joshuartaylor/TheRecreator3D/Print Examples/271875373_10227794862356294_2848248221167341705_n.jpg

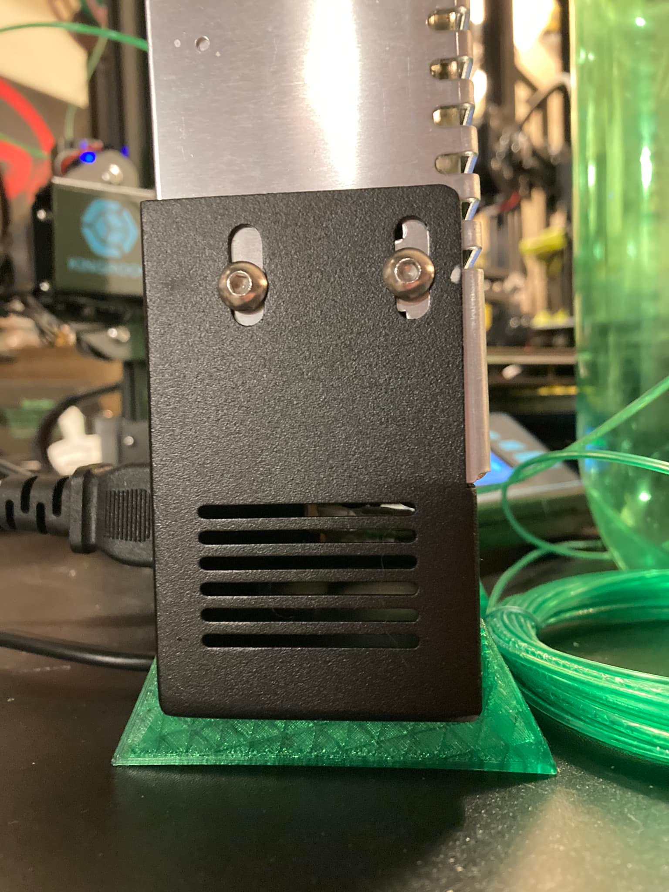
Print Examples/271875373_10227794862356294_2848248221167341705_n.jpg
