joshuartaylor/TheRecreator3D/Print Examples/204751988_10226476140269066_6664716208984511752_n.jpg

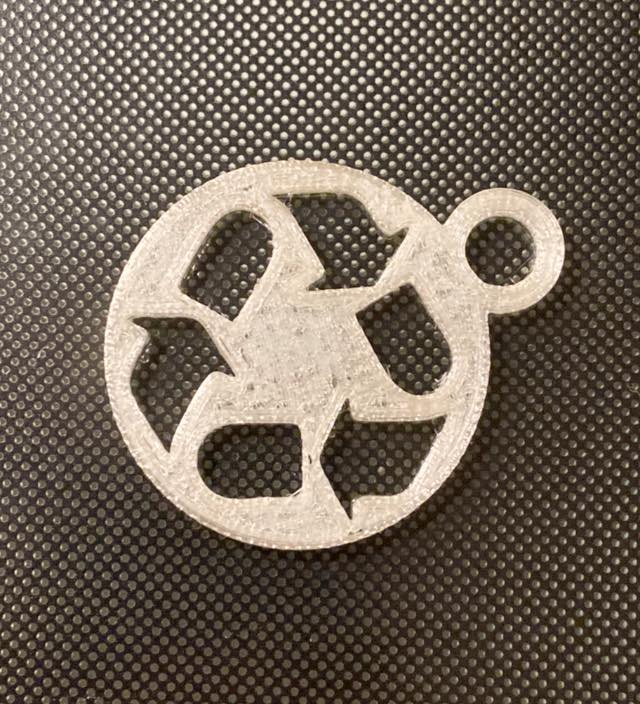
Print Examples/204751988_10226476140269066_6664716208984511752_n.jpg
