joshuartaylor/TheRecreator3D/README.md

# TheRecreator3D
 DIY 3D Printer Filament From Soda Bottles
