joshuartaylor/TheRecreator3D/Recreator3D Accessories/Community Bottle Dryer/Community Bottle Dryer.pdf

The Recreator3D
Community Bottle Dryer

Prints on a 200x200 Bed

Uses a 40MM Fan for Air Circulation

To Power the Fan, Use a 5 Volt Fan and Wire it into
a 5 Volt Power Cord for a Phone Charger or equivalent.
Just make sure to use a power source that matches your Fan's Voltage
to avoid electrical issues.

Place the fan in the center of the dryer. Sticker facing down (blowing inward). You can secure it with screws - though it's not needed.
Place the Fan Cover on top of the fan to avoid electrical water damage.

Remove the bottle label, clean the glue off and wash your bottle.
Place a bottle onto a pipe. The dryer holds 8 bottles.

A 5 Volt fan was able to help circulate the air
enough to dry the bottles in under 1 hour.
It's taken a couple days otherwise.
This definitely improves and speeds up a production routine.

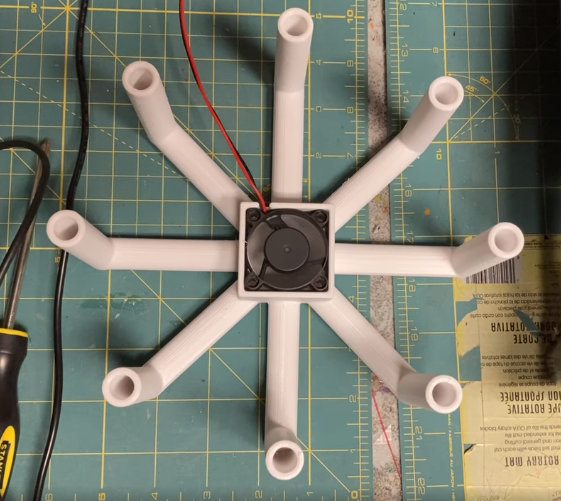
[picture p3: figure]
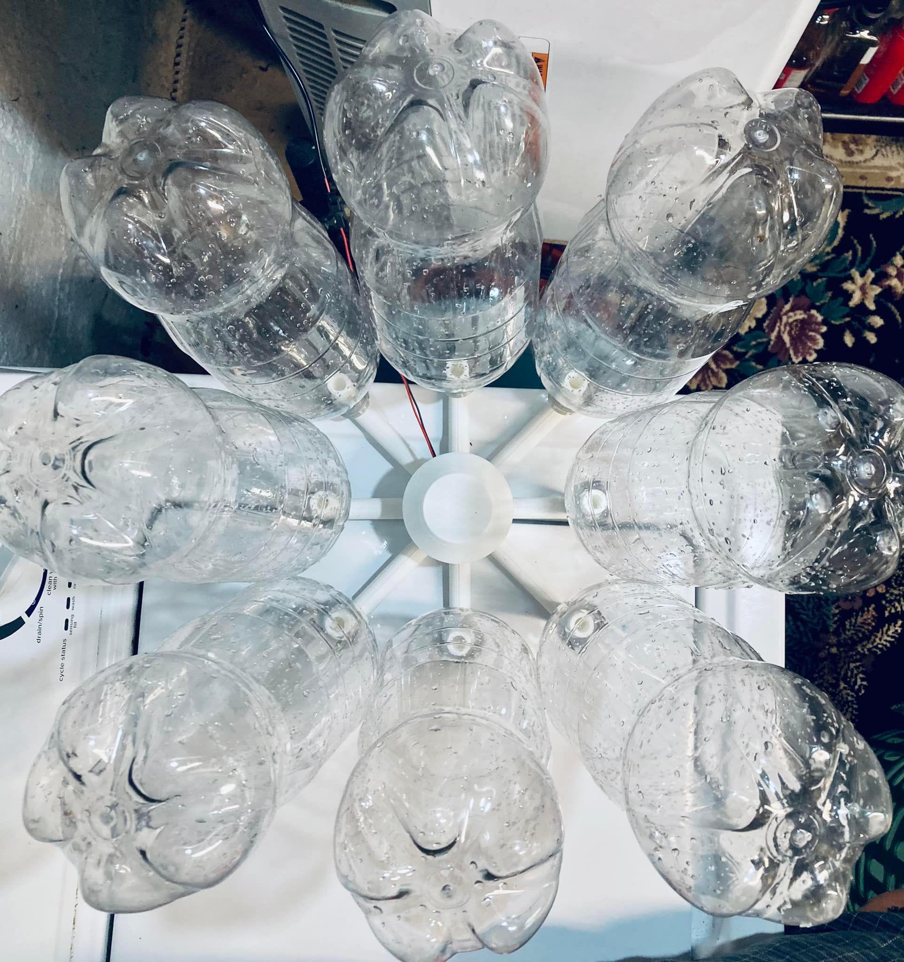
[picture p4: figure]
