joshuartaylor/TheRecreator3D/Promotional Art/CaptainRecreatorColor.jpg

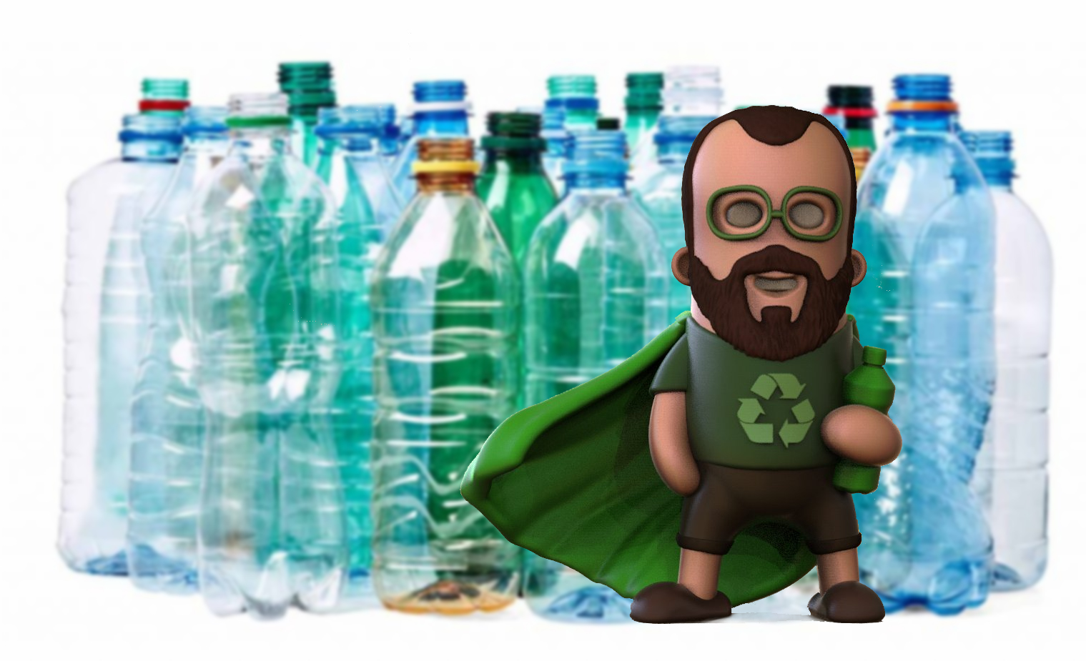
Promotional Art/CaptainRecreatorColor.jpg
