joshuartaylor/TheRecreator3D/Promotional Art/MK3LITE.jpg

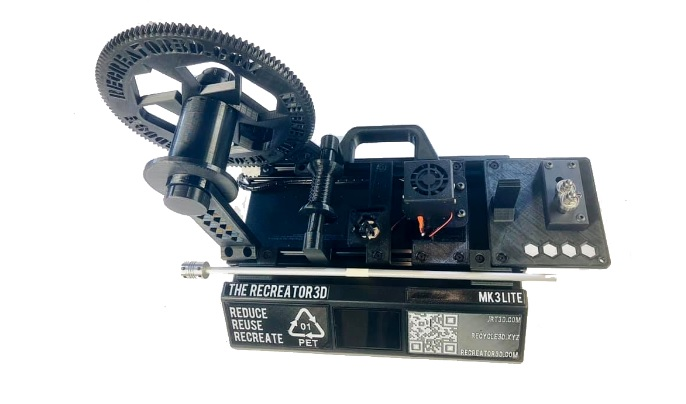
Promotional Art/MK3LITE.jpg
