joshuartaylor/TheRecreator3D/Promotional Art/MK5KIT.png

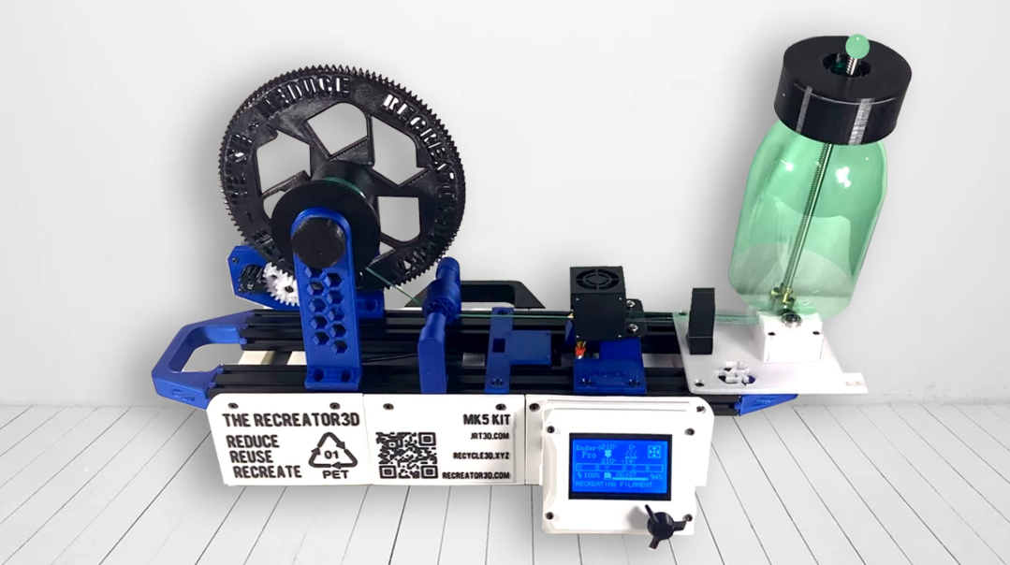
Promotional Art/MK5KIT.png
