joshuartaylor/TheRecreator3D/Recreator3D Accessories/Community Bottle Cutter/Photo Examples/Lead-Screw-Coupler.jpg

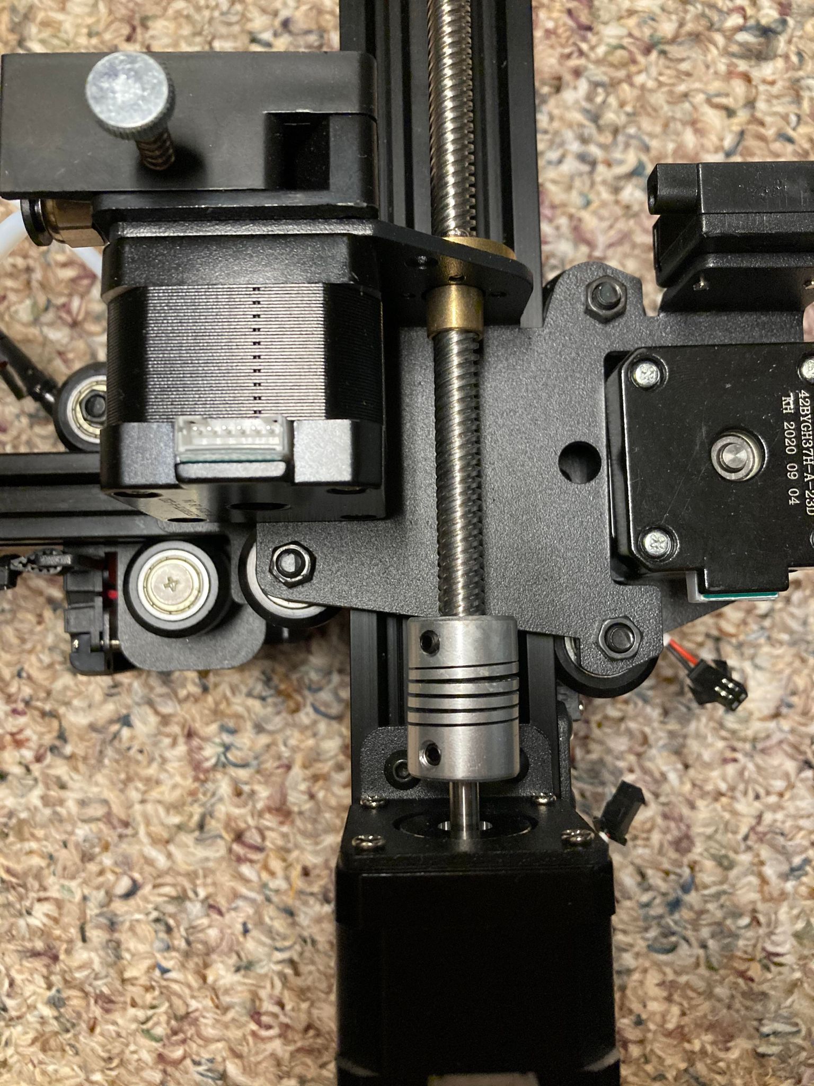
Recreator3D Accessories/Community Bottle Cutter/Photo Examples/Lead-Screw-Coupler.jpg
