joshuartaylor/TheRecreator3D/Recreator3D Accessories/Community Bottle Cutter/Photo Examples/Lead-Screw-Nut-Screws.jpg

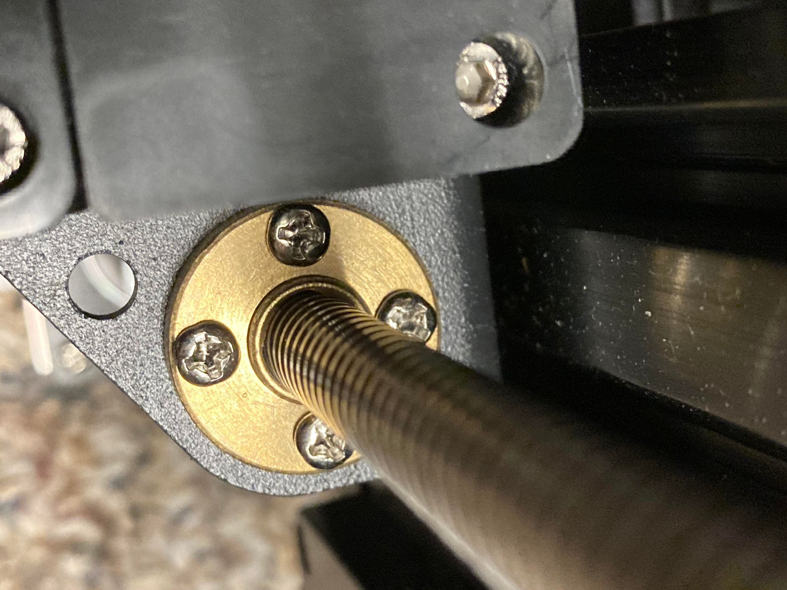
Recreator3D Accessories/Community Bottle Cutter/Photo Examples/Lead-Screw-Nut-Screws.jpg
