joshuartaylor/TheRecreator3D/Recreator3D Accessories/Community Bottle Cutter/Photo Examples/M5x34Bolts-Nuts.jpg

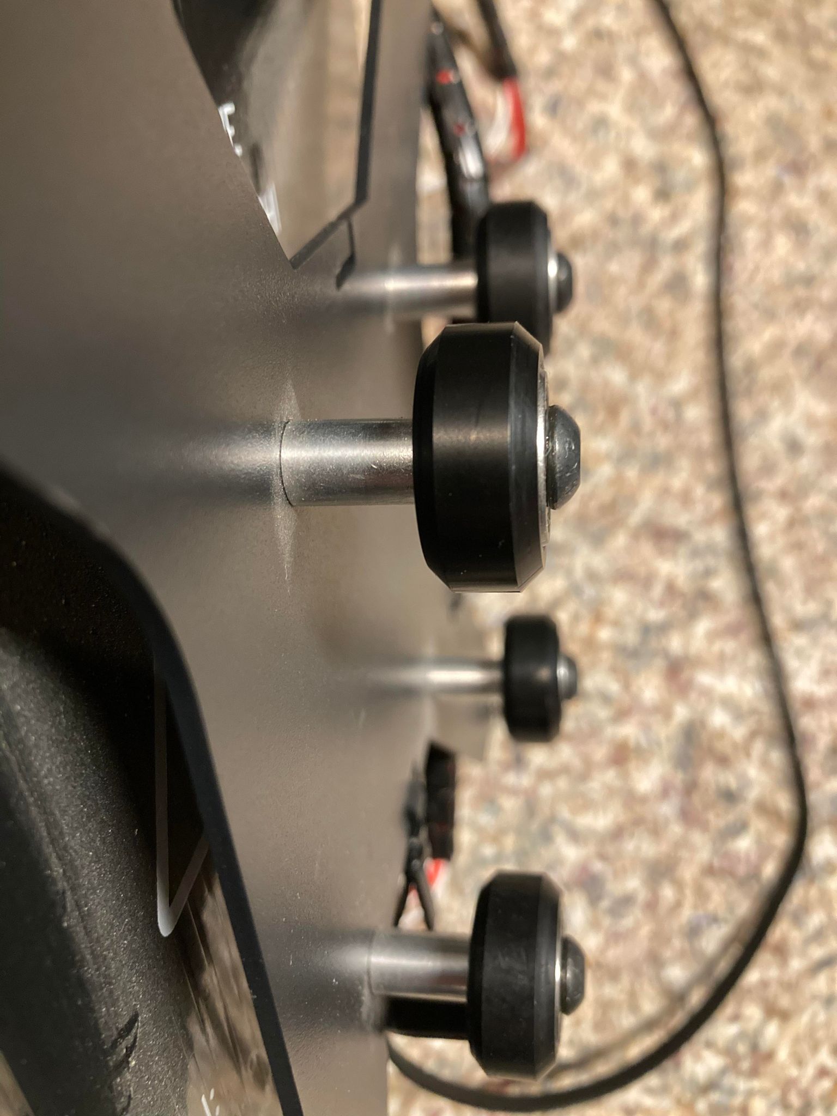
Recreator3D Accessories/Community Bottle Cutter/Photo Examples/M5x34Bolts-Nuts.jpg
