joshuartaylor/TheRecreator3D/Recreator3D Accessories/Community Bottle Cutter/Photo Examples/Pennies.jpg

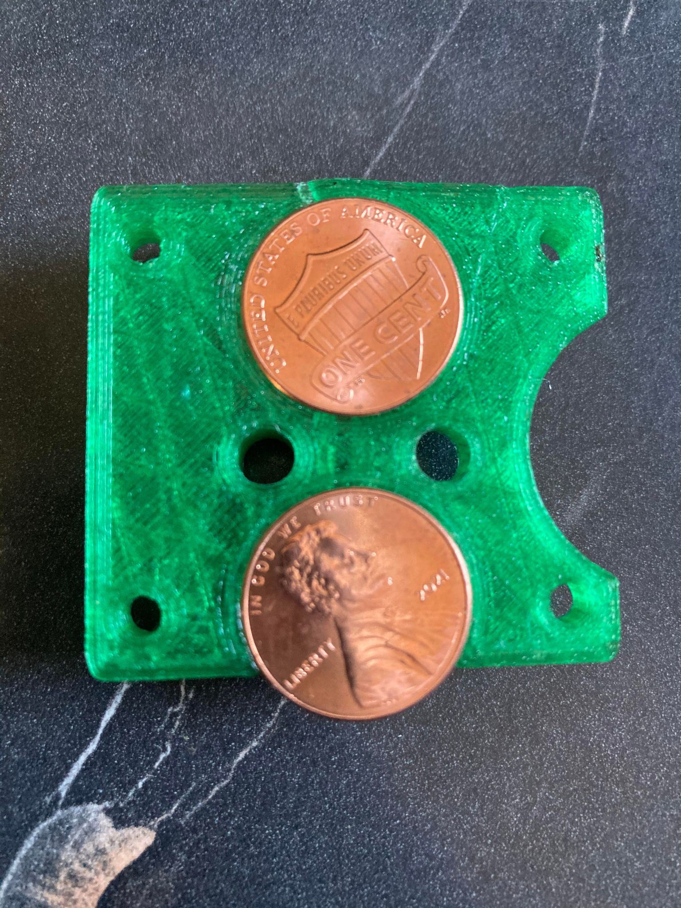
Recreator3D Accessories/Community Bottle Cutter/Photo Examples/Pennies.jpg
