joshuartaylor/TheRecreator3D/Recreator3D Accessories/Community Bottle Cutter/Photo Examples/Recreator3D-CommunityBottleCutter.jpg

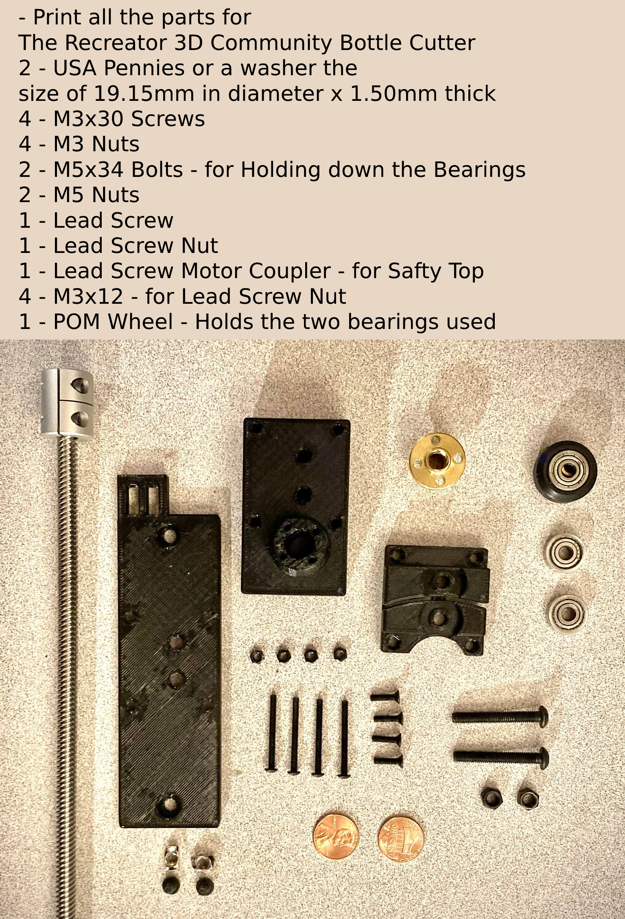
Recreator3D Accessories/Community Bottle Cutter/Photo Examples/Recreator3D-CommunityBottleCutter.jpg
