joshuartaylor/TheRecreator3D/Slicer Profiles/CURA Slicer Settings for PET1.jpg

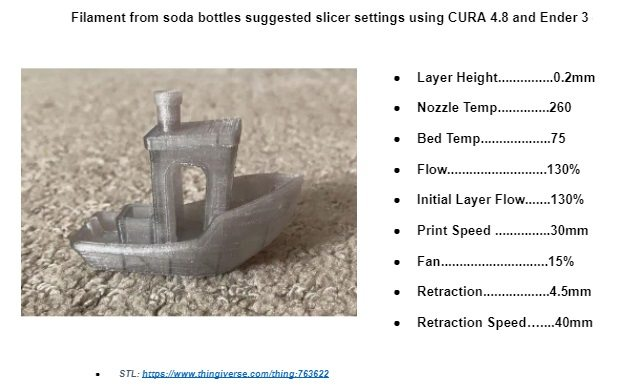
Slicer Profiles/CURA Slicer Settings for PET1.jpg
