joshuartaylor/TheRecreator3D/Recreator3D Build Files/Recreator3D - MK5 KIT- Ender 3 Files/02 - Bottom Parts/Handle/NOTES.txt

Print one or the other depending on your screws.

Side mount uses m4X8 and Tnuts

or the standard uses m5x20 with a socket or a button head screw
