joshuartaylor/TheRecreator3D/Recreator3D Build Files/Recreator3D - MK5 KIT- Ender 3 Files/02 - Bottom Parts/Power Supply/NOTES.txt

Print the model depending on the size of your power supply being used.

Large for most standard power supplies.

Slim for the thiner variants.

Small for the compact models.
