joshuartaylor/TheRecreator3D/Extras - Fun Things to Print/Recreator3D PET1 Color Swatch.stl

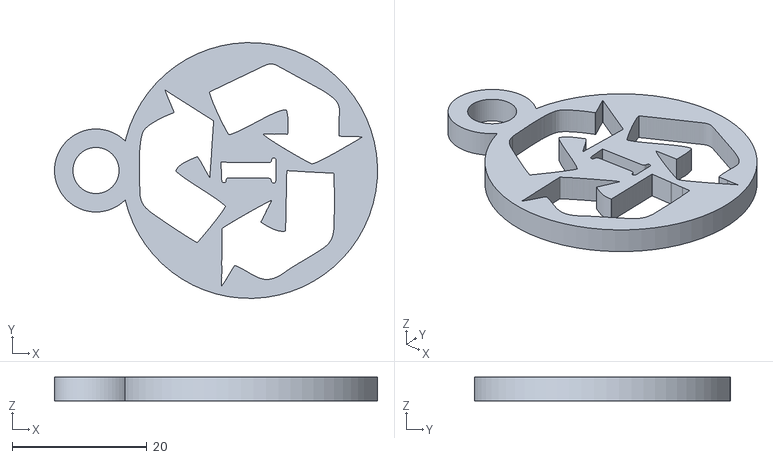
[picture p14: CAD file, 2022-06-20]
Extras - Fun Things to Print/Recreator3D PET1 Color Swatch.stl
48.0 x 38.0 x 3.50
