joshuartaylor/TheRecreator3D/Motor Spooler Designs/MK3Dual/RECREATOR3D - Part C - Small Gear.stl

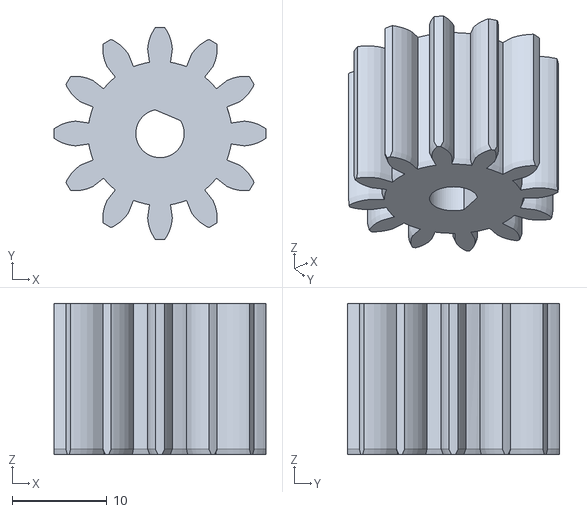
[picture p15: CAD file, 2022-06-20]
Motor Spooler Designs/MK3Dual/RECREATOR3D - Part C - Small Gear.stl
22.4 x 22.4 x 16.0
