joshuartaylor/TheRecreator3D/Motor Spooler Designs/MK3Single/RECREATOR3D - Part B - Spool Holder - LITE - Single Attached Motor.stl

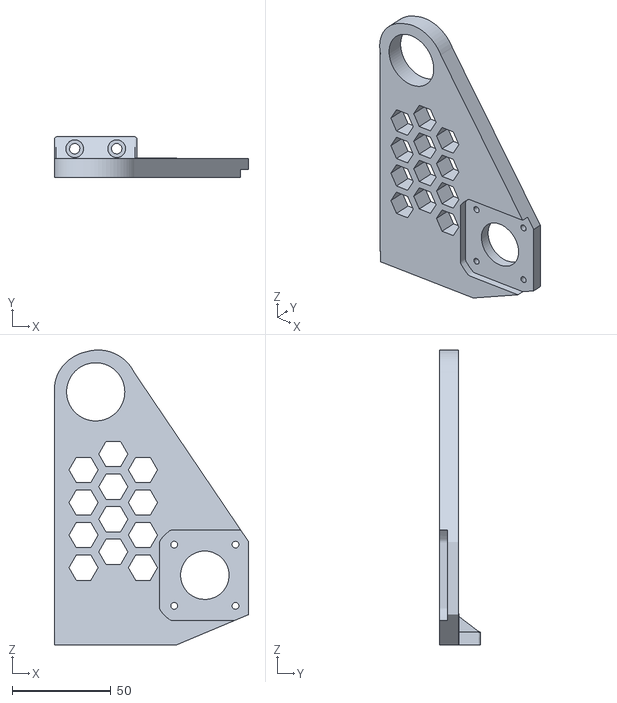
[picture p16: CAD file, 2022-06-20]
Motor Spooler Designs/MK3Single/RECREATOR3D - Part B - Spool Holder - LITE - Single Attached Motor.stl
98.3 x 20.9 x 149.3
