joshuartaylor/TheRecreator3D/Motor Spooler Designs/MK4Mini - Original by Nick Jones - Looser/Mini-SmallGear2x.stl

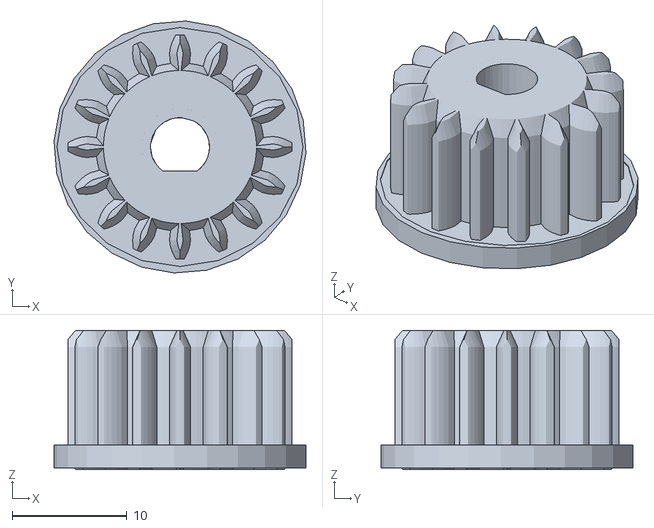
[picture p17: CAD file, 2022-06-20]
Motor Spooler Designs/MK4Mini - Original by Nick Jones - Looser/Mini-SmallGear2x.stl
22.0 x 22.0 x 12.2
