joshuartaylor/TheRecreator3D/Motor Spooler Designs/MK4Mini - Remixed by JRT3D - Tighter/MK4Mini - Spool.stl

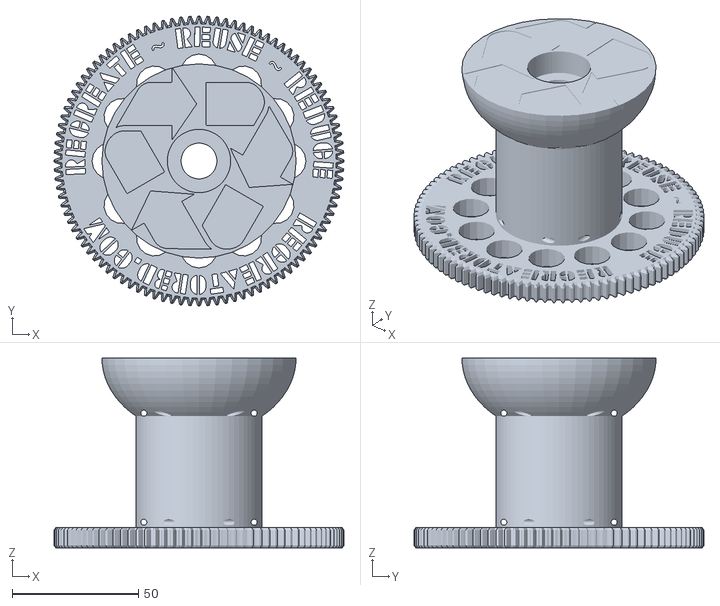
[picture p18: CAD file, 2022-06-20]
Motor Spooler Designs/MK4Mini - Remixed by JRT3D - Tighter/MK4Mini - Spool.stl
115.0 x 115.0 x 75.2
