joshuartaylor/TheRecreator3D/Motor Spooler Designs/MK5DoubleGearedSingle/Front Spool Holder.stl

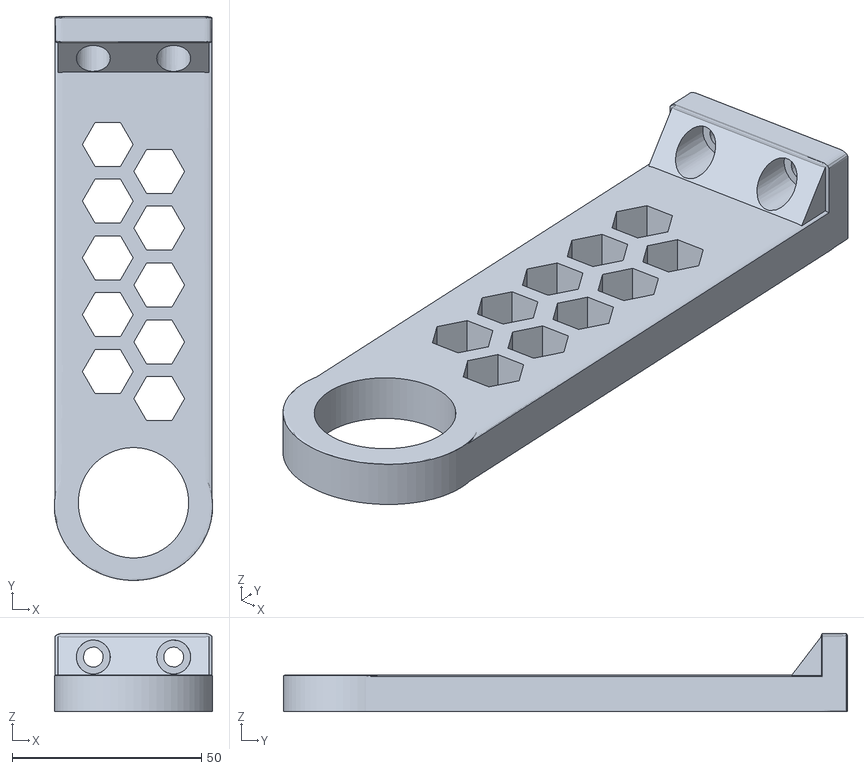
[picture p19: CAD file, 2022-06-20]
Motor Spooler Designs/MK5DoubleGearedSingle/Front Spool Holder.stl
41.9 x 149.1 x 20.7
