joshuartaylor/TheRecreator3D/Recreator3D Accessories/Colorizer/Recreator3D - Colorizer.stl

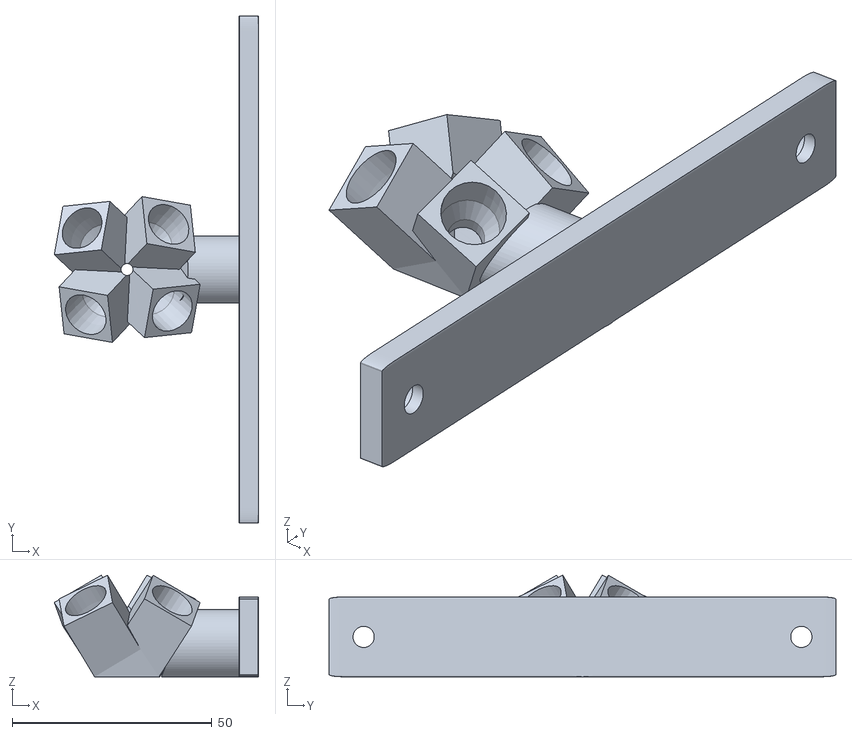
[picture p20: CAD file, 2022-06-20]
Recreator3D Accessories/Colorizer/Recreator3D - Colorizer.stl
51.2 x 127.0 x 25.5
