joshuartaylor/TheRecreator3D/Recreator3D Accessories/Community Bottle Cutter/STL Files/New - Wider/Bottle Cutter - Top - 7.5mm (NEW) - Pennies.stl

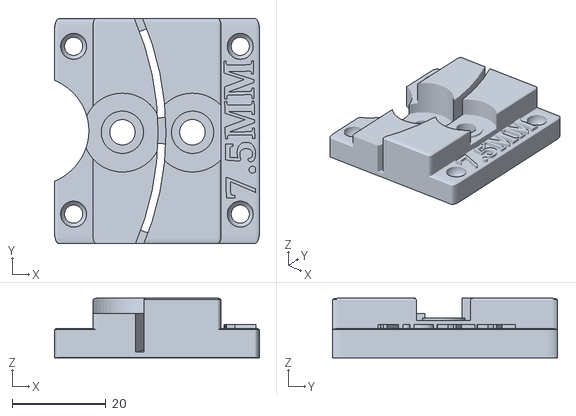
[picture p21: CAD file, 2022-06-20]
Recreator3D Accessories/Community Bottle Cutter/STL Files/New - Wider/Bottle Cutter - Top - 7.5mm (NEW) - Pennies.stl
43.6 x 48.0 x 12.7
