joshuartaylor/TheRecreator3D/Recreator3D Accessories/Community Bottle Cutter/STL Files/Original - Thinner/BottleCutter-Middle.stl

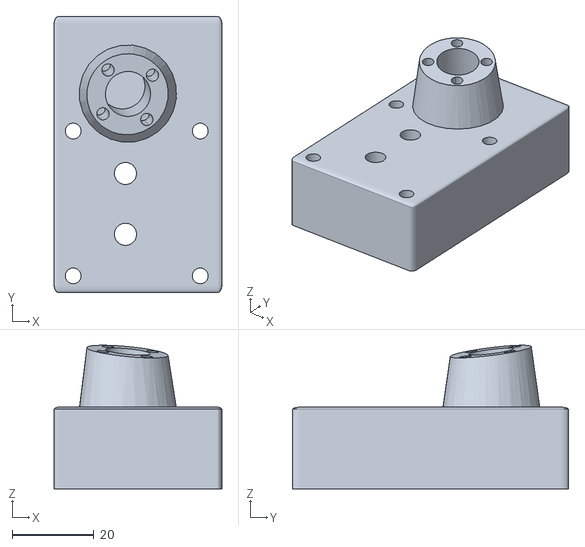
[picture p22: CAD file, 2022-06-20]
Recreator3D Accessories/Community Bottle Cutter/STL Files/Original - Thinner/BottleCutter-Middle.stl
41.1 x 67.6 x 35.2
