joshuartaylor/TheRecreator3D/Recreator3D Accessories/Community Bottle Dryer/Bottle Dryer Fan Cover.stl

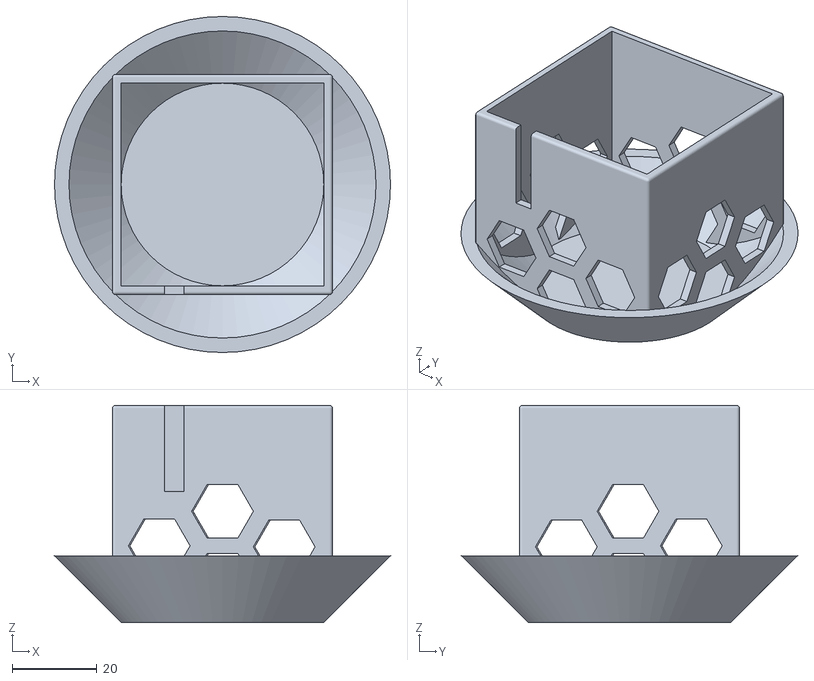
[picture p23: CAD file, 2022-06-20]
Recreator3D Accessories/Community Bottle Dryer/Bottle Dryer Fan Cover.stl
79.4 x 79.4 x 51.3
