joshuartaylor/TheRecreator3D/Recreator3D Accessories/Pre-Strip Mini Spool Holder/MiniSpooler-Mount.stl

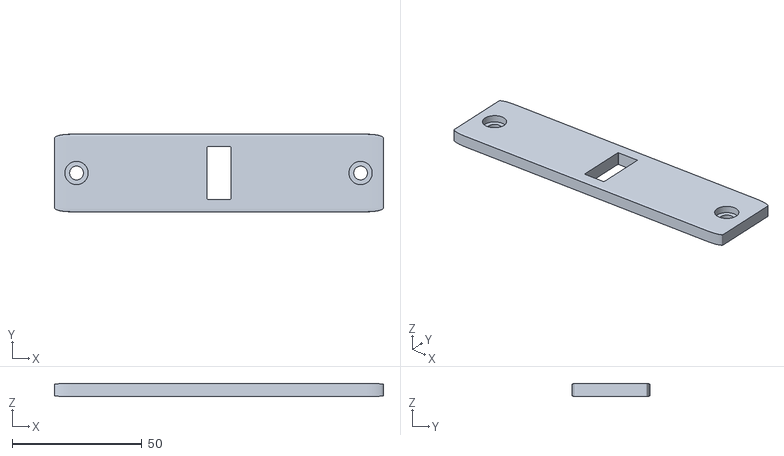
[picture p24: CAD file, 2022-06-20]
Recreator3D Accessories/Pre-Strip Mini Spool Holder/MiniSpooler-Mount.stl
127.0 x 30.0 x 5.00
