joshuartaylor/TheRecreator3D/Recreator3D Build Files/Recreator3D - MK3 - Lite and Pro Files/Modifications/Community Bottle Cutter/STL Files/New - Wider/Bottle Cutter - Base (NEW).stl

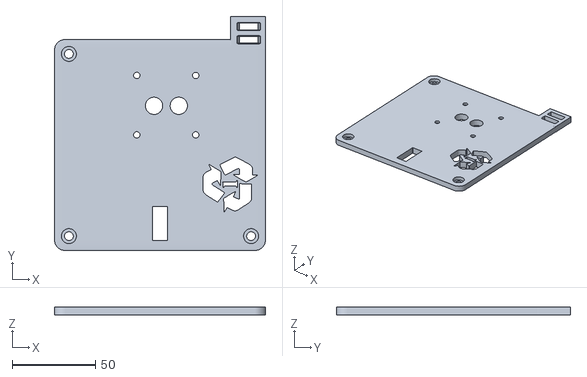
[picture p25: CAD file, 2022-06-20]
Recreator3D Build Files/Recreator3D - MK3 - Lite and Pro Files/Modifications/Community Bottle Cutter/STL Files/New - Wider/Bottle Cutter - Base (NEW).stl
127.0 x 140.9 x 5.00
