joshuartaylor/TheRecreator3D/Recreator3D Build Files/Recreator3D - MK5 KIT- Ender 3 Files/01 - Top Parts/RECREATOR3D - Part 10 - Handle.stl

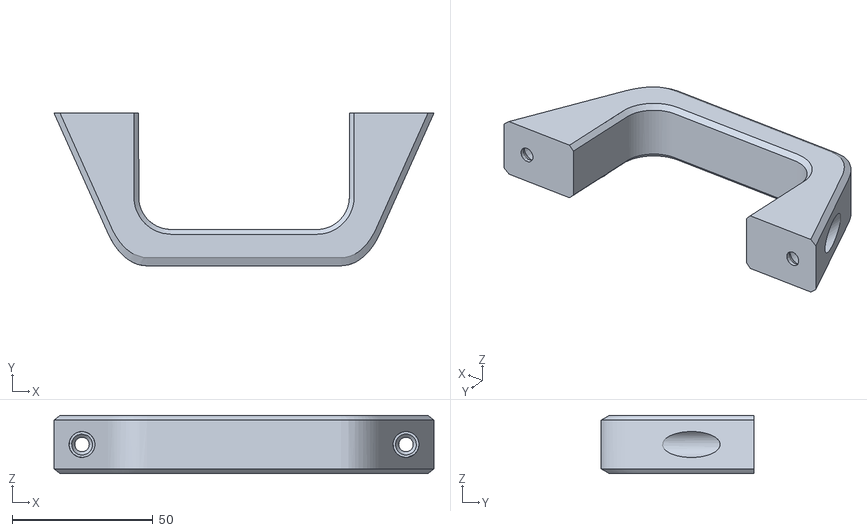
[picture p27: CAD file, 2022-06-20]
Recreator3D Build Files/Recreator3D - MK5 KIT- Ender 3 Files/01 - Top Parts/RECREATOR3D - Part 10 - Handle.stl
134.9 x 54.2 x 20.7
