joshuartaylor/TheRecreator3D/Recreator3D Build Files/Recreator3D - MK5 KIT- Ender 3 Files/02 - Bottom Parts/Handle/MK5Kit-HandleWithSideMount-2X.stl

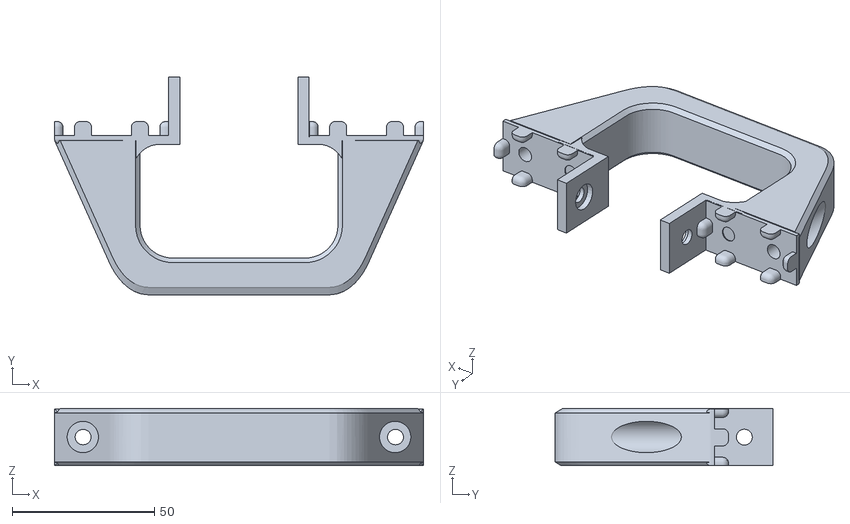
[picture p28: CAD file, 2022-06-20]
Recreator3D Build Files/Recreator3D - MK5 KIT- Ender 3 Files/02 - Bottom Parts/Handle/MK5Kit-HandleWithSideMount-2X.stl
129.7 x 76.5 x 20.1
