joshuartaylor/TheRecreator3D/Recreator3D Build Files/Recreator3D - MK5 KIT- Ender 3 Files/02 - Bottom Parts/MK5Kit-Feet-6X.stl

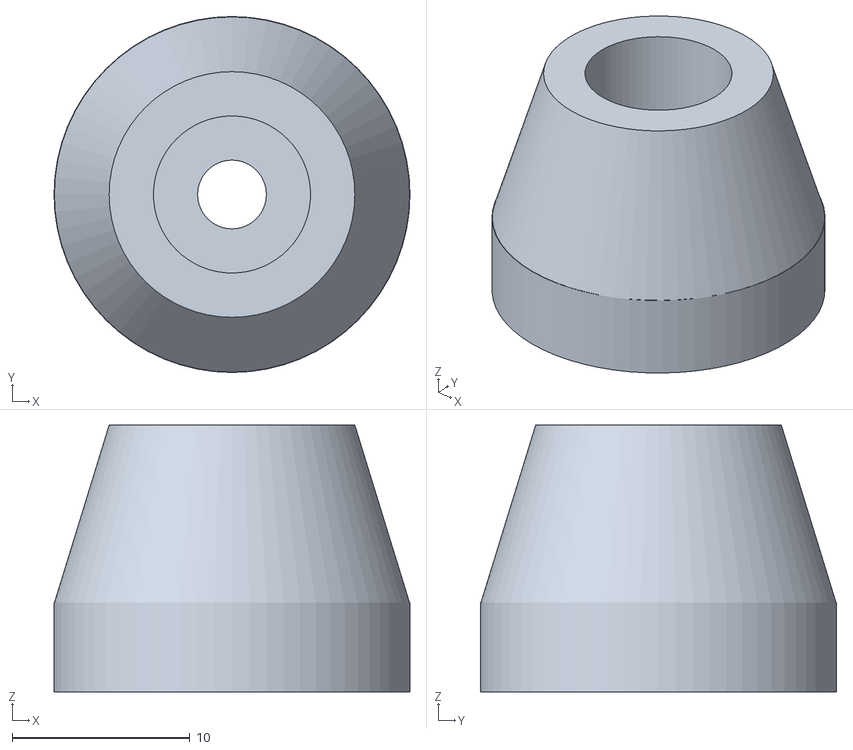
[picture p29: CAD file, 2022-06-20]
Recreator3D Build Files/Recreator3D - MK5 KIT- Ender 3 Files/02 - Bottom Parts/MK5Kit-Feet-6X.stl
20.0 x 20.0 x 15.0
