joshuartaylor/TheRecreator3D/Recreator3D Build Files/Recreator3D - MK5 KIT- Ender 3 Files/02 - Bottom Parts/Power Supply/MK5Kit-SlimPowerSupply-2X.stl

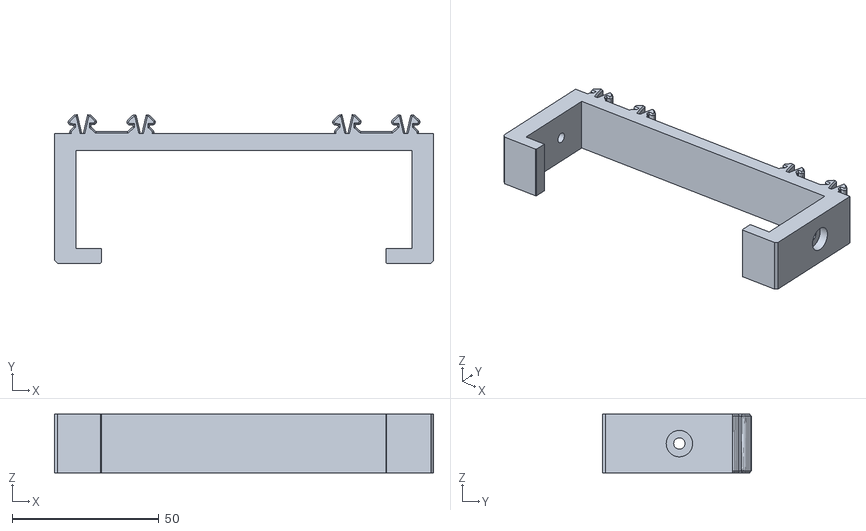
[picture p30: CAD file, 2022-06-20]
Recreator3D Build Files/Recreator3D - MK5 KIT- Ender 3 Files/02 - Bottom Parts/Power Supply/MK5Kit-SlimPowerSupply-2X.stl
129.3 x 50.7 x 20.0
