joshuartaylor/TheRecreator3D/Recreator3D Build Files/Recreator3D - MK5 KIT- Ender 3 Files/03 - Modifications/Community Bottle Cutter/STL Files/BottleWeight-Top.stl

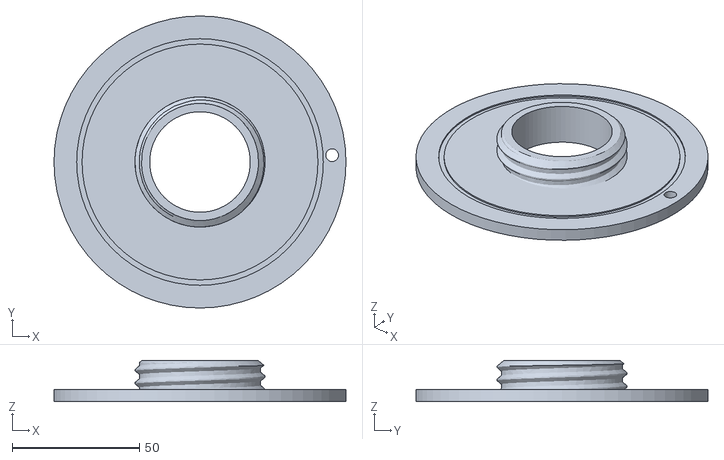
[picture p31: CAD file, 2022-06-20]
Recreator3D Build Files/Recreator3D - MK5 KIT- Ender 3 Files/03 - Modifications/Community Bottle Cutter/STL Files/BottleWeight-Top.stl
114.9 x 114.9 x 16.2
