joshuartaylor/TheRecreator3D/Recreator3D Build Files/Recreator3D - MK5 KIT- Ender 3 Files/03 - Modifications/Pre-Strip Mini Spool Holder/MiniSpooler-Spooler Winder.stl

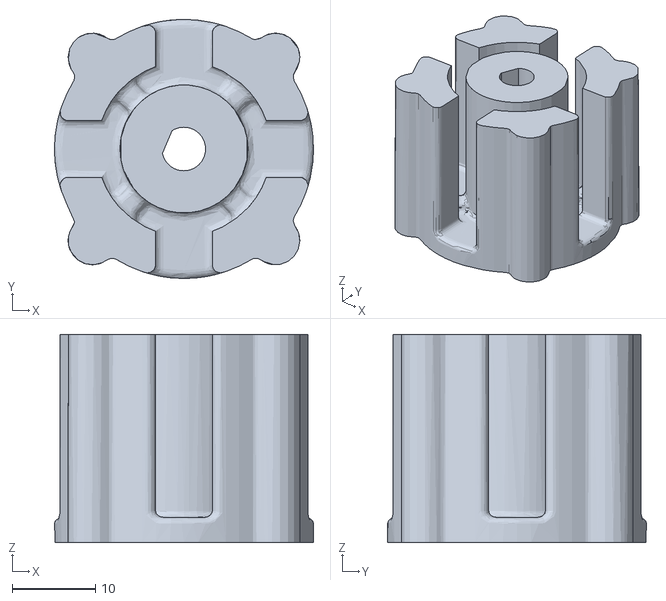
[picture p32: CAD file, 2022-06-20]
Recreator3D Build Files/Recreator3D - MK5 KIT- Ender 3 Files/03 - Modifications/Pre-Strip Mini Spool Holder/MiniSpooler-Spooler Winder.stl
31.1 x 31.1 x 25.0
