joshuartaylor/TheRecreator3D/Recreator3D Build Files/Recreator3D - MK5 KIT- Ender 3 Files/05 - Extras - Fun Things to Print/The Recreator 3D Keychain.stl

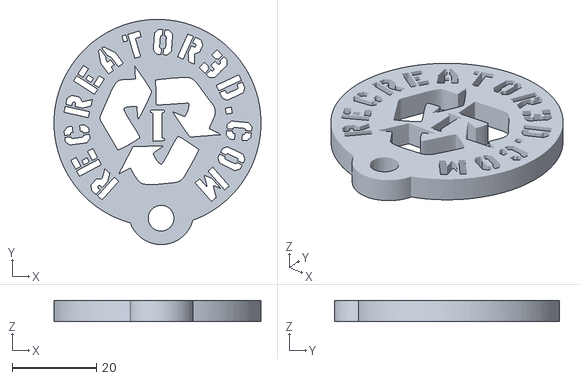
[picture p33: CAD file, 2022-06-20]
Recreator3D Build Files/Recreator3D - MK5 KIT- Ender 3 Files/05 - Extras - Fun Things to Print/The Recreator 3D Keychain.stl
49.0 x 53.3 x 5.00
