joshuartaylor/TheRecreator3D/Motor Spooler Designs/MK4Mini - Original by Nick Jones - Looser/Mini Spool Holder v2 Motor Side.stl

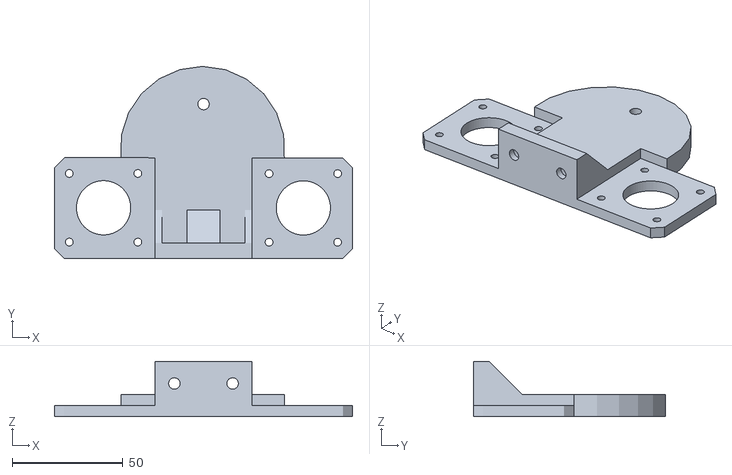
[picture p34: CAD file, 2022-06-20]
Motor Spooler Designs/MK4Mini - Original by Nick Jones - Looser/Mini Spool Holder v2 Motor Side.stl
134.7 x 86.8 x 25.0
