joshuartaylor/TheRecreator3D/Motor Spooler Designs/MK4Mini - Remixed by JRT3D - Tighter/MK4Mini-Front Mount Botton.stl

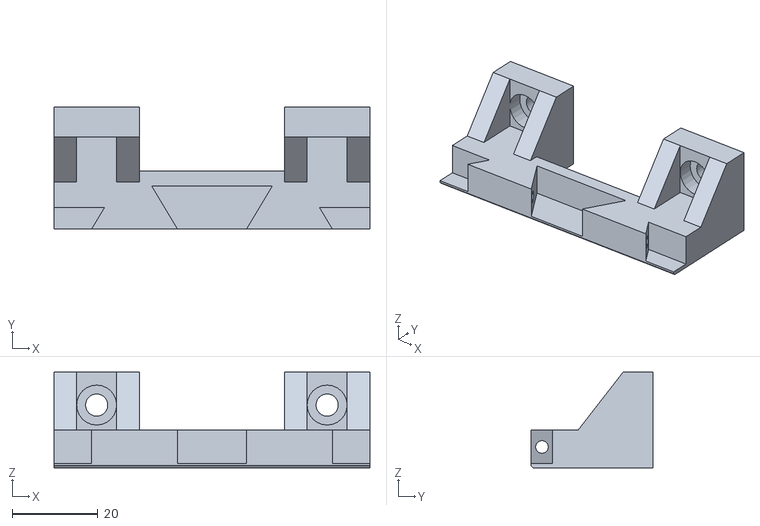
[picture p35: CAD file, 2022-06-20]
Motor Spooler Designs/MK4Mini - Remixed by JRT3D - Tighter/MK4Mini-Front Mount Botton.stl
73.9 x 28.5 x 22.4
