joshuartaylor/TheRecreator3D/Recreator3D Accessories/Community Bottle Dryer/Bottle Dryer for 2L Bottles.stl

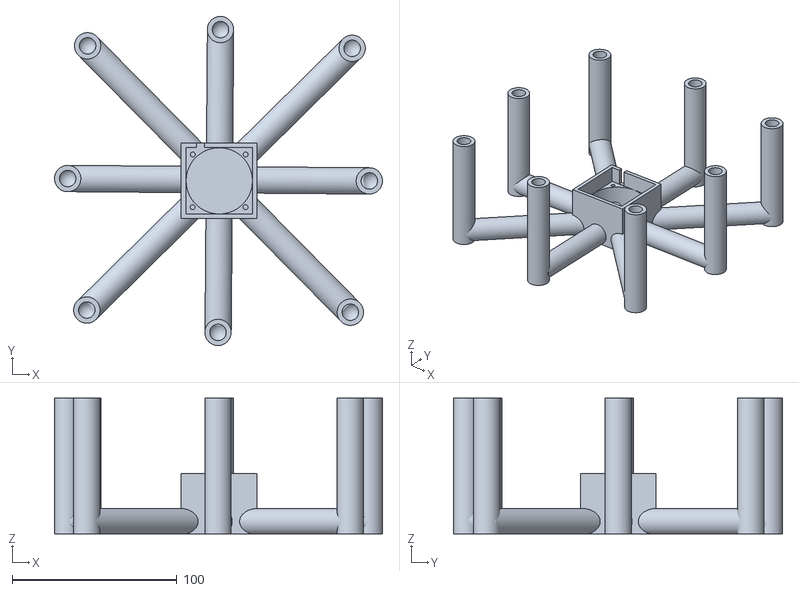
[picture p36: CAD file, 2022-06-20]
Recreator3D Accessories/Community Bottle Dryer/Bottle Dryer for 2L Bottles.stl
199.2 x 199.9 x 82.5
