joshuartaylor/TheRecreator3D/Recreator3D Build Files/Recreator3D - MK3 - Lite and Pro Files/Modifications/Community Bottle Cutter/STL Files/New - Wider/Bottle Cutter - Middle (NEW).stl

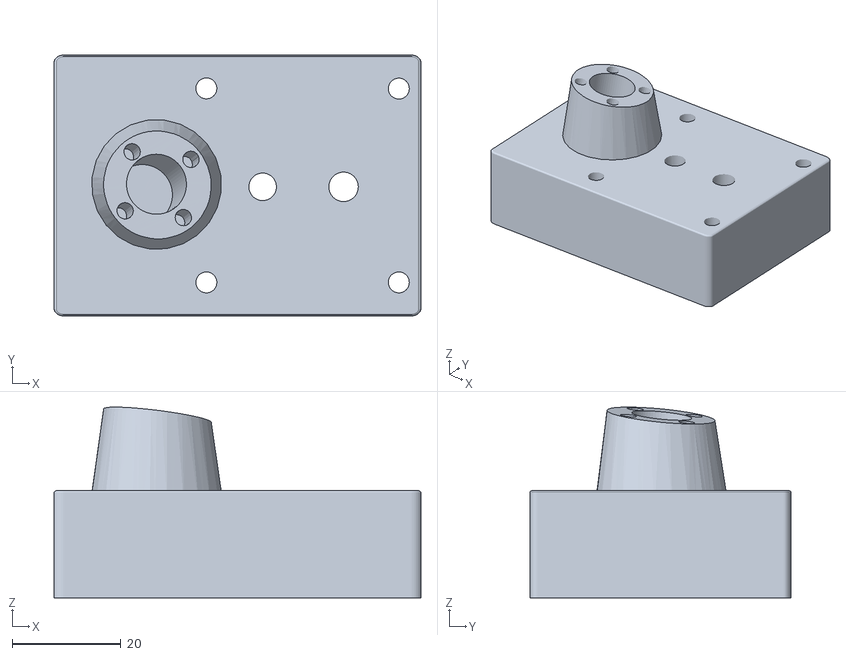
[picture p37: CAD file, 2022-06-20]
Recreator3D Build Files/Recreator3D - MK3 - Lite and Pro Files/Modifications/Community Bottle Cutter/STL Files/New - Wider/Bottle Cutter - Middle (NEW).stl
67.6 x 48.1 x 35.2
