joshuartaylor/TheRecreator3D/Recreator3D Build Files/Recreator3D - MK3 - Lite and Pro Files/Modifications/MK4Mini - Original by Nick Jones - Looser/Blower Fan Mount_v2.1.stl

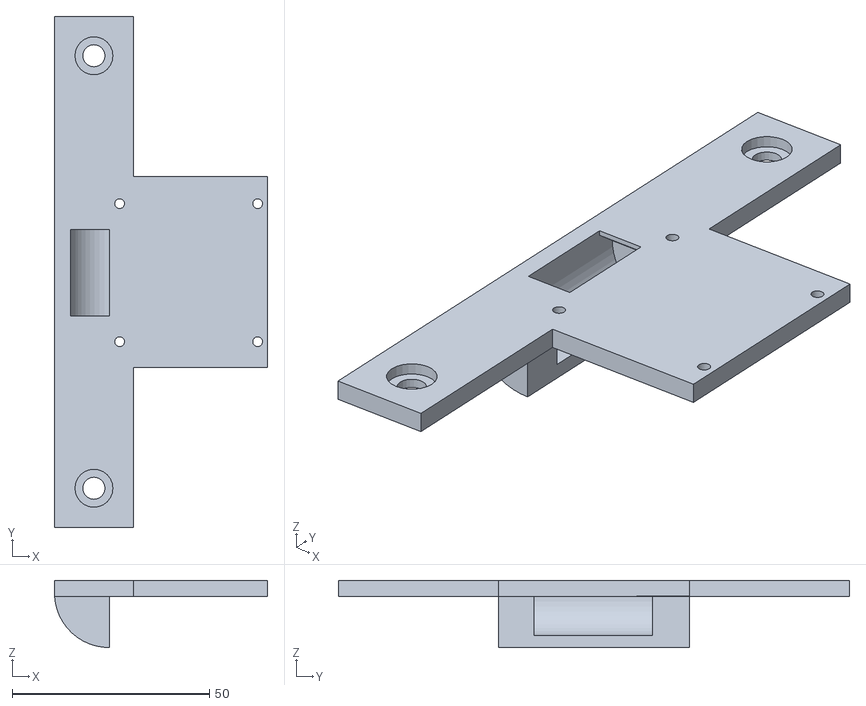
[picture p38: CAD file, 2022-06-20]
Recreator3D Build Files/Recreator3D - MK3 - Lite and Pro Files/Modifications/MK4Mini - Original by Nick Jones - Looser/Blower Fan Mount_v2.1.stl
54.0 x 129.7 x 17.0
