joshuartaylor/TheRecreator3D/Recreator3D Build Files/Recreator3D - MK3 - Lite and Pro Files/Modifications/MK4Mini - Remixed by JRT3D - Tighter/MK4Mini-Front Mount Top.stl

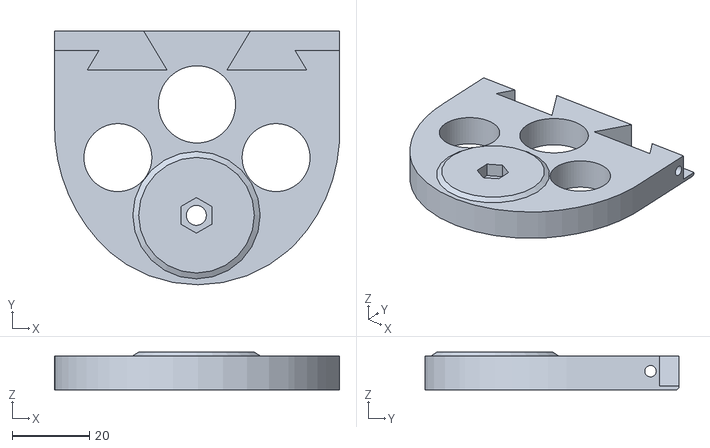
[picture p39: CAD file, 2022-06-20]
Recreator3D Build Files/Recreator3D - MK3 - Lite and Pro Files/Modifications/MK4Mini - Remixed by JRT3D - Tighter/MK4Mini-Front Mount Top.stl
73.9 x 65.8 x 9.85
