joshuartaylor/TheRecreator3D/Recreator3D Build Files/Recreator3D - MK3 - Lite and Pro Files/Modifications/MK5DoubleGearedSingle/Back-Motor-Mount.stl

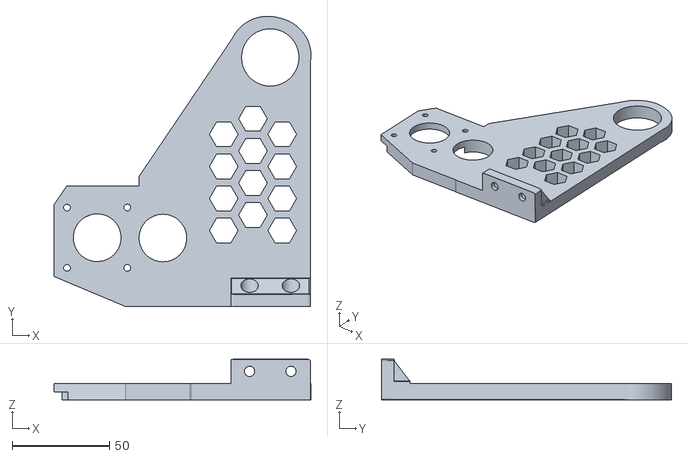
[picture p40: CAD file, 2022-06-20]
Recreator3D Build Files/Recreator3D - MK3 - Lite and Pro Files/Modifications/MK5DoubleGearedSingle/Back-Motor-Mount.stl
132.0 x 149.3 x 20.9
