joshuartaylor/TheRecreator3D/Recreator3D Build Files/Recreator3D - MK3 - Lite and Pro Files/Modifications/Pre-Strip Mini Spool Holder/MiniSpooler-Top.stl

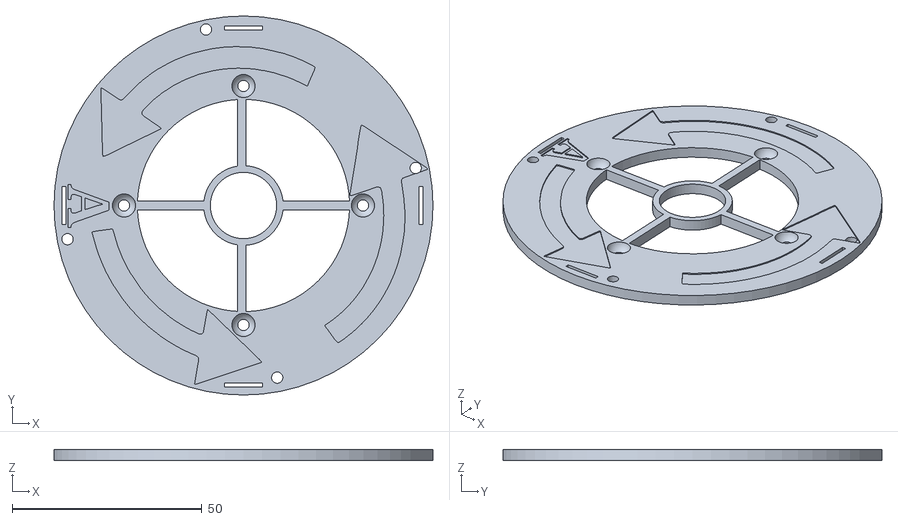
[picture p41: CAD file, 2022-06-20]
Recreator3D Build Files/Recreator3D - MK3 - Lite and Pro Files/Modifications/Pre-Strip Mini Spool Holder/MiniSpooler-Top.stl
100.0 x 100.0 x 2.89
