joshuartaylor/TheRecreator3D/Recreator3D Build Files/Recreator3D - MK3 - Lite and Pro Files/Part Files to Print/RECREATOR3D - Part 2 - Heater Block Plate - Ender 3 or CR10.stl

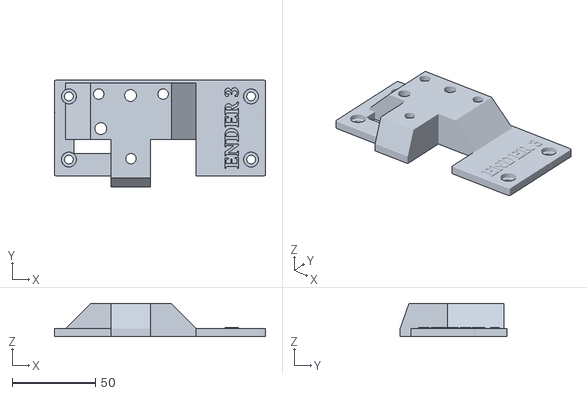
[picture p42: CAD file, 2022-06-20]
Recreator3D Build Files/Recreator3D - MK3 - Lite and Pro Files/Part Files to Print/RECREATOR3D - Part 2 - Heater Block Plate - Ender 3 or CR10.stl
127.0 x 64.6 x 20.1
