joshuartaylor/TheRecreator3D/Recreator3D Build Files/Recreator3D - MK5 KIT- Ender 3 Files/01 - Top Parts/RECREATOR3D - Part 7D - Spool Rod Spacer.stl

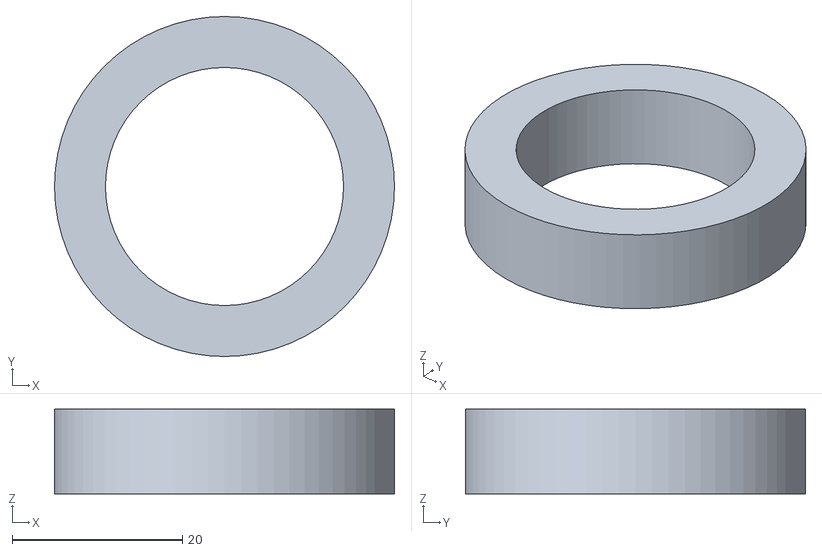
[picture p43: CAD file, 2022-06-20]
Recreator3D Build Files/Recreator3D - MK5 KIT- Ender 3 Files/01 - Top Parts/RECREATOR3D - Part 7D - Spool Rod Spacer.stl
40.0 x 40.0 x 10.00
