joshuartaylor/TheRecreator3D/Recreator3D Build Files/Recreator3D - MK5 KIT- Ender 3 Files/02 - Bottom Parts/MK5Kit-RightSideCaseLCD.stl

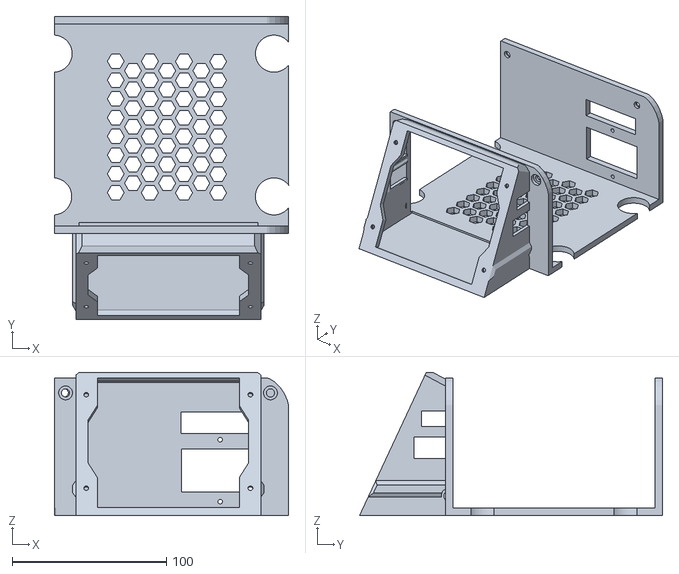
[picture p45: CAD file, 2022-06-20]
Recreator3D Build Files/Recreator3D - MK5 KIT- Ender 3 Files/02 - Bottom Parts/MK5Kit-RightSideCaseLCD.stl
151.9 x 196.7 x 92.9
