joshuartaylor/TheRecreator3D/Recreator3D Build Files/Recreator3D - MK5 KIT- Ender 3 Files/03 - Modifications/Pre-Strip Mini Spool Holder/MiniSpooler-Bracket.stl

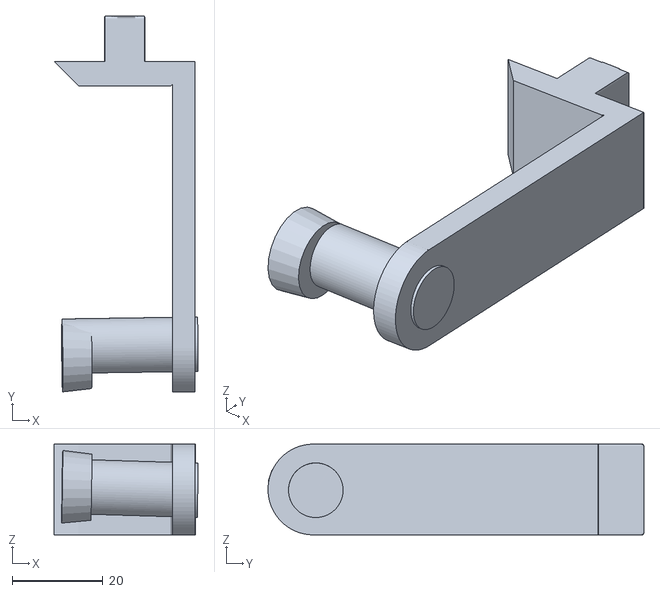
[picture p47: CAD file, 2022-06-20]
Recreator3D Build Files/Recreator3D - MK5 KIT- Ender 3 Files/03 - Modifications/Pre-Strip Mini Spool Holder/MiniSpooler-Bracket.stl
31.7 x 82.8 x 20.0
