joshuartaylor/TheRecreator3D/Recreator3D Build Files/Recreator3D - MK5 KIT- Ender 3 Files/05 - Extras - Fun Things to Print/The Recreator 3D Token.stl

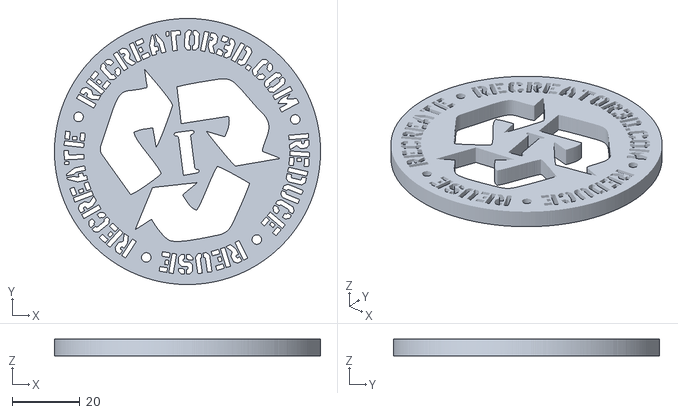
[picture p48: CAD file, 2022-06-20]
Recreator3D Build Files/Recreator3D - MK5 KIT- Ender 3 Files/05 - Extras - Fun Things to Print/The Recreator 3D Token.stl
78.6 x 78.6 x 5.00
