joshuartaylor/TheRecreator3D/Motor Spooler Designs/MK3Dual/RECREATOR3D - Part B - Spool Holder - PRO - DUAL MOTOR.stl

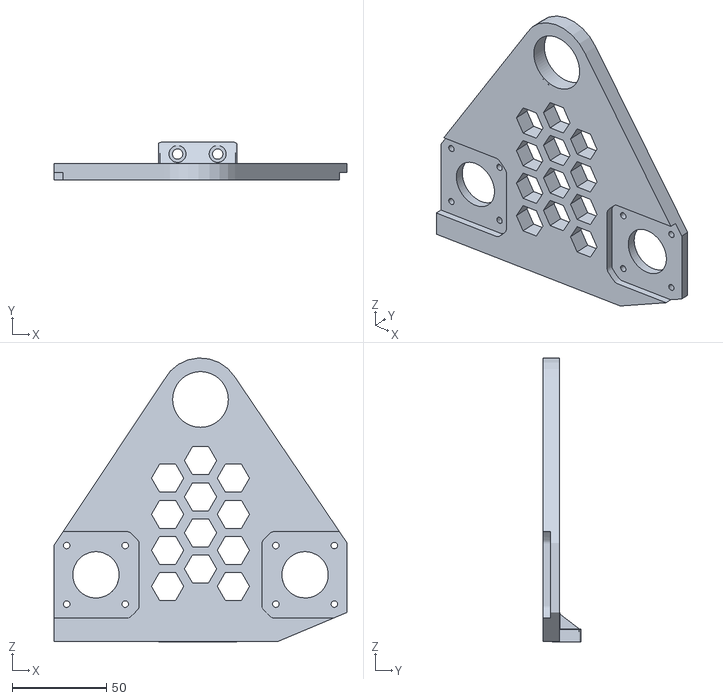
[picture p49: CAD file, 2022-06-20]
Motor Spooler Designs/MK3Dual/RECREATOR3D - Part B - Spool Holder - PRO - DUAL MOTOR.stl
155.1 x 20.0 x 150.3
