joshuartaylor/TheRecreator3D/Motor Spooler Designs/MK4Mini - Original by Nick Jones - Looser/Mini Spool v2.stl

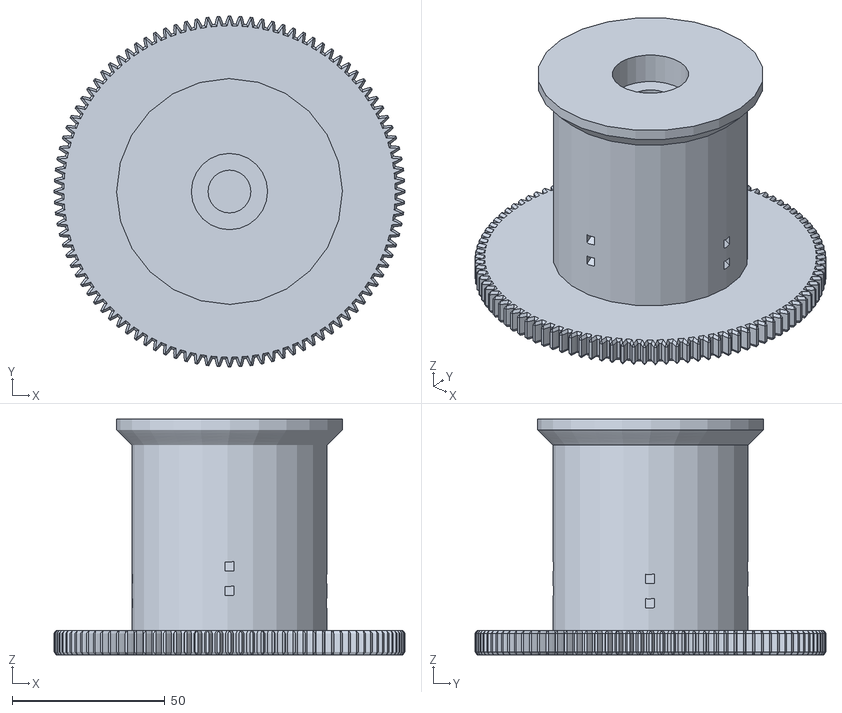
[picture p50: CAD file, 2022-06-20]
Motor Spooler Designs/MK4Mini - Original by Nick Jones - Looser/Mini Spool v2.stl
115.0 x 115.0 x 77.2
