joshuartaylor/TheRecreator3D/Motor Spooler Designs/MK4Mini - Remixed by JRT3D - Tighter/MK4Mini-Motor Mount.stl

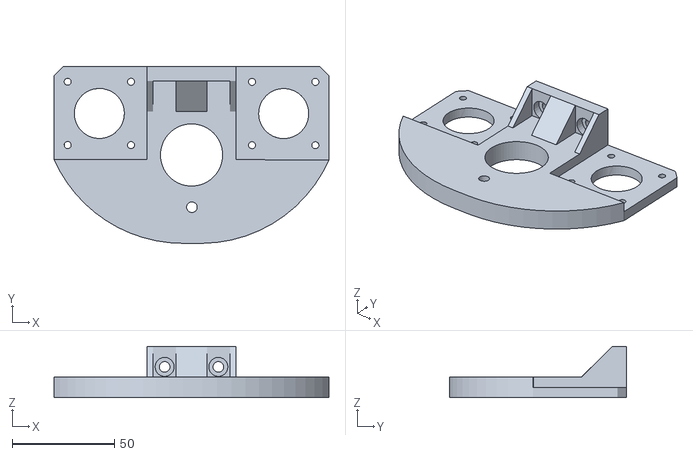
[picture p51: CAD file, 2022-06-20]
Motor Spooler Designs/MK4Mini - Remixed by JRT3D - Tighter/MK4Mini-Motor Mount.stl
134.7 x 86.5 x 25.0
