joshuartaylor/TheRecreator3D/Recreator3D Accessories/Community Bottle Cutter/STL Files/Original - Thinner/BottleCutter-Top-2xPennies - 8mm.stl

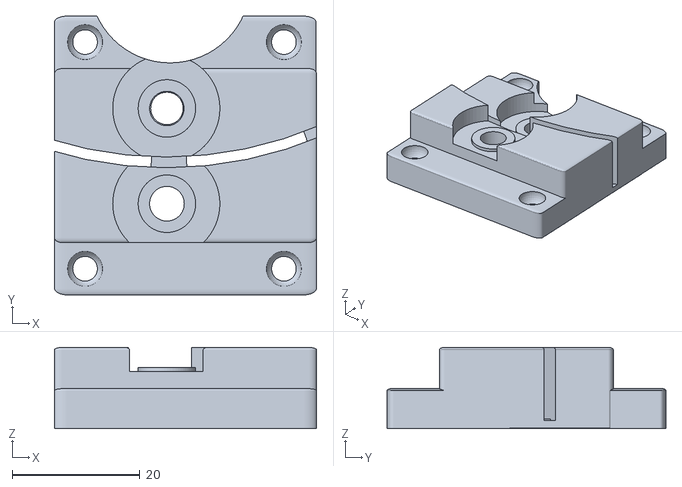
[picture p52: CAD file, 2022-06-20]
Recreator3D Accessories/Community Bottle Cutter/STL Files/Original - Thinner/BottleCutter-Top-2xPennies - 8mm.stl
41.0 x 43.6 x 12.7
