joshuartaylor/TheRecreator3D/Recreator3D Accessories/Community Bottle Dryer/Bottle Dryer for 1L Bottles.stl

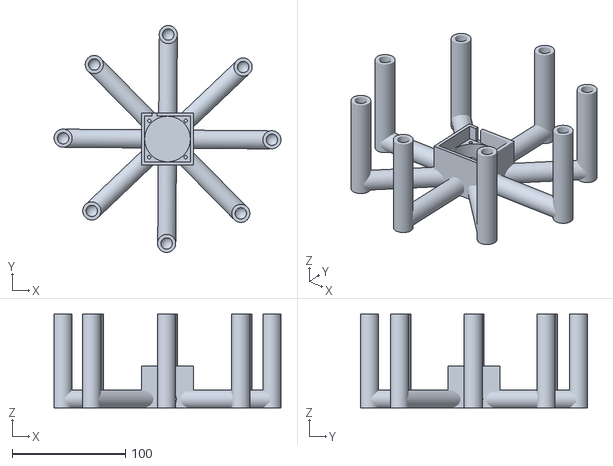
[picture p53: CAD file, 2022-06-20]
Recreator3D Accessories/Community Bottle Dryer/Bottle Dryer for 1L Bottles.stl
200.1 x 200.1 x 82.5
