joshuartaylor/TheRecreator3D/Recreator3D Build Files/Recreator3D - MK3 - Lite and Pro Files/Modifications/MK4Mini - Remixed by JRT3D - Tighter/MK4Mini - Extruder Mount.stl

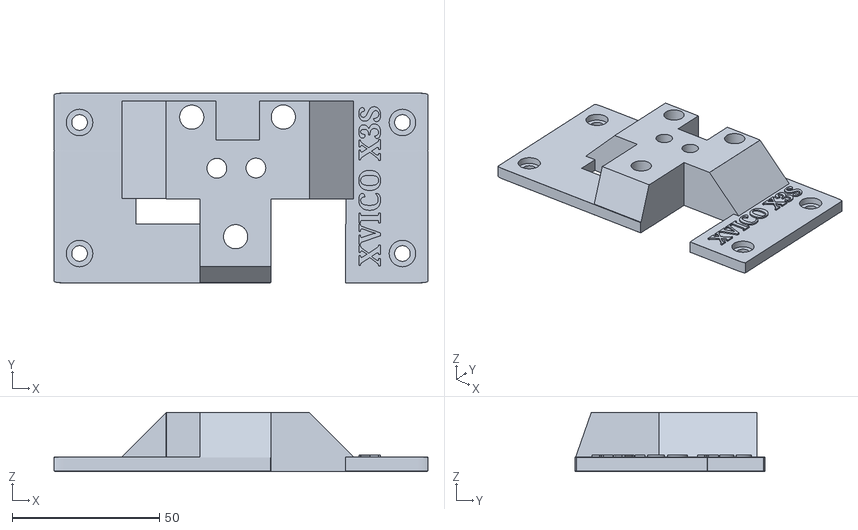
[picture p54: CAD file, 2022-06-20]
Recreator3D Build Files/Recreator3D - MK3 - Lite and Pro Files/Modifications/MK4Mini - Remixed by JRT3D - Tighter/MK4Mini - Extruder Mount.stl
127.0 x 64.5 x 20.1
