joshuartaylor/TheRecreator3D/Recreator3D Build Files/Recreator3D - MK3 - Lite and Pro Files/Modifications/MK5DoubleGearedSingle/DoubleGear.stl.stl

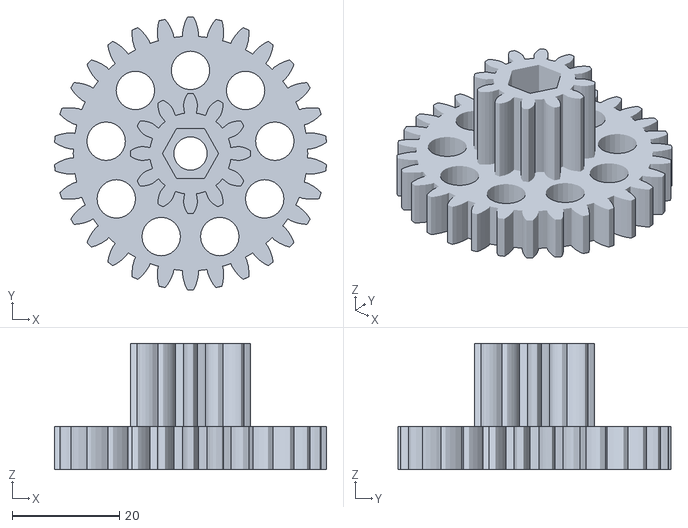
[picture p55: CAD file, 2022-06-20]
Recreator3D Build Files/Recreator3D - MK3 - Lite and Pro Files/Modifications/MK5DoubleGearedSingle/DoubleGear.stl.stl
50.7 x 50.9 x 23.5
