joshuartaylor/TheRecreator3D/Recreator3D Build Files/Recreator3D - MK5 KIT- Ender 3 Files/01 - Top Parts/RECREATOR3D - Part 9B - Front Sinage.stl

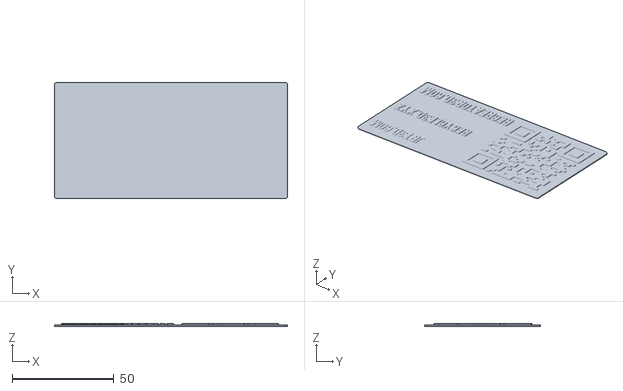
[picture p56: CAD file, 2022-06-20]
Recreator3D Build Files/Recreator3D - MK5 KIT- Ender 3 Files/01 - Top Parts/RECREATOR3D - Part 9B - Front Sinage.stl
114.3 x 57.1 x 1.60
