joshuartaylor/TheRecreator3D/Recreator3D Build Files/Recreator3D - MK5 KIT- Ender 3 Files/02 - Bottom Parts/MK5Kit-Ender3-FacePlate.stl

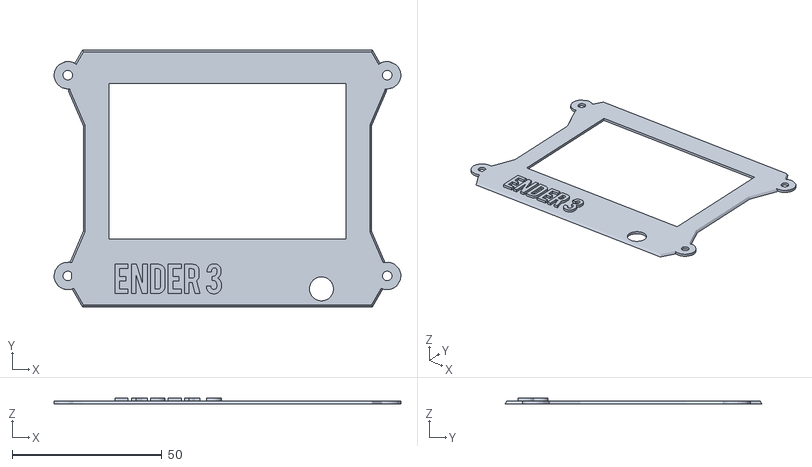
[picture p57: CAD file, 2022-06-20]
Recreator3D Build Files/Recreator3D - MK5 KIT- Ender 3 Files/02 - Bottom Parts/MK5Kit-Ender3-FacePlate.stl
115.8 x 85.7 x 2.00
