joshuartaylor/TheRecreator3D/Recreator3D Build Files/Recreator3D - MK5 KIT- Ender 3 Files/02 - Bottom Parts/Power Supply/MK5Kit-SmallPowerSupply-2X.stl

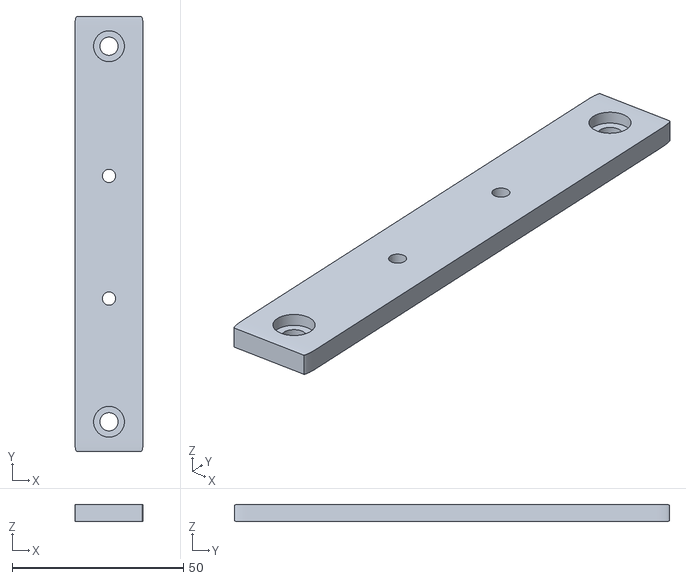
[picture p58: CAD file, 2022-06-20]
Recreator3D Build Files/Recreator3D - MK5 KIT- Ender 3 Files/02 - Bottom Parts/Power Supply/MK5Kit-SmallPowerSupply-2X.stl
20.0 x 127.0 x 5.00
