joshuartaylor/TheRecreator3D/Recreator3D Build Files/Recreator3D - MK5 KIT- Ender 3 Files/03 - Modifications/Community Bottle Cutter/STL Files/Original - Thinner/BottleCutter-Bottom.stl

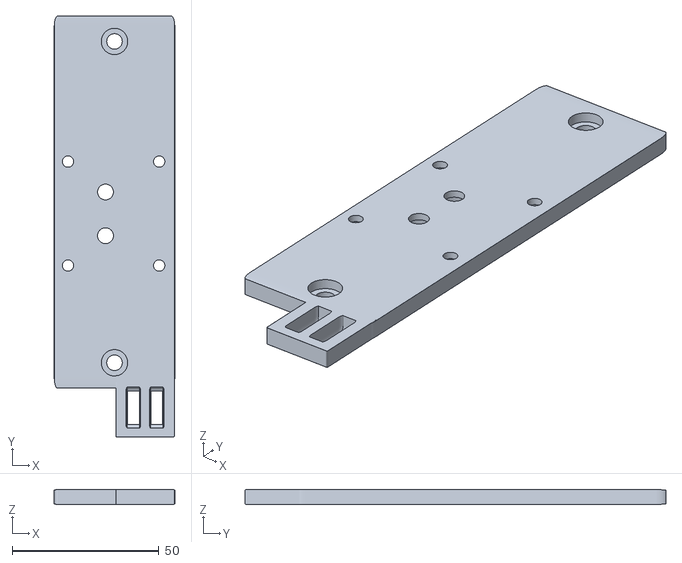
[picture p59: CAD file, 2022-06-20]
Recreator3D Build Files/Recreator3D - MK5 KIT- Ender 3 Files/03 - Modifications/Community Bottle Cutter/STL Files/Original - Thinner/BottleCutter-Bottom.stl
41.1 x 143.7 x 5.00
