joshuartaylor/TheRecreator3D/Motor Spooler Designs/MK5DoubleGearedSingle/DoubleGear.stl

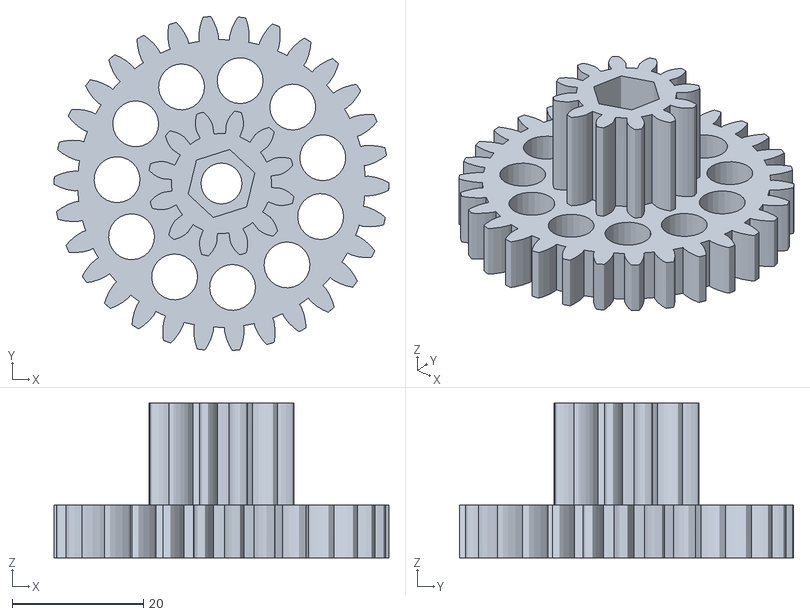
[picture p60: CAD file, 2022-06-20]
Motor Spooler Designs/MK5DoubleGearedSingle/DoubleGear.stl
50.9 x 50.8 x 23.5
