joshuartaylor/TheRecreator3D/Recreator3D Accessories/Community Bottle Cutter/STL Files/BottleWeight-Botton.stl

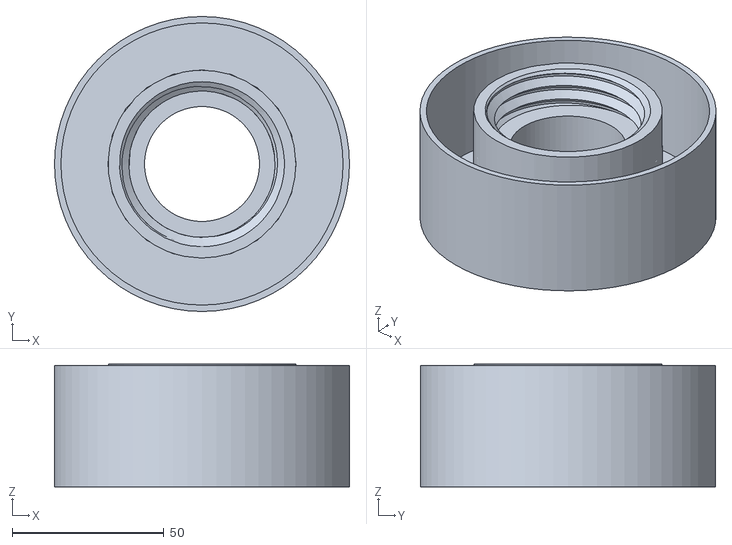
[picture p61: CAD file, 2022-06-20]
Recreator3D Accessories/Community Bottle Cutter/STL Files/BottleWeight-Botton.stl
97.0 x 97.0 x 40.4
