joshuartaylor/TheRecreator3D/Recreator3D Build Files/Recreator3D - MK5 KIT- Ender 3 Files/02 - Bottom Parts/MK5Kit-LCDMount.stl

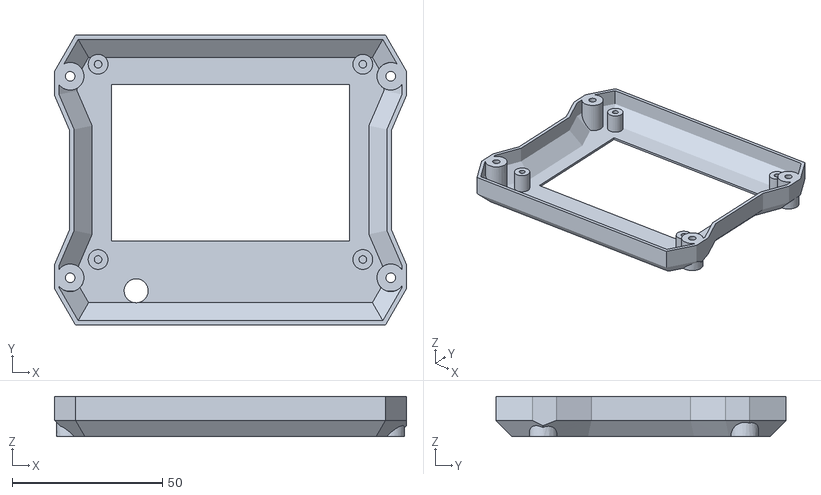
[picture p62: CAD file, 2022-06-20]
Recreator3D Build Files/Recreator3D - MK5 KIT- Ender 3 Files/02 - Bottom Parts/MK5Kit-LCDMount.stl
117.0 x 96.5 x 13.4
