joshuartaylor/TheRecreator3D/Motor Spooler Designs/MK4Mini - Remixed by JRT3D - Tighter/MK4Mini - Motor Gears x2.stl

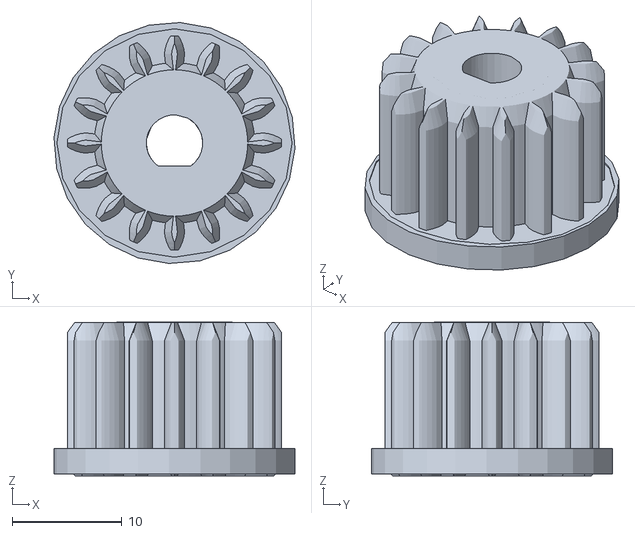
[picture p63: CAD file, 2022-06-20]
Motor Spooler Designs/MK4Mini - Remixed by JRT3D - Tighter/MK4Mini - Motor Gears x2.stl
22.0 x 22.0 x 14.0
