joshuartaylor/TheRecreator3D/Recreator3D Build Files/Recreator3D - MK5 KIT- Ender 3 Files/02 - Bottom Parts/MK5Kit-Ender3BoardMount.stl

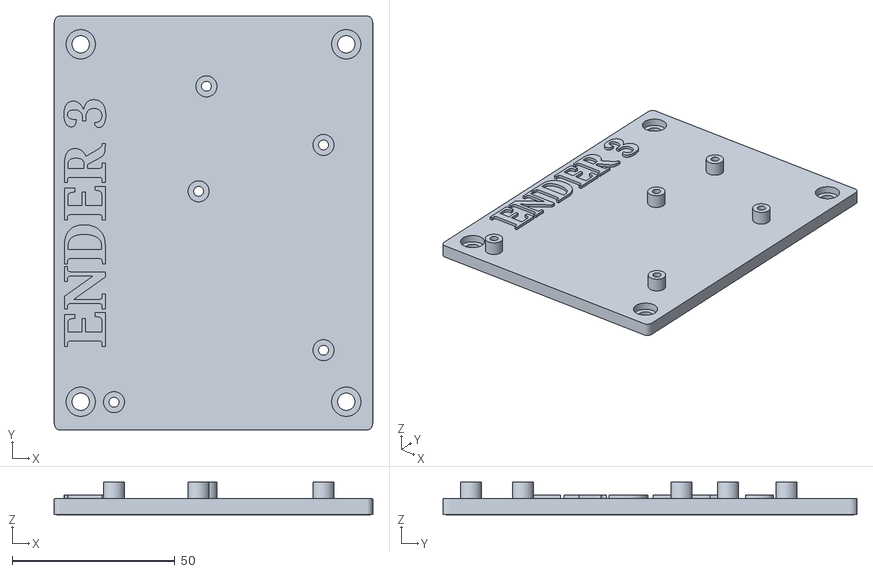
[picture p64: CAD file, 2022-06-20]
Recreator3D Build Files/Recreator3D - MK5 KIT- Ender 3 Files/02 - Bottom Parts/MK5Kit-Ender3BoardMount.stl
97.7 x 127.0 x 10.0
