joshuartaylor/TheRecreator3D/Motor Spooler Designs/MK4Mini - Original by Nick Jones - Looser/Mini Spool Holder v2.1 Non-Motor Side_Part 2of2.stl

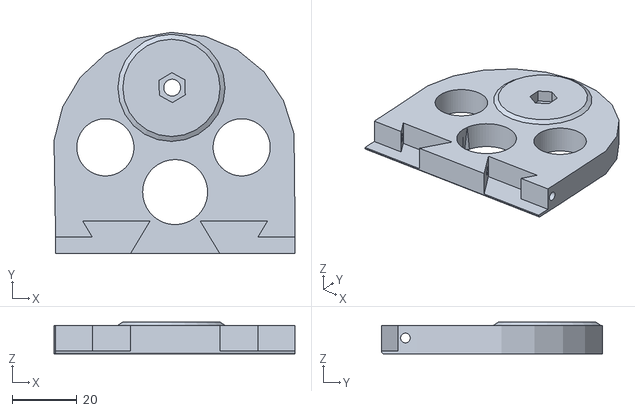
[picture p65: CAD file, 2022-06-20]
Motor Spooler Designs/MK4Mini - Original by Nick Jones - Looser/Mini Spool Holder v2.1 Non-Motor Side_Part 2of2.stl
74.3 x 68.2 x 9.85
