joshuartaylor/TheRecreator3D/Recreator3D Build Files/Recreator3D - MK3 - Lite and Pro Files/Part Files to Print/RECREATOR3D - Part 4C - Guide (NEW).stl

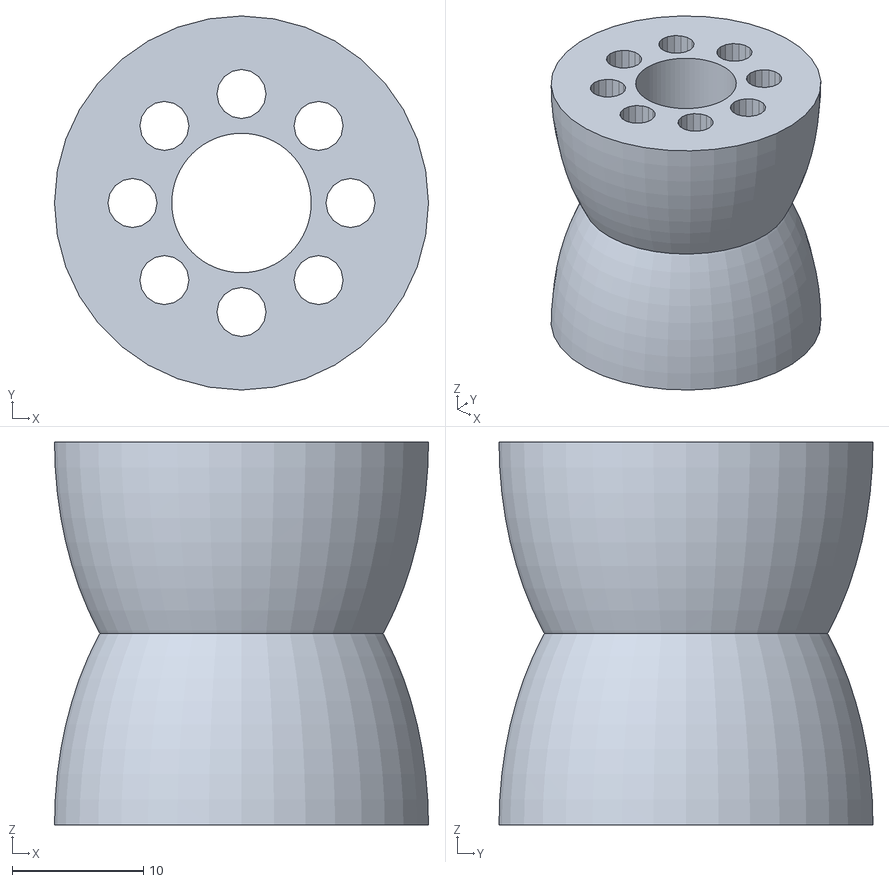
[picture p66: CAD file, 2022-06-20]
Recreator3D Build Files/Recreator3D - MK3 - Lite and Pro Files/Part Files to Print/RECREATOR3D - Part 4C - Guide (NEW).stl
28.5 x 28.5 x 29.1
