joshuartaylor/TheRecreator3D/Recreator3D Build Files/Recreator3D - MK3 - Lite and Pro Files/Part Files to Print/RECREATOR3D - Part 1 - Cutter Guide.stl

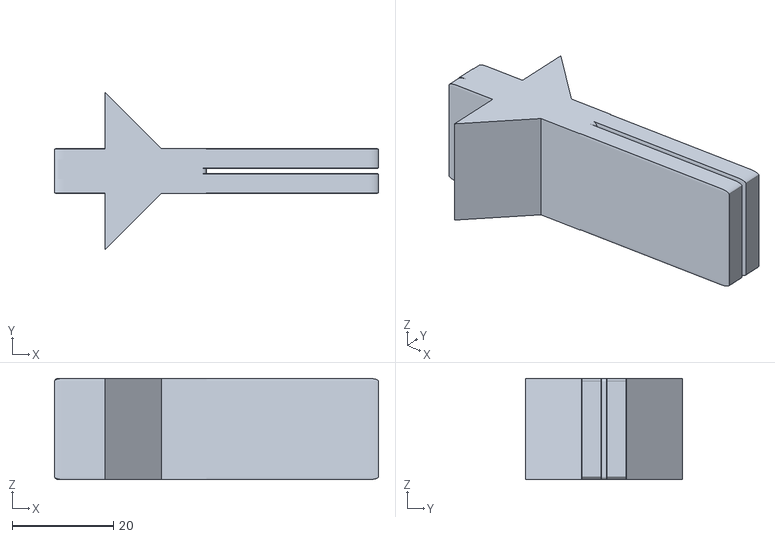
[picture p68: CAD file, 2022-06-20]
Recreator3D Build Files/Recreator3D - MK3 - Lite and Pro Files/Part Files to Print/RECREATOR3D - Part 1 - Cutter Guide.stl
64.0 x 31.1 x 20.0
