joshuartaylor/TheRecreator3D/Recreator3D Build Files/Recreator3D - MK5 KIT- Ender 3 Files/01 - Top Parts/RECREATOR3D - Part 9C - Front Sinage.stl

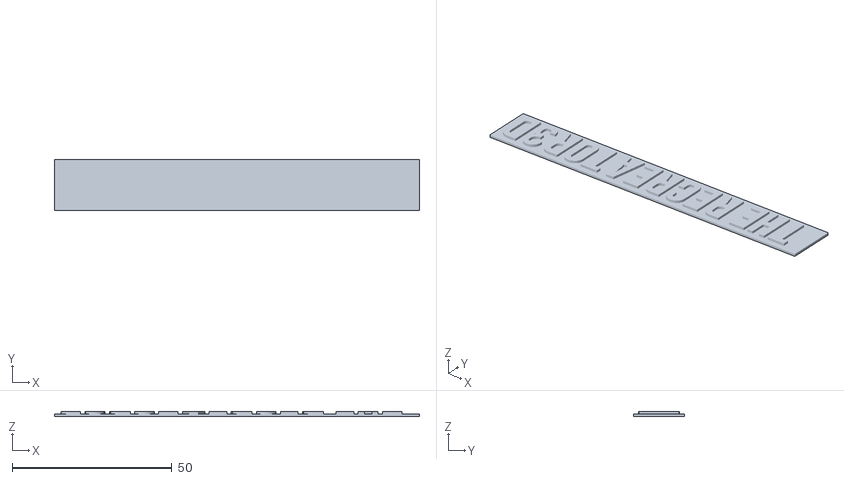
[picture p70: CAD file, 2022-06-20]
Recreator3D Build Files/Recreator3D - MK5 KIT- Ender 3 Files/01 - Top Parts/RECREATOR3D - Part 9C - Front Sinage.stl
114.3 x 16.0 x 1.60
