joshuartaylor/TheRecreator3D/Recreator3D Build Files/Recreator3D - MK5 KIT- Ender 3 Files/01 - Top Parts/RECREATOR3D - Part 9D - Front Sinage.stl

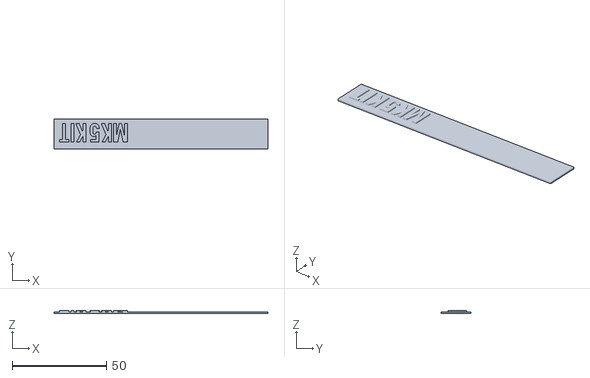
[picture p72: CAD file, 2022-06-20]
Recreator3D Build Files/Recreator3D - MK5 KIT- Ender 3 Files/01 - Top Parts/RECREATOR3D - Part 9D - Front Sinage.stl
113.7 x 16.0 x 1.60
