joshuartaylor/TheRecreator3D/Recreator3D Build Files/Recreator3D - MK3 - Lite and Pro Files/Part Files to Print/RECREATOR3D - Part 6B - Spool Core.stl

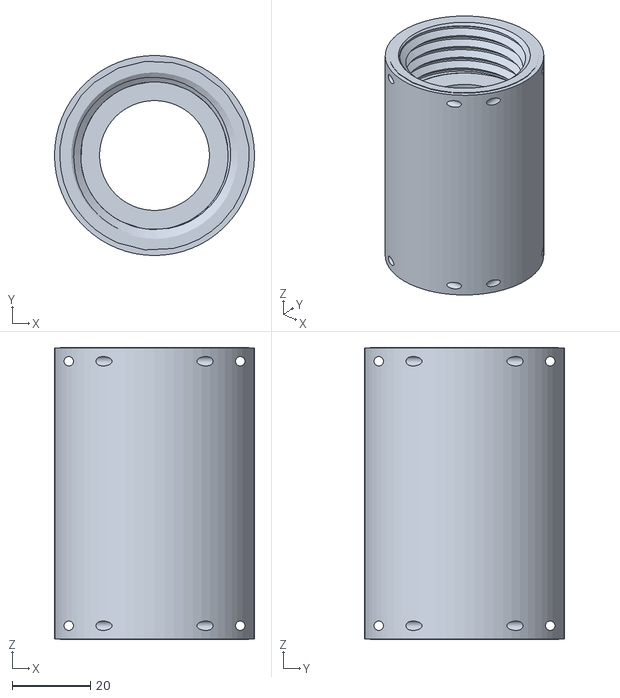
[picture p73: CAD file, 2022-06-20]
Recreator3D Build Files/Recreator3D - MK3 - Lite and Pro Files/Part Files to Print/RECREATOR3D - Part 6B - Spool Core.stl
51.0 x 51.0 x 74.4
