joshuartaylor/TheRecreator3D/Recreator3D Build Files/Recreator3D - MK3 - Lite and Pro Files/Part Files to Print/RECREATOR3D - Part 11D-PRO- Front Sinage.stl

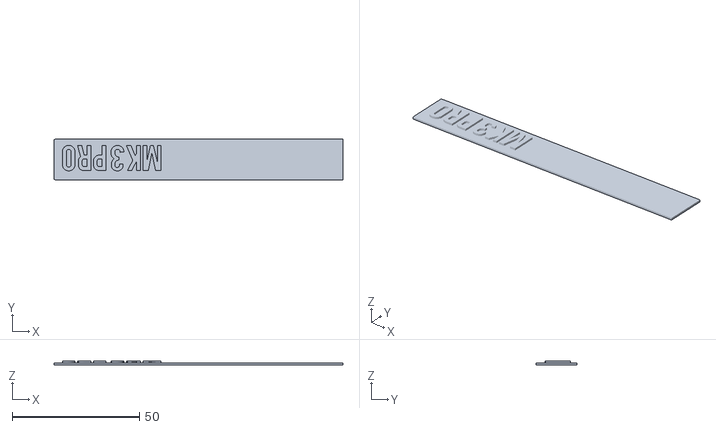
[picture p75: CAD file, 2022-06-20]
Recreator3D Build Files/Recreator3D - MK3 - Lite and Pro Files/Part Files to Print/RECREATOR3D - Part 11D-PRO- Front Sinage.stl
113.7 x 16.0 x 1.60
