joshuartaylor/TheRecreator3D/Recreator3D Build Files/Recreator3D - MK5 KIT- Ender 3 Files/01 - Top Parts/RECREATOR3D - Part 4F - Tensioning Rod (PRINTABLE).stl

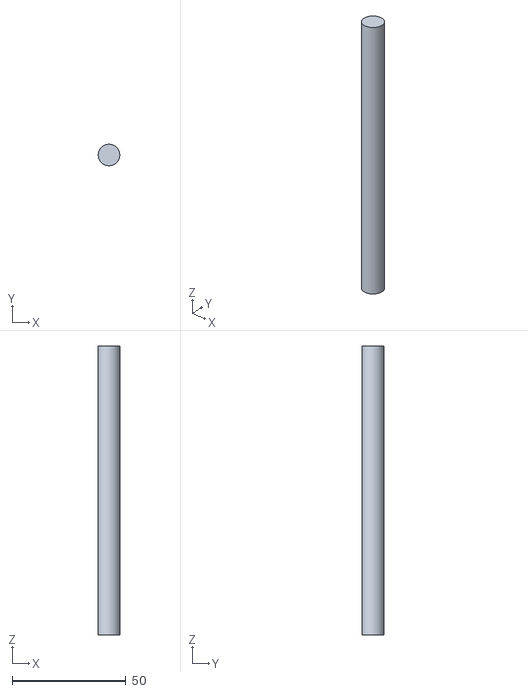
[picture p82: CAD file, 2022-06-20]
Recreator3D Build Files/Recreator3D - MK5 KIT- Ender 3 Files/01 - Top Parts/RECREATOR3D - Part 4F - Tensioning Rod (PRINTABLE).stl
9.52 x 9.52 x 127.0
