joshuartaylor/TheRecreator3D/(list of files, cad)

Other CAD files:
Recreator3D Build Files/Recreator3D - MK3 - Lite and Pro Files/Part Files to Print/RECREATOR3D - Part 1 - Cutter Plate (NEW).stl
Recreator3D Build Files/Recreator3D - MK5 KIT- Ender 3 Files/03 - Modifications/Community Bottle Cutter/STL Files/New - Wider/Bottle Cutter - Top - 8mm (NEW) - Pennies.stl
Recreator3D Accessories/Community Bottle Cutter/STL Files/New - Wider/Bottle Cutter - Top - 8mm (NEW) - Pennies.stl
Motor Spooler Designs/MK5DoubleGearedSingle/Back-Motor-Mount.stl
Recreator3D Build Files/Recreator3D - MK3 - Lite and Pro Files/Modifications/Community Bottle Cutter/STL Files/New - Wider/Bottle Cutter - Top - 8mm (NEW) - Pennies.stl
Recreator3D Build Files/Recreator3D - MK3 - Lite and Pro Files/Modifications/MK4Mini - Original by Nick Jones - Looser/Mini Spool Holder v2 Non-Motor Side_Part 1of2.stl
Motor Spooler Designs/MK4Mini - Original by Nick Jones - Looser/Mini Spool Holder v2 Non-Motor Side_Part 1of2.stl
Recreator3D Build Files/Recreator3D - MK5 KIT- Ender 3 Files/01 - Top Parts/RECREATOR3D - Part 5B - Back-Motor-Mount.stl
Recreator3D Build Files/Recreator3D - MK5 KIT- Ender 3 Files/02 - Bottom Parts/MK5Kit-RightLeg.stl
Recreator3D Build Files/Recreator3D - MK5 KIT- Ender 3 Files/02 - Bottom Parts/MK5Kit-MK5 Kit Signage.stl
Recreator3D Build Files/Recreator3D - MK5 KIT- Ender 3 Files/01 - Top Parts/RECREATOR3D - Part 8A - Bottle Weight Bottom.stl
Recreator3D Build Files/Recreator3D - MK5 KIT- Ender 3 Files/01 - Top Parts/RECREATOR3D - Part 8B - Bottle Weight Top.stl
Recreator3D Build Files/Recreator3D - MK3 - Lite and Pro Files/Part Files to Print/RECREATOR3D - Part 11E-LITE- Front Sinage.stl
Recreator3D Build Files/Recreator3D - MK5 KIT- Ender 3 Files/01 - Top Parts/RECREATOR3D - Part 4A - Tensioning Rod.stl
Recreator3D Build Files/Recreator3D - MK3 - Lite and Pro Files/Part Files to Print/RECREATOR3D - Part 10A - Bottle Weight Bottom.stl
Recreator3D Build Files/Recreator3D - MK3 - Lite and Pro Files/Part Files to Print/RECREATOR3D - Part 10B - Bottle Weight Top.stl
Recreator3D Build Files/Recreator3D - MK3 - Lite and Pro Files/Part Files to Print/RECREATOR3D - Part 4A - Tensioning Rod.stl
Recreator3D Accessories/Community Bottle Cutter/STL Files/Original - Thinner/BottleCutter-Top-2xDimes-Washer - 8mm.stl
Recreator3D Accessories/Community Bottle Cutter/STL Files/Recreator3D - Lead Screw Holder - Left.stl
Recreator3D Accessories/Community Bottle Cutter/STL Files/Recreator3D - Lead Screw Holder - Right.stl
Recreator3D Build Files/Recreator3D - MK3 - Lite and Pro Files/Modifications/Community Bottle Cutter/STL Files/Original - Thinner/BottleCutter-Top-2xDimes-Washer - 8mm.stl
Recreator3D Build Files/Recreator3D - MK3 - Lite and Pro Files/Modifications/Community Bottle Cutter/STL Files/Recreator3D - Lead Screw Holder - Left.stl
Recreator3D Build Files/Recreator3D - MK3 - Lite and Pro Files/Modifications/Community Bottle Cutter/STL Files/Recreator3D - Lead Screw Holder - Right.stl
Recreator3D Build Files/Recreator3D - MK3 - Lite and Pro Files/Part Files to Print/RECREATOR3D - Part 09B - Bottle Support Holder.stl
Recreator3D Build Files/Recreator3D - MK3 - Lite and Pro Files/Part Files to Print/RECREATOR3D - Part 1 - Cutter Plate (OLD).stl
Recreator3D Build Files/Recreator3D - MK3 - Lite and Pro Files/Part Files to Print/RECREATOR3D - Part 2 - Heater Block Plate - XVICO X3S.stl
Recreator3D Build Files/Recreator3D - MK3 - Lite and Pro Files/Part Files to Print/RECREATOR3D - Part 3 - Cooling Fan Plate (OLD).stl
Recreator3D Build Files/Recreator3D - MK3 - Lite and Pro Files/Part Files to Print/RECREATOR3D - Part 4C - Guide (OLD).stl
Recreator3D Build Files/Recreator3D - MK3 - Lite and Pro Files/Part Files to Print/RECREATOR3D - Part 4D - Tensioning Rod Spacer (OLD).stl
Recreator3D Build Files/Recreator3D - MK3 - Lite and Pro Files/Part Files to Print/RECREATOR3D - Part 4E - Tensioning Rod Spacer (OLD).stl
Recreator3D Build Files/Recreator3D - MK3 - Lite and Pro Files/Part Files to Print/RECREATOR3D - Part 5B - Spool Holder - LITE - Single (OLD) Needs Motor Mount.stl
Recreator3D Build Files/Recreator3D - MK3 - Lite and Pro Files/Part Files to Print/RECREATOR3D - Part 7B - Spool Rod Nut.stl
Recreator3D Build Files/Recreator3D - MK3 - Lite and Pro Files/Part Files to Print/RECREATOR3D - Part 7C - Spool Rod Nut.stl
Recreator3D Build Files/Recreator3D - MK3 - Lite and Pro Files/Part Files to Print/RECREATOR3D - Part 8 - Small Gear (OLD).stl
Recreator3D Build Files/Recreator3D - MK5 KIT- Ender 3 Files/01 - Top Parts/RECREATOR3D - Part 1 - Cutter Plate for PBACC Tool.stl
Recreator3D Build Files/Recreator3D - MK5 KIT- Ender 3 Files/01 - Top Parts/RECREATOR3D - Part 4D - Tensioning Rod Spacer (OLD).stl
Recreator3D Build Files/Recreator3D - MK5 KIT- Ender 3 Files/01 - Top Parts/RECREATOR3D - Part 4E - Tensioning Rod Spacer (OLD).stl
Recreator3D Build Files/Recreator3D - MK5 KIT- Ender 3 Files/01 - Top Parts/RECREATOR3D - Part 7B - Spool Rod Nut.stl
Recreator3D Build Files/Recreator3D - MK5 KIT- Ender 3 Files/01 - Top Parts/RECREATOR3D - Part 7C - Spool Rod Nut.stl
Recreator3D Build Files/Recreator3D - MK5 KIT- Ender 3 Files/03 - Modifications/Community Bottle Cutter/STL Files/Original - Thinner/BottleCutter-Top-2xDimes-Washer - 8mm.stl
Recreator3D Build Files/Recreator3D - MK5 KIT- Ender 3 Files/03 - Modifications/Community Bottle Cutter/STL Files/Recreator3D - Lead Screw Holder - Left.stl
Recreator3D Build Files/Recreator3D - MK5 KIT- Ender 3 Files/03 - Modifications/Community Bottle Cutter/STL Files/Recreator3D - Lead Screw Holder - Right.stl
