joshuartaylor/TheRecreator3D/Operation Manual, Guides, and Info/02 - The Recreator 3D - Quick Start Reassembly from Out of Box.pdf

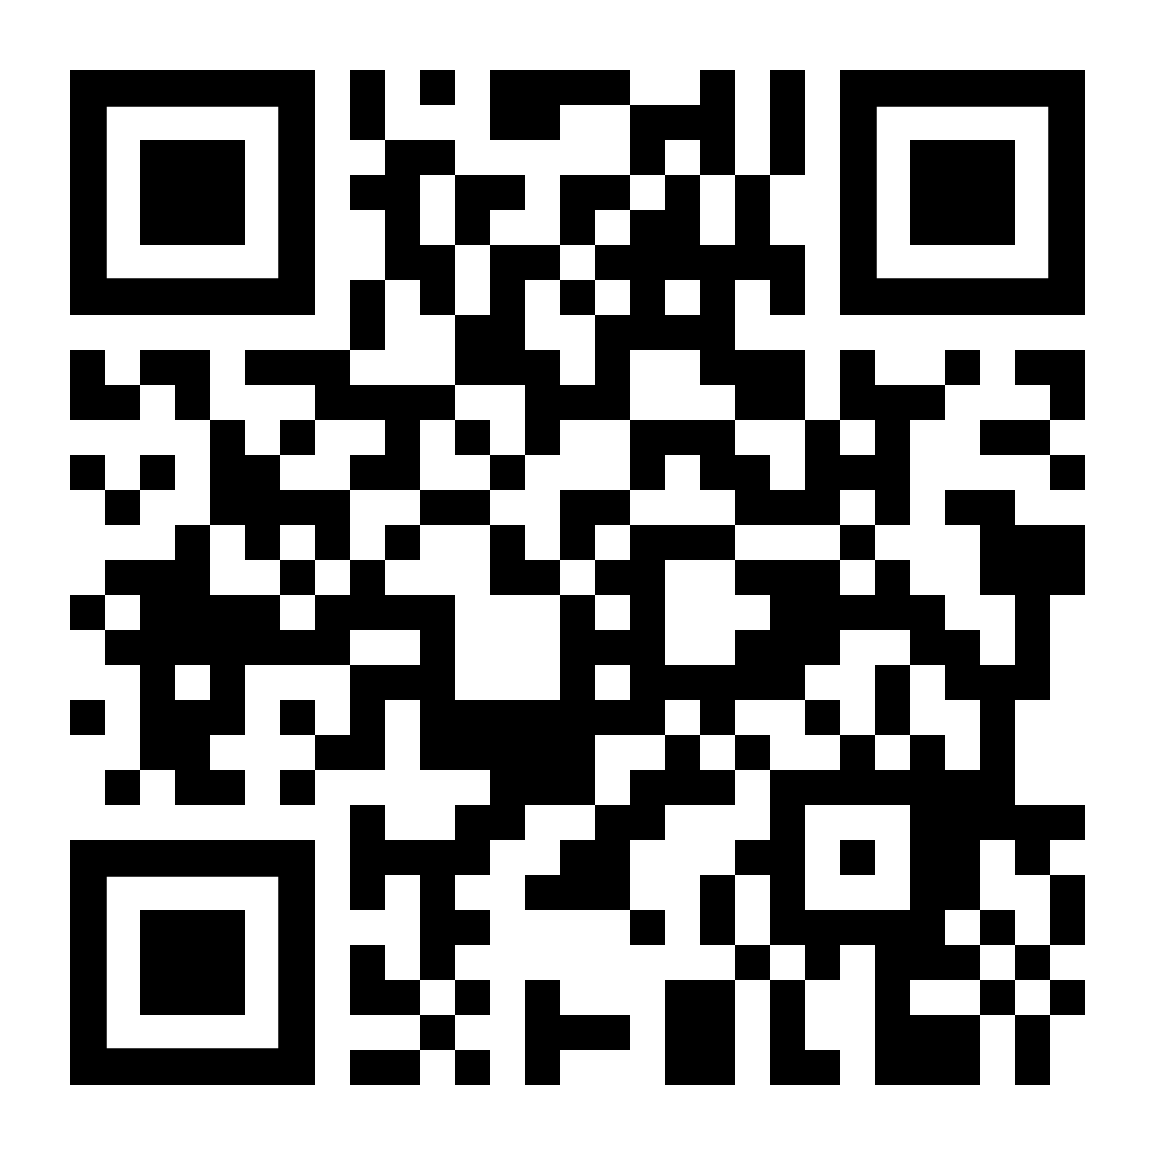
[picture p94: figure]

The Recreator 3D - Quick Start Reassembly from Out of Box

Please See the Build Video at the following Steps to Rebuild your Recreator 3D from Shipping.

The Recreator 3D - How To - Build Notes - RECYCLE - PET#1 -Plastic Bottle Pultrusion Unit

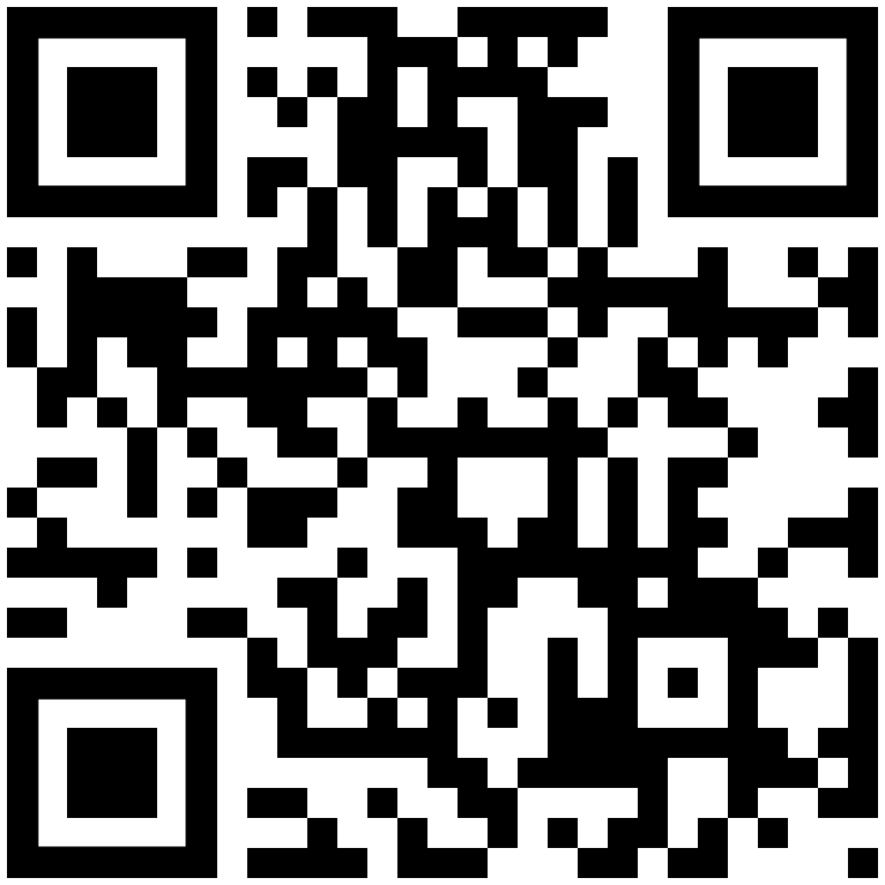
[picture p95: figure]
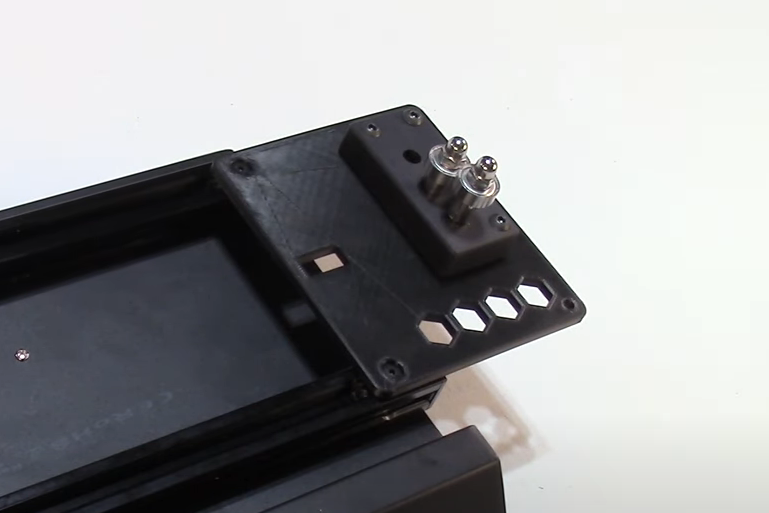
[picture p96: figure]

Reattach the Cutter Plate on the right side: https://youtu.be/nMYunEgUQ8s?t=688

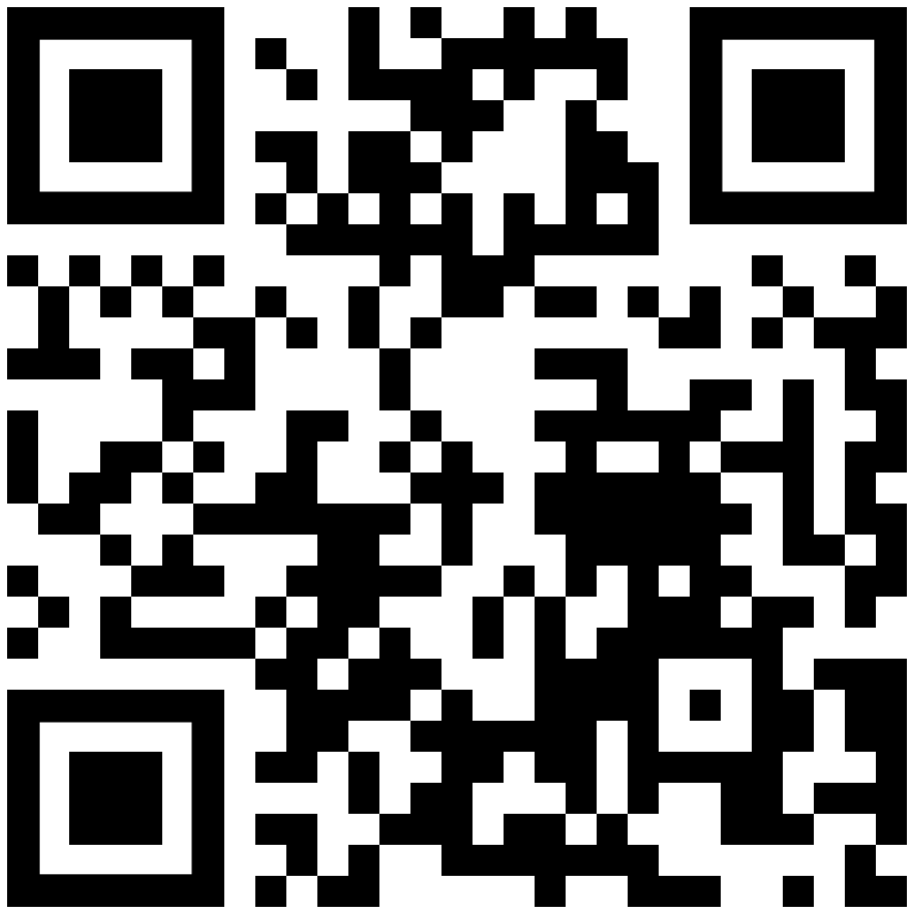
[picture p97: figure]
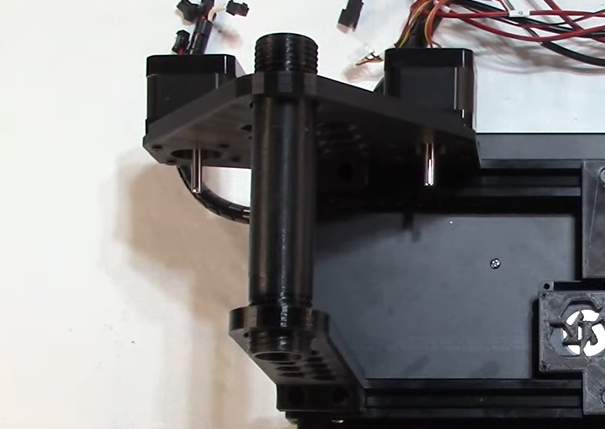
[picture p98: figure]

Reattach the Dual Motor MK3Pro Spooler to the left side, don’t over tighten the spool rod nuts as it can cause binding:
https://youtu.be/nMYunEgUQ8s?t=813

See the Quick Start Guide to easily get started. See the Operations Manual for Further Details. All files and notes needed supplied on the SD Card.
