joshuartaylor/TheRecreator3D/Operation Manual, Guides, and Info/INFO - Thermal Decomposition of Plastics.pdf

1–110

Introduction

Solid polymeric materials undergo both physical and chemical changes when heat is applied; this will usually result in undesirable changes to the properties of the material. A clear distinction needs to be made between thermal decomposition and thermal degradation. The American Society for Testing and Materials’ (ASTM) definitions should provide helpful guidelines. Thermal decomposition is “a process of extensive chemical species change caused by heat.”¹ Thermal degradation is “a process whereby the action of heat or elevated temperature on a material, product, or assembly causes a loss of physical, mechanical, or electrical properties.”¹ In terms of fire, the important change is thermal decomposition, whereby the chemical decomposition of a solid material generates gaseous fuel vapors, which can burn above the solid material. In order for the process to be self-sustaining, it is necessary for the burning gases to feed back sufficient heat to the material to continue the production of gaseous fuel vapors or volatiles. As such, the process can be a continuous feedback loop if the material continues burning. In that case, heat transferred to the polymer causes the generation of flammable volatiles; these volatiles react with the oxygen in the air above the polymer to generate heat, and a part of this heat is transferred back to the polymer to continue the process. (See Figure 1-7.1.) This chapter is concerned with chemical and physical aspects of thermal decomposition of polymers. The chemical processes are responsible for the generation of flammable volatiles while physical changes, such as melting and charring, can markedly alter the decomposition and burning characteristics of a material.
The gasification of polymers is generally much more complicated than that of flammable liquids. For most flammable liquids, the gasification process is simply evaporation. The liquid evaporates at a rate required to maintain the equilibrium vapor pressure above the liquid. In the case of polymeric materials, the original material itself is essentially involatile, and the quite large molecules must be broken down into smaller molecules that can vaporize. In most cases, a solid polymer breaks down into a variety of smaller molecular fragments made up of a number of different chemical species. Hence, each of the fragments has a different equilibrium vapor pressure. The lighter of the molecular fragments will vaporize immediately upon their creation while other heavier molecules will remain in the condensed phase (solid or liquid) for some time. While remaining in the condensed phase, these heavier molecules may undergo further decomposition to lighter fragments which are more easily vaporized. Some polymers break down completely so that virtually no solid residue remains. More often, however, not all the original fuel becomes fuel vapors since solid residues are left behind. These residues can be carbonaceous (char), inorganic (originating from heteroatoms contained in the original polymer, either within the structure or as a result of additive incorporations), or a combination of both. Charring materials, such as wood, leave large fractions of the original carbon content as carbonaceous residue, often as a porous char. When thermal decomposition of deeper layers of such a material continues, the volatiles produced must pass through the char above them to reach the surface. During this travel, the hot char may cause secondary reactions to occur in the volatiles. Carbonaceous chars can be intumescent layers, when appropriately formed, which slow down further thermal decomposition considerably. Inorganic residues, on the other hand, can form glassy lay-

Dr. Craig L. Beyler is the technical director of Hughes Associates, Fire Science and Engineering. He was the founding editor of the Journal of Fire Protection Engineering and serves on a wide range of committees in the fire research community.
Dr. Marcelo M. Hirschler is an independent consultant on fire safety with GBH International. He has over two decades of experience researching fire and polymers and has managed a plastics industry fire testing and research laboratory for seven years. He now serves on a variety of committees addressing the development of fire standards and codes, has published extensively, and is an associate editor of the journal Fire and Materials.

## SECTION ONE

# CHAPTER 7

# Thermal Decomposition of Polymers

## Craig L. Beyler and Marcelo M. Hirschler

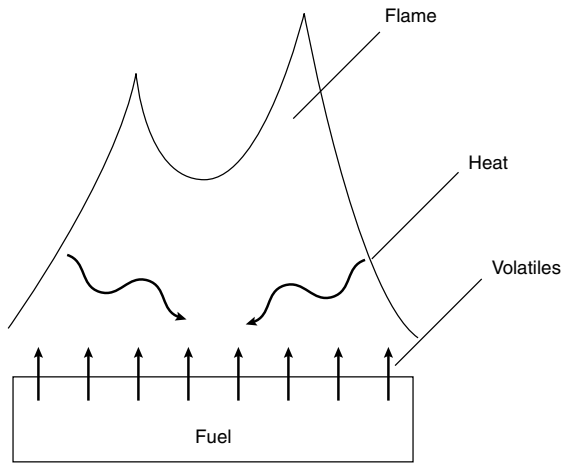
[picture p123: figure]
Fuel; Flame; Heat; Volatiles

ers that may then become impenetrable to volatiles and protect the underlying layers from any further thermal breakdown. Unless such inorganic barriers form, purely carbonaceous chars can always be burned by surface oxidation at higher temperatures.
As this brief description of the thermal decomposition process indicates, the chemical processes are varied and complex. The rate, mechanism, and product composition of these thermal decomposition processes depend both on the physical properties of the original material and on its chemical composition.

Polymeric Materials

Polymeric materials can be classified in a variety of ways.² First, polymers are often classified, based on their origin, into natural and synthetic (and sometimes including a third category of seminatural or synthetic modifications of natural polymers). However, more useful is a classification based on physical properties, in particular the elastic modulus and the degree of elongation. Following this criterion, polymers can be classified into elastomers, plastics, and fibers. Elastomers (or rubbers) are characterized by a long-range extensibility that is almost completely reversible at room temperature. Plastics have only partially reversible deformability, while fibers have very high tensile strength but low extensibility. Plastics can be further subdivided into thermoplastics (whose deformation at elevated temperatures is reversible) and thermosets (which undergo irreversible changes when heated). Elastomers have elastic moduli between 10⁵ and 10⁶ N/m², while plastics have moduli between 10⁷ and 10⁸ N/m², and fibers have moduli between 10⁹ and 10¹⁰ N/m². In terms of the elongation, elastomers can be stretched roughly up to 500 to 1000 percent, plastics between 100 to 200 percent, and fibers only 10 to 30 percent before fracture of the material is complete.

Polymers can also be classified in terms of their chemical composition; this gives a very important indication as to their reactivity, including their mechanism of thermal decomposition and their fire performance.
The main carbonaceous polymers with no heteroatoms are polyolefins, polydienes, and aromatic hydrocarbon polymers (typically styrenics). The main polyolefins are thermoplastics: polyethylene [repeating unit: >(CH2>CH2)>] and polypropylene {repeating unit: >[CH(CH3)>CH2]>}, which are two of the three most widely used synthetic polymers. Polydienes are generally elastomeric and contain one double bond per repeating unit. Other than polyisoprene (which can be synthetic or natural, e.g., natural rubber) and polybutadiene (used mostly as substitutes for rubber), most other polydienes are used as copolymers or blends with other materials [e.g., in ABS (acrylonitrile butadiene styrene terpolymers), SBR (styrene butadiene rubbers), MBS (methyl methacrylate butadiene styrene terpolymers), and EPDM (ethylene propylene diene rubbers)]. They are primarily used for their high abrasion resistance and high impact strength. The most important aromatic hydrocarbon polymers are based on polystyrene {repeating unit: >[CH(phenyl)> CH2]>}. It is extensively used as a foam and as a plastic for injection-molded articles. A number of styrenic copolymers also have tremendous usage, e.g., principally, ABS, styrene acrylonitrile polymers (SAN), and MBS.
The most important oxygen-containing polymers are cellulosics, polyacrylics, and polyesters. Polyacrylics are the only major oxygen-containing polymers with carbon– carbon chains. The most important oxygen-containing natural materials are cellulosics, mostly wood and paper products. Different grades of wood contain 20 to 50 percent cellulose. The most widely used polyacrylic is poly(methyl methacrylate) (PMMA) {repeating unit: >[CH2>C(CH3)>CO–OCH3]>}. PMMA is valued for its high light transmittance, dyeability, and transparency. The most important polyesters are manufactured from glycols, for example, polyethylene terephthalate (PET) or polybutylene terephthalate (PBT), or from biphenol A (polycarbonate). They are used as engineering thermoplastics, as fibers, for injection-molded articles, and unbreakable replacements for glass. Other oxygenated polymers include phenolic resins (produced by the condensation of phenols and aldehydes, which are often used as polymeric additives), polyethers [such as polyphenylene oxide (PPO), a very thermally stable engineering polymer], and polyacetals (such as polyformaldehyde, used for its intense hardness and resistance to solvents). Nitrogen-containing materials include nylons, polyurethanes, polyamides, and polyacrylonitrile. Nylons, having repeating units containing the characteristic group >CO>NH>, are made into fibers and also into a number of injection-molded articles. Nylons are synthetic aliphatic polyamides. There are also natural polyamides (e.g., wool, silk, and leather) and synthetic aromatic polyamides (of exceptionally high thermal stability and used for protective clothing). Polyurethanes (PU), with repeating units containing the characteristic group >NH>COO>, are normally manufactured from the condensation of polyisocyanates and polyols. Their principal area of application is as foams (flexible and rigid), or as thermal insulation.
Thermal Decomposition of Polymers | 1–111

Figure 1-7.1. Energy feedback loop required for sustained burning.

Other polyurethanes are made into thermoplastic elastomers, which are chemically very inert. Both these types of polymers have carbon–nitrogen chains, but nitrogen can also be contained in materials with carbon–carbon chains, the main example being polyacrylonitrile [repeating unit: >(CH2>CH>CN>)]. It is used mostly to make into fibers and as a constituent of engineering copolymers (e.g., SAN, ABS).
Chlorine-containing polymers are exemplified by poly(vinyl chloride) [PVC, repeating unit: >(CH2>CHCl)>]. It is the most widely used synthetic polymer, together with polyethylene and polypropylene. It is unique in that it is used both as a rigid material (unplasticized) and as a flexible material (plasticized). Flexibility is achieved by adding plasticizers or flexibilizers. Through the additional chlorination of PVC, another member of the family of vinyl materials is made: chlorinated poly(vinyl chloride) (CPVC) with very different physical and fire properties from PVC. Two other chlorinated materials are of commercial interest:
(1) polychloroprene (a polydiene, used for oil-resistant wire and cable materials and resilient foams) and
(2) poly(vinylidene chloride) [PVDC, with a repeating unit: >(CH2>CCl2)> used for making films and fibers]. All these polymers have carbon–carbon chains. Fluorine-containing polymers are characterized by high thermal and chemical inertness and low coefficient of friction. The most important material in the family is polytetrafluoroethylene (PTFE); others are poly(vinylidene fluoride) (PVDF), poly(vinyl fluoride) (PVF), and fluorinated ethylene polymers (FEP).

Physical Processes

The various physical processes that occur during thermal decomposition can depend on the nature of the material. For example, as thermosetting polymeric materials are infusible and insoluble once they have been formed, simple phase changes upon heating are not possible. Thermoplastics, on the other hand, can be softened by heating without irreversible changes to the material, provided heating does not exceed the minimum thermal decomposition temperature. This provides a major advantage for thermoplastic materials in the ease of molding or thermo forming of products.
The physical behavior of thermoplastics in heating is dependent on the degree of order in molecular packing, i.e., the degree of crystallinity. For crystalline materials, there exists a well-defined melting temperature. Materials that do not possess this ordered internal packing are amorphous. An example of an amorphous material is window glass. While it appears to be a solid, it is in fact a fluid that over long periods of time (centuries) will flow noticeably. Despite this, at low temperatures amorphous materials do have structural properties of normal solids. At a temperature known as the glass transition temperature in polymers, the material starts a transition toward a soft and rubbery state. For example, when using a rubber band, one would hope to use the material above its glass transition temperature. However, for materials requiring rigidity and compressive strength, the glass transition temperature is an upper limit for practical use. In theoretical terms, this “deformability” of a polymer can be expressed as the ratio of the deformation (strain) resulting from a constant stress applied. Figure 1-7.2 shows an idealized view of the effect on the deformability of thermoplastics of increasing the temperature: a two-step increase. In practice, it can be stated that the glass transition temperature is the upper limit for use of a plastic material (as defined above, based on its elastic modulus and elongation) and the lower limit for use of an elastomeric material. Furthermore, many materials may not achieve a viscous state since they begin undergoing thermal decomposition before the polymer melts. Some typical glass transition temperatures are given in Table 1-7.1. As this type of physical transformation is less well defined than a phase transformation, it is known as a second order transition. Typically, materials are only partially crystalline, and, hence, the melting temperature is less well defined, usually extending over a range of 10°C or more.
Neither thermosetting nor cellulosic materials have a fluid state. Due to their structure, it is not possible for the original material to change state at temperatures below that at which thermal decomposition occurs. Hence, there are no notable physical transformations in the material before decomposition. In cellulosic materials, there is an important semi-physical change that always occurs on heating: desorption of the adsorbed water. As the water is both physically and chemically adsorbed, the temperature and rate of desorption will vary with the material. The activation energy for physical desorption of water is 30 to 40 kJ/mol, and it starts occurring at temperatures somewhat lower than the boiling point of water (100°C).
Many materials (whether cellulosic, thermosetting, or thermoplastic) produce carbonaceous chars on thermal decomposition. The physical structure of these chars will strongly affect the continued thermal decomposition
1–112 | Fundamentals

Melting
region Viscous
State
Rubbery State

10

10⁻⁵

10⁻¹⁰

Glassy
state

Glass
transition
region

Increasing temperature

Deformability of polymers (m2/N)

Figure 1-7.2. Idealized view of effect on deformability of thermoplastics with increasing temperature.

process. Very often the physical characteristics of the char will dictate the rate of thermal decomposition of the remainder of the polymer. Among the most important characteristics of char are density, continuity, coherence, adherence, oxidation-resistance, thermal insulation properties, and permeability.³ Low-density–high-porosity chars tend to be good thermal insulators; they can significantly inhibit the flow of heat from the gaseous combustion zone back to the condensed phase behind it, and thus slow down the thermal decomposition process. This is one of the better means of decreasing the flammability of a polymer (through additive or reactive flame retardants).¹,3,4 As the char layer thickens, the heat flux to the virgin material decreases, and the decomposition rate is reduced. The char itself can undergo glowing combustion when it is exposed to air. However, it is unlikely that both glowing combustion of the char and significant gas-phase combustion can occur simultaneously in the same zone above the surface, since the flow of volatiles through the char will tend to exclude air from direct contact with the char. Therefore, in general, solid-phase char combustion tends to occur after volatilization has largely ended.

Chemical Processes

The thermal decomposition of polymers may proceed by oxidative processes or simply by the action of heat. In many polymers, the thermal decomposition processes are accelerated by oxidants (such as air or oxygen). In that case, the minimum decomposition temperatures are lower in the presence of an oxidant. This significantly complicates the problem of predicting thermal decomposition rates, as the prediction of the concentration of oxygen at the polymer surface during thermal decomposition or combustion is quite difficult. Despite its importance to fire, there have been many fewer studies of thermal decomposition processes in oxygen or air than in inert atmospheres.

Thermal Decomposition of Polymers | 1–113

Polymer

Acetal
Acrylonitrile-butadiene-styrene Cellulose
Ethylene-vinyl acetate
Fluorinated ethylene propylene High-density polyethylene
Low-density polyethylene
Natural rubber
Nylon 11
Nylon 6
Nylon 6-10
Nylon 6-6
Polyacrylonitrile
Poly(butene 1)
Polybutylene
Poly(butylene terephthalate) Polycarbonate
Polychlorotrifluoroethylene Poly(ether ether ketone)
Poly(ether imide)
Poly(ethylene terephthalate) Poly(hexene 1)
Poly(methylbutene 1)
Polymethylene
Poly(methyl methacrylate)
Polyoxymethylene
Poly(pentene 1)
Poly(3-phenylbutene 1)
Poly(phenylene oxide)/polystyrene Poly(phenylene sulphide)
Polypropylene
Polystyrene
Polysulphone
Polytetrafluoroethylene
Poly(vinyl chloride)
Poly(vinylidene chloride)
Poly(vinylidene fluoride)
Poly(p-xylene)
Styrene-acrylonitrile

% Crystalline

high
low
high
high
high
95
60
low
high

low

high
low
high
high

high

100
low
75–80

low
high
65
low
low
100
5–15
high
high

low

Glass Transition
Temperature (°C)

91–110

–125
–25

75
50
57
140
124–142
126
40
145–150
45
143
217
70

50
–85

100–135
88–93
–20
>80
190
125
80–85
–18
–30– –20

100–120

Crystalline Melting
Temperature (°C)

175–181
110–125
decomposes
65–110
275
130–135
109–125
30
185–195
215–220
215
250–260
317
124–142
126
232–267
215–230
220
334

265
55
300
136
90–105
175–180
130
360
110–135
277–282
170
230
190
327
75–105 (212)
210
160–170
>400
120

Table 1-7.1 Glass Transition and Crystalline Melting Temperatures

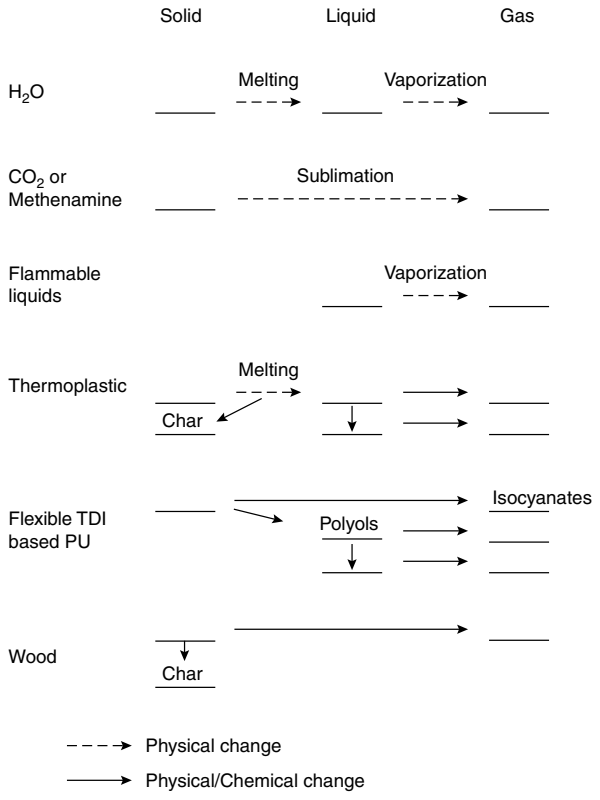
[picture p124: figure]
Melting; Vaporization; Flammable liquids; Physical change; Physical/Chemical change; CO2 or Methenamine; Sublimation; Thermoplastic; Char; Flexible TDI based PU; Polyols; Isocyanates; Wood; Solid; Liquid; Gas

It is worthwhile highlighting, however, that some very detailed measurements of oxygen concentrations and of the effects of oxidants have been made by Stuetz et al. in the 1970s⁵ and more recently by Kashiwagi et al.,

6–10 Brau-
man,¹¹ and Gijsman et al.¹² Stuetz found that oxygen can penetrate down to at least 10 mm below the surface of polypropylene. Moreover, for both polyethylene and polypropylene, this access to oxygen is very important in determining thermal decomposition rates and mechanisms. Another study of oxygen concentration inside polymers during thermal decomposition, by Brauman,¹¹ suggests that the thermal decomposition of polypropylene is affected by the presence of oxygen (a fact confirmed more recently by Gijsman et al.¹²) while poly(methyl methacrylate) thermal decomposition is not. Kashiwagi found that a number of properties affect the thermal and oxidative decomposition of thermoplastics, particularly molecular weight, prior thermal damage, weak linkages, and primary radicals. Of particular interest is the fact that the effect of oxygen (or air) on thermal decomposition depends on the mechanism of polymerization: free-radical polymerization leads to a neutralization of the effect of oxygen. A study on poly(vinylidene fluoride) indicated that the effect of oxygen can lead to changes in both reaction rate and kinetic order of reaction.¹³
Kashiwagi’s work in particular has resulted in the development of models for the kinetics of general random-chain scission thermal decomposition,¹⁴ as well as for the thermal decomposition of cellulosics¹⁵ and thermoplastics.¹⁶
There are a number of general classes of chemical mechanisms important in the thermal decomposition of polymers: (1) random-chain scission, in which chain scissions occur at apparently random locations in the polymer chain; (2) end-chain scission, in which individual monomer units are successively removed at the chain end; (3) chain-stripping, in which atoms or groups not part of the polymer chain (or backbone) are cleaved; and
(4) cross-linking, in which bonds are created between polymer chains. These are discussed in some detail under General Chemical Mechanisms, later in this chapter. It is sufficient here to note that thermal decomposition of a polymer generally involves more than one of these classes of reactions. Nonetheless, these general classes provide a conceptual framework useful for understanding and classifying polymer decomposition behavior.

Interaction of Chemical
and Physical Processes

The nature of the volatile products of thermal decomposition is dictated by the chemical and physical properties of both the polymer and the products of decomposition. The size of the molecular fragments must be small enough to be volatile at the decomposition temperature. This effectively sets an upper limit on the molecular weight of the volatiles. If larger chain fragments are created, they will remain in the condensed phase and will be further decomposed to smaller fragments, which can vaporize.
Figure 1-7.3 shows examples of the range of chemical or physical changes that can occur when a solid polymer is volatilized. The changes range from simple phase transformations (solid going to liquid and then to gas, at the top of the figure), to complex combinations of chemical and physical changes (in the lower part of the figure). Water and many other liquids forming crystalline solids on freezing (e.g., most flammable liquids) undergo straightforward physical phase changes. Sublimation, i.e., the direct phase change from a solid to a gas, without going through the liquid phase, will happen with materials such as carbon dioxide (e.g., CO2, dry gas) or methenamine at normal temperatures and pressures. Methenamine is of interest in fires because methenamine pills are the ignition source in a standard test for carpets, ASTM D2859,¹⁷ used in mandatory national regulations.¹⁸,19 Thermoplastics can melt without chemical reaction to form a viscous state (polymer melt), but they often decompose thermally before melting. This polymer melt can then decompose into smaller liquid or gaseous fragments. The liquid fragments will then decompose further until they, too, are sufficiently volatile to vaporize. Some polymers, especially thermosets or cellulosics, have even more complex decomposition mechanisms. Polyurethanes (particularly flexible foams) can decompose by three different mechanisms. One of them involves the formation of gaseous isocyanates, which can then repolymerize in the gas phase and condense as a “yellow smoke.” These iso-
1–114 | Fundamentals

Figure 1-7.3. Physical and chemical changes during thermal decomposition.

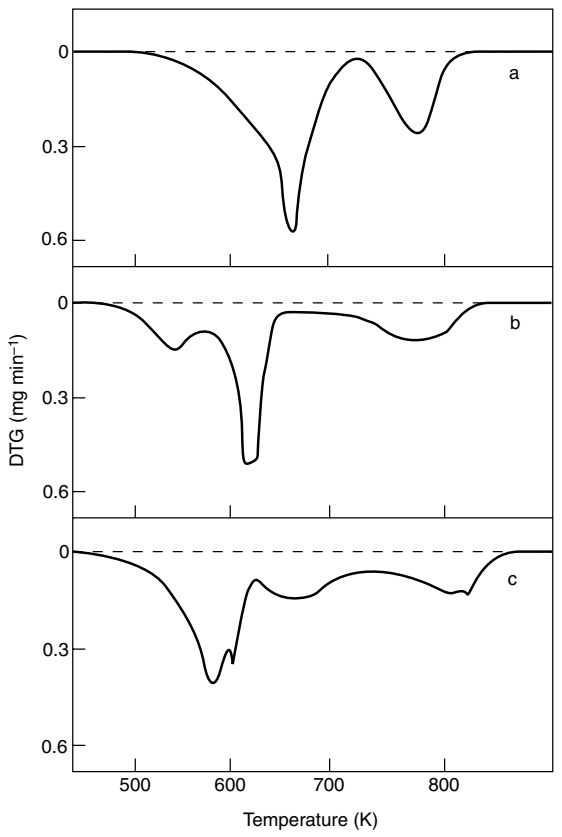
[picture p125: figure]
Temperature (K); DTG (mg min–1)

cyanates are usually accompanied by liquid polyols, which can then continue to decompose. Cellulosics, such as wood, decompose into three types of products:
(1) laevoglucosan, which quickly breaks down to yield small volatile compounds; (2) a new solid, char; and (3) a series of high molecular weight semi-liquid materials generally known as tars. Figure 1-7.3 illustrates the complex and varied physicochemical decomposition pathways available, depending on the properties of the material in question. These varied thermal degradation/ decomposition mechanisms have clear effects on fire behavior.

Experimental Methods

By far, the most commonly used thermal decomposition test is thermogravimetric analysis (TGA). In TGA experiments, the sample (mg size) is brought quickly up to the desired temperature (isothermal procedure) and the weight of the sample is monitored during the course of thermal decomposition. Because it is impossible in practice to bring the sample up to the desired temperature before significant thermal decomposition occurs, it is common to subject the sample to a linearly increasing temperature at a predetermined rate of temperature rise. One might hope to obtain the same results from one nonisothermal test that were possible only in a series of isothermal tests. In practice, this is not possible since the thermogram (plot of weight vs. temperature) obtained in a nonisothermal test is dependent on the heating rate chosen. Traditional equipment rarely exceed heating rates of 0.5 K/s, but modifications can be made to obtain rates of up to 10 K/s.²⁰,21 This dependence of thermal decomposition on heating rate is due to the fact that the rate of thermal decomposition is not only a function of the temperature, but also of the amount and nature of the decomposition process that has preceded it.
There are several reasons why the relevance of thermogravimetric studies to fire performance can be questioned: heating rate, amount of material, and lack of heat feedback are the major ones. For example, it is well known that heating rates of 10 to 100 K/s are common under fire conditions but are rare in thermal analysis. However, low heating rates can occur in real fires. More seriously, thermogravimetric studies are incapable of simulating the thermal effects due to large amounts of material burning and resupplying energy to the decomposing materials at different rates. However, analytical thermogravimetric studies do give important information about the decomposition process even though extreme caution must be exercised in their direct application to fire behavior. Differential thermogravimetry (DTG) is exactly the same as TGA, except the mass loss versus time output is differentiated automatically to give the mass loss rate versus time. Often, both the mass loss and the mass loss rate versus time are produced automatically. This is, of course, quite convenient as the rate of thermal decomposition is proportional to the volatilization or mass loss rate. One of the main roles where DTG is useful is in mechanistic studies. For example, it is the best indicator of the temperatures at which the various stages of thermal decomposition take place and the order in which they occur as illustrated in Figure 1-7.4. Part (a) of this figure shows the DTG of a thermoplastic polymer, acrylonitrile-butadiene-styrene (ABS), and part (b) shows the same polymer containing 40 percent alumina trihydrate.²² The polymer decomposes in two main stages. The addition of alumina trihydrate has a dual effect: (1) it makes the material less thermally stable, and (2) it introduces a third thermal decomposition stage. Moreover, the first stage is now the elimination of alumina trihydrate. A more complex example is shown in Figure 1-7.5, where the effects of a variety of additives are shown;²³ some of these additives are effective flame retardants and others are not: the amount of overlap between the thermal decomposition stages of polymer and additives is an indication of the effectiveness of the additive. Another method for determining the rate of mass loss is thermal volatilization analysis (TVA).²⁴ In this method, a sample is heated in a vacuum system (0.001 Pa) equipped with a liquid nitrogen trap (77 K) between the sample and the vacuum pump. Any volatiles produced will increase the pressure in the system until they reach the liquid nitrogen and condense out. The pressure is proportional to the mass volatilization rate, and a pressure transducer, rather
Thermal Decomposition of Polymers | 1–115

Figure 1-7.4. Effect of hydrated alumina and of antimony oxide-decabromobiphenyl (DBB) on DTG of ABS copolymer: (a) ABS; (b) ABS (60%) AÚ2O3, 3 H2O (40%);
(c) ABS (70%) + DBB (22.5%) + Sb2O3 (7.5%).

than a sample microbalance, is used to measure the decomposition rate.
In addition to the rate of decomposition, it is also of interest to determine the heat of reaction of the decomposition process. In almost all cases, heat must be supplied to the sample to get it to a temperature where significant thermal decomposition will occur. However, once at such a temperature, the thermal decomposition process may either generate or utilize additional heat. The magnitude of this energy generation (exothermicity) or energy requirement (endothermicity) can be determined in the following ways.
In differential thermal analysis (DTA), a sample and a reference inert material with approximately the same heat capacity are both subjected to the same linear temperature program. The sample and reference material temperatures are measured and compared. If the thermal decomposition of the sample is endothermic, the temperature of the sample will lag behind the reference material; if the decomposition is exothermic, the temperature of the sample will exceed the reference material temperature. Very often, the sample is held in a crucible, and an empty crucible is used as a reference. Such a test can be quite difficult to calibrate to get quantitative heats of reaction.
In view of the considerable importance of the exact process of thermal decomposition, it is advantageous to carry out simultaneously the measurements of TGA, DTG, and DTA. This can be achieved by using a simultaneous thermal analyzer (STA), which uses a dual sample/reference material system. In the majority of cases, polymeric materials are best represented by a reference material which is simply air, i.e., an empty crucible. STA instru-
1–116 | Fundamentals
400 | 500 | 600 | 700 | 800 | 400 | 500 | 600 | 700 | 800
| | | | | t/K
a | g
b | h
c | i
d | j
e | k
f | l

Figure 1-7.5. Thermal analyses of systems containing ABS, decabromobiphenyl (DBB), and one metal oxide, where DTG curves are indicated by a continuous line and TGA curfves by a dashed line: (a) ABS; (b) ABS + DBB; (c) ABS + DBB + Sb2O3; (d) ABS + DBB + SnO; (e) ABS + DBB + Sno2 . H2O; (f) ABS + DBB + ZnO; (g) ABS + DBB + Fe2O3; (h) ABS + DBB + AÚOOH; (i) ABS + DBB + AÚ2O3; (j) ABS + DBB + AÚ2O3 . 3H2O; (k) ABS + DBB + ammonium molybdate; (l) ABS + DBB + talc. DTG (—-);TGA (----).

ments can then determine, at the same time, the amounts of polymer decomposed, the rates at which these stages/processes occur, and the amount of heat evolved or absorbed in each stage. Examples of the application of this technique are contained in References 20 and 21. Recently, STA equipment is often being connected to Fourier transform infrared spectrometers (FTIR) for a complete chemical identification and analysis of the gases evolved at each stage, making the technique even more powerful. Another method, which yields quantitative results more easily than DTA, is differential scanning calorimetry (DSC). In this test procedure, both the sample and a reference material are kept at the same temperature during the linear temperature program, and the heat of reaction is measured as the difference in heat input required by the sample and the reference material. The system is calibrated using standard materials, such as melting salts, with well-defined melting temperatures and heats of fusion. In view of the fact that DSC experiments are normally carried out by placing the sample inside sealed sample holders, this technique is seldom suitable for thermal decomposition processes. Thus, it is ideally suited for physical changes, but not for chemical processes. Interestingly, some of the commercial STA apparatuses are, in fact, based on DSC rather than DTA techniques for obtaining the heat input. So far the experimental methods discussed have been concerned with the kinetics and thermodynamics of the thermal decomposition process. There is also concern with the nature of the decomposition process from the viewpoints of combustibility and toxicity. Chemical analysis of the volatiles exiting from any of the above instruments is possible. However, it is often convenient to design a special decomposition apparatus to attach directly to an existing analytical instrument. This is particularly important when the heating rate to be studied is much higher than that which traditional instruments can achieve. Thermal breakdown of cellulosic materials, for example, has been investigated at heating rates as high as 10 K/s²⁵,26 or even up to over 1000 K/s²⁷⁻²⁹ in specialized equipment. The major reason this was done was in order to simulate the processes involved in “smoking,” but the results are readily applicable to fire safety.
Given the vast numbers of different products that can result from the decomposition in a single experiment, separation of the products is often required. Hence, the pyrolysis is often carried out in the injector of a gas chromatograph (PGC). In its simplest but rarely used form, a gas chromatograph consists of a long tube with a wellcontrolled flow of a carrier gas through it. The tube or column is packed with a solid/liquid that will absorb and desorb constituents in the sample. A small sample of the decomposition products is injected into the carrier gas flow. If a particular decomposition product spends a lot of time adsorbed on the column packing, it will take a long time for it to reach the end of the column. Products with different adsorption properties relative to the column packing will reach the end of the column at different times. A detector placed at the exit of the gas chromatograph will respond to the flow rate of gases other than the carrier gas, and if separation is successful, the detector output will be a series of peaks. For a single peak, the time from injection is characteristic of the chemical species, and the area under the peak is proportional to the amount of the chemical species. Column packing, column temperature programming, carrier gas flow rate, sample size, and detector type must all be chosen and adjusted to achieve optimal discrimination of the decomposition products.
Once the gases have been separated, any number of analytical techniques can be used for identification. Perhaps the most powerful has been mass spectrometry (MS). Again speaking in very simple terms, in MS the chemical species is ionized, and the atomic mass of the ion can be determined by the deflection of the ion in a magnetic field. Generally, the ionization process will also result in the fragmentation of the molecule, so the “fingerprint” of the range of fragments and their masses must be interpreted to determine the identity of the original molecule. Gas chromatography and mass spectrometry are the subject of a vast literature, and many textbooks and specialized journals exist.
Useful physical data can be obtained by thermomechanical analysis (TMA). This is really a general name for the determination of a physical/mechanical property of a material subjected to high temperatures. Compressive and tensile strength, softening, shrinking, thermal expansion, glass transition, and melting can be studied by using TMA.
As displayed in Table 1-7.2, many of these tests can be performed in vacuo, in inert atmospheres, and in oxidizing atmospheres. Each has its place in the determination of the decomposition mechanism. Experiments performed in vacuo are of little practical value, but under vacuum the products of decomposition are efficiently carried away from the sample and its hot environment. Thus, secondary reactions are minimized so that the original decomposition product may reach a trap or analytical instrument intact. The practical significance of studies of thermal decomposition carried out in inert atmospheres may be
Thermal Decomposition of Polymers | 1–117
Method | Isothermal | Nonisothermal | In Vacuo | Inert | Air
Thermogravimetric analysis (TGA) | X | X | X | X | X
Differential thermogravimetry (DTG) | X | X | X | X | X
Thermal volatilization analysis (TVA) | X | X | X
Differential thermal analysis (DTA) | | X | | X | X
Differential scanning calorimetry (DSC) | | X | | X | X
Pyrolysis gas chromatography (PGC) | X | | | X
Thermomechanical aAnalysis (TMA) | X | X | | X | X

Table 1-7.2 Analytical Methods argued. However, when a material burns, the flow of combustible volatiles from the surface and the flame above the surface effectively exclude oxygen at the material’s surface. Under these conditions, oxidative processes may be unimportant. In other situations, such as ignition where no flame yet exists, oxidative processes may be critical. Whether or not oxygen plays a role in decomposition can be determined by the effect of using air rather than nitrogen in thermal decomposition experiments.
The decomposition reactions in the tests of Table 1-7.2 are generally monitored by the mass loss of the sample. With the exception of charring materials (e.g., wood or thermosets), analysis of the partially decomposed solid sample is rarely carried out. When it is done, it usually involves the search for heteroatom components due to additives. Analysis of the composition of the volatiles can be carried out by a wide range of analytical procedures. Perhaps the simplest characterization of the products is the determination of the fraction of the volatiles that will condense at various trap temperatures. Typically, convenient temperatures are room temperature (298 K), dry-ice temperature (193 K), and liquid nitrogen temperature (77 K). The products are classified as to the fraction of the sample remaining as residue; the fraction volatile at the pyrolysis temperature, but not at room temperature, Vpyr; the fraction volatile at room temperature, but not at dry-ice temperature, V298; the fraction volatile at dry-ice temperature, but not at liquid nitrogen temperature, V–193; and the fraction volatile at liquid nitrogen temperature, V–77. This characterization gives a general picture of the range of molecular weights of the decomposition products. The contents of each trap can also be analyzed further, perhaps by mass spectroscopy.
The residual polymer can be analyzed to determine the distribution of molecular weights of the remaining polymer chains. This information can be of great value in determining the mechanism of decomposition. The presence of free radicals in the residual polymer can be determined by electron spin resonance spectroscopy (ESR, EPR), which simplistically can be considered the determination of the concentration of unpaired electrons in the sample. Other techniques, like infrared spectroscopy (IR), can be usefully employed to detect the formation of bonds not present in the original polymer. Such changes in bonding may be due to double-bond formation due to chain-stripping or the incorporation of oxygen into the polymer, for example.

General Chemical Mechanisms

Four general mechanisms common in polymer decomposition are illustrated in Figure 1-7.6. These reactions can be divided into those involving atoms in the main polymer chain and those involving principally side chains or groups. While the decomposition of some polymers can be explained by one of these general mechanisms, others involve combinations of these four general mechanisms. Nonetheless, these categorizations are useful in the identification and understanding of particular decomposition mechanisms.

Among simple thermoplastics, the most common reaction mechanism involves the breaking of bonds in the main polymer chain. These chain scissions may occur at the chain end or at random locations in the chain. End-chain scissions result in the production of monomer, and the process is often known as unzipping. Random-chain scissions generally result in the generation of both monomers and oligomers (polymer units with 10 or fewer monomer units) as well as a variety of other chemical species. The type and distribution of volatile products depend on the relative volatility of the resulting molecules. Cross-linking is another reaction involving the main chain. It generally occurs after some stripping of substituents and involves the creation of bonds between two adjacent polymer chains. This process is very important in the formation of chars, since it generates a structure with a higher molecular weight that is less easily volatilized. The main reaction types involving side chains or groups are elimination reactions and cyclization reactions. In elimination reactions, the bonds connecting side groups of the polymer chain to the chain itself are broken, with the side groups often reacting with other eliminated side groups. The products of these reactions are generally small enough to be volatile. In cyclization reactions, two adjacent side groups react to form a bond between them, resulting in the production of a cyclic structure. This process is also important in char formation because, as the reaction scheme shows, the residue is much richer in carbon than the original polymer as seen, for example, for poly(vinyl chloride):

>CH2 > CHCl >ü>CHC CH>=HCl

which leads to a hydrogenated char or for poly(vinylidene chloride):

>CH2 > CCl2 >ü>C X C >=2HCl

which yields a purely carbonaceous char with an almost graphitic structure. These chars will tend to continue

1–118 | Fundamentals

Main chain reactions

Chain scission
(MW decrease
volatile formation)

Cross-linking
(main chain unsaturation
volatile formation
cross linking)

Side chain or
substituent reactions

Side chain elimination
(main chain unsaturation
volatile formation
cross linking)

Side chain cyclization

Figure 1-7.6. General decomposition mechanisms.

breaking down by chain scission, but only at very high temperatures.

Chain-Scission Mechanisms

Decomposition by chain scission is a very typical mechanism for polymer decomposition. The process is a multistep radical chain reaction with all the general features of such reaction mechanisms: initiation, propagation, branching, and termination steps.
Initiation reactions are of two basic types: (1) random-chain scission and (2) end-chain scission. Both, of course, result in the production of free radicals. The random scission, as the name suggests, involves the breaking of a main chain bond at a seemingly random location, all such main chain bonds being equal in strength. End-chain initiation involves the breaking off of a small unit or group at the end of the chain. This may be a monomer unit or some smaller substituent. These two types of initiation reactions may be represented by the following generalized reactions:
Pnü Rr = Rn>r | (random-chain scission)
Pnü Rn = RE | (end-chain initiation)

where Pn is a polymer containing n monomer units, and Rr is a radical containing r monomer units. RE refers to an end group radical.
Propagation reactions in polymer decomposition are often called depropagation reactions, no doubt due to the polymer chemist’s normal orientation toward polymer formation (polymerization) rather than decomposition. Regardless, there are several types of reactions in this class [see Figure 1-7.7, parts (a), (b), and (c)]:
Rn ü Rn>m = Pm | (intramolecular H transfer, random-chain scission)
Pm = Rn ü Pm>j = Pn = Rj | (intermolecular H transfer)
Rn ü Rn>1 = P1 | (unzipping, depropa- gation, depolymerization)

The first of these reactions involves the transfer of a hydrogen atom within a single polymer chain, i.e., intramolecular hydrogen atom transfer. The value of m is usually between one and four as polymer molecules are often oriented such that the location of the nearest available H within the chain is one to four monomer units away from the radical site. The value of m need not be a constant for a specific polymer as the closest available hydrogen atom in the chain may vary due to conformational variations. Decomposition mechanisms based on this reaction are sometimes known as random-chain scission mechanisms. The second reaction involves the transfer of a hydrogen atom between polymer chains, i.e., intermolecular hydrogen atom transfer. The original radical, Rn, abstracts a hydrogen atom from the polymer, Pm. As this makes Pm radical with the radical site more often than not within the chain itself (i.e., not a terminal radical site), the newly formed radical breaks up into an unsaturated polymer, Pm–j, and a radical, Rj. In the final reaction, no hydrogen transfer occurs. It is essentially the reverse of the polymerization step and, hence, is called unzipping, depropagation, or depolymerization. Whether the decomposition involves principally hydrogen transfer reactions or unzipping can be determined by examining the structure of the polymer, at least for polymers with only carbon in the main chain. If hydrogen transfer is impeded, then it is likely that the unzipping reaction will occur.
Vinyl polymers, strictly speaking, are those derived from a vinyl repeating unit, namely

—[CH2—CH2]n—

where n is the number of repeating monomers. Here, the hydrogen atoms can be substituted, leading to a repeating unit of the following form:

WY
—[C—C]n—
XZ
Thermal Decomposition of Polymers | 1–119
C | C C • | C | C C | C C
H | H | H H | H | H H
H | H H | H | H H | H H

H

C | C C C | C C | C C | •
H | H H H | H H | H H
H | H H H | H H | H H

(a)

C | C C C | C C | •
H | R H | R H

R

R

H | R H | R H

C C

H R

H R

C | C C C | C C | C C | •
H | R R H | R H | R H
H | R R H | R H | R H
(b) (c)
C | C C C
H | H H H
H | H H H

H

C | C C C | C C
H | H H H | H H
H | H H | H H
C | C C C | •
H | H H H
H | H H H
C | C C C | C C
H | H | H H | H
H | H H | H H

•

Figure 1-7.7. (a) Intramolecular H transfer, (b) intermolecular H transfer, (c) unzipping.

where W, X, Y, and Z are substituent groups, perhaps hydrogen, methyl groups, or larger groups. Consider that the C–C bond connecting monomer units is broken and that a radical site results from the scission shown as

WY | WY
|| | || —[C—C]j—C—C •
XZ | XZ

where the symbol • indicates an unpaired electron and, hence, a radical site. In order for a hydrogen atom to be transferred from the chain to the radical site, it must pass around either Y or Z. If Y and Z are hydrogens, this is not at all difficult due to their small size. However, if the alpha carbon has larger substituents bound to it (i.e., Y and Z are larger groups), the transfer of hydrogen to the radical site is more difficult. This type of interference with hydrogen transfer is known as steric hindrance. Table 1-7.3 shows this effect.² Polymers near the top of Table 1-7.3 have Y and Z substituents that are generally large, with a resulting high monomer yield, characteristic of unzipping reactions. Near the bottom of Table 1-7.3, where Y and Z are small, the polymers form negligible amounts of monomer as other mechanisms dominate.
While chain-branching reactions seem to be of little importance in polymer decomposition, termination reactions are required in all chain mechanisms. Several types of termination reactions are common.
Rm ü Pm | (unimolecular termination)
Rm = Rn ü Pm=n | (recombination)
Rn = Rm ü Pm = Pn | (disproportionation)
1–120 | Fundamentals

Polymer

PMMA
Polymethacrylonitrile
E Poly (a-methylstyrene)
Polyoxymethyleneb
Polytetrafluoroethylene
Poly (methyl atropate)
Poly (p-bromostyrenec
Poly (p-chlorostyrenec
Poly (p-methyoxystyrenec
Poly (p-methylstyrene)
Poly (a-deuterostyrene)
Poly (a,+,+-trifluorostyrene) Polystyrene
Poly (m-methylstyrene
Poly (+-deuerostyrene)
Poly (+-methylstyrene)
Poly (p-methoxystvrened
Polyisobutene
Polychlorotrifluoroethylene Poly (ethylene oxide)b
Poly (propylene oxide)b
Poly (4-methyl pent-1-ene) Polyethylene
Polypropylene
Poly (methyl acrylate)
Polytrifluoroethylene
Polybutadieneb
Polyisopreneb
Poly (vinyl chloride)
Poly (vinylidene fluoride) Poly (vinyl fluoride)
Poly (vinyl alcohol)
Polyacrylonitrile

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
C6H5
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
CO2CH3
CN
C6H5
—
F
CO2CH3
C6H4Br
C6H4Cl
C7H7O
C7H7
C6H5
C6H5
C6H5
C7H8
C6H5
C6H5
C7H7O
CH3
F
—
—
C4H9
H
CH3
CO2CH3
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
Monomer
Yield
(wt. %)

91–98
90
95
100
95
>99
91–93
82–94
84–97
82–94
70
44
42–45
44
42

36–40
18–25
28
4
4
2
0.03
0.17
0.7
—
1
5
0–0.07
—
—
—
5

Decomposition
Mechanisma

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
aR, random-chain scission; E, end-chain scission (unzipping); S, chain-stripping; C, cross-linking. bNot of general form [CWX – CYZ ]n
cCationic polymerization
d Free-radical polymerization

Table 1-7.3 Monomer Yield from Thermal Decomposition of Polymers of the General Form [CWX – CYZ]n²

The first of these reactions is, strictly speaking, not generally possible. Nonetheless, there are instances where the observed termination reaction appears to be first order (at least empirically). It is impossible to remove the radical site from a polymer radical without adding or subtracting at least one hydrogen atom while still satisfying the valence requirements of the atoms. What probably occurs is that the termination reaction is, in fact, second order, but the other species involved is so little depleted by the termination reaction that the termination reaction appears not to be affected by the concentration of that species. This is known as a pseudo first-order reaction. The recombination reaction is a classical termination step that is actually just the reverse of the random-chain scission initiation reaction. Finally, the disproportionation reaction involves the transfer of a hydrogen atom from one radical to the other. The hydrogen donor forms a double bond as a result of the hydrogen loss, and the acceptor is fully saturated. If this sort of reaction occurs immediately after an initiation reaction, no unzipping or other propagation reaction occurs, and the polymer decomposition is fully characterized by a random process of bond scissions. There is a natural tendency to regard all materials with the same generic name, such as poly(methyl methacrylate), as being the same material with the same properties. As these are commercial products, the preparation methods (including the polymerization process) are dictated by the required physical and chemical properties of the material for normal use. Additives, both intentional and inadvertent, may be present, and the method of polymerization and the molecular weight of the polymer chains may vary. This is particularly important in the case of polymeric “compounds” (the actual polymeric material that is used commercially to fabricate a product of any kind) that contain a large fraction of additives. In some polyolefins, the fraction of polymer (known as resin) may be much less than half of the total mass of the compound, because of the presence of large amounts of fillers. In some compounds derived from poly(vinyl chloride), flexibility is introduced by means of plasticizers.
In this regard, it is interesting and important to note that polymers tend to be less stable than their oligomer counterparts. This results from several effects involved in the production and aging of polymers as well as simply the chain length itself. Initiation reactions in a polymer can lead to far more monomer units being involved in decomposition reactions, relative to the polymer’s shortchain oligomeric analog. In the production and aging of polymers, there are opportunities for the production of abnormalities in the polymer chains due to the mode of synthesis and thermal, mechanical, and radiation effects during aging.
In the synthesis of the polymer, abnormalities may result from several sources. Unsaturated bonds result from chain termination by free-radical termination reactions. End-chain unsaturation results from second-order disproportionation reactions, and midchain unsaturation often occurs due to chain-transfer reactions with subsequent intramolecular hydrogen transfer. Chain branching may result from the formation of midchain radicals. During synthesis, chain transfer reactions may cause midchain radicals that then go on to react with monomers or polymers to create a branched polymer structure. Termination of the polymerization reaction may also result in head-to-head linkages; i.e., monomer units are attached such that some of the monomers are oriented opposite to the remainder of the chain. Lastly, foreign atoms or groups may be incorporated into the polymer chain. This may occur due to impurities, polymerization initiators, or catalysts. Oxygen is often a problem in this regard.
The purity and the molecular weight of the polymer can markedly affect not only the decomposition rates, but also the mechanism of decomposition. An example of such a change might involve chain initiations occurring at the location of impurities in the chain of a polymer which, if pure, would principally be subject to end-chain initiation. Both the mechanism and the decomposition rate would be affected. Not all polymer “defects” degrade polymer thermal performance. In a polymer that decomposes by unzipping, a head-to-head linkage can stop the unzipping process. Thus, for an initiation that would have led to the full polymer being decomposed, only the part between the initiation site and the head-to-head link is affected. At least one additional initiation step is required to fully decompose the chain. This has been studied in detail by Kashiwagi et al.⁶⁻¹⁰

Kinetics

Eight generic types of reaction involved in simple decomposition processes have been addressed in the previous sections. Even if only a subset of these reaction types are required and the reaction rates are not a strong function of the size of the polymer chains and radicals, the kinetics describing the process can be quite complex. In engineering applications, such complex reaction mechanisms are not used. Rather, simple overall kinetic expressions are generally utilized if, in fact, decomposition kinetics are considered at all. The most common assumption is that the reactions can be described by an Arrhenius expression of first order in the remaining polymer mass. Often one goes even further and ignores any dependence of the reaction rate on the remaining polymer or the thickness of the decomposition zone and simply expresses the volatilization rate per unit surface area as a zero-order Arrhenius expression. This effectively assumes that the decomposition zone is of constant thickness and fresh polymer replaces the decomposed polymer by surface regression. Such an approach would clearly not be satisfactory for charring materials where decomposition is clearly not a surface phenomenon. As some of the work quoted earlier has indicated (e.g., Reference 13), it is also not suitable for many thermoplastic polymers.
Despite the fact that detailed kinetic models are not used in engineering calculations, it is instructive to consider some very simple cases, by the use of overall kinetic expressions, to indicate what is being lost. The effect of the initiation mechanism on decomposition kinetics can be easily demonstrated by considering either random- or end-chain initiation with propagation by unzipping and no termination reactions other than exhaustion of the
Thermal Decomposition of Polymers | 1–121

polymer chain by unzipping. The rate of weight loss for random-chain initiation can be expressed as

dW
dt C Dp Ý kir Ý W

where Dp, the degree of polymerization, is the number of monomer units per polymer chain; and kir is the rate constant for the random-chain initiation reaction. Notice that the rate constant of the propagation reaction is not included in the expression. A further assumption that the propagation rate is much faster than the initiation rate has also been made. The initiation reaction is said to be the rate-limiting step. The degree of polymerization arises in the equation since, for each initiation, Dp monomer units will be released; and the remaining weight, W, arises because the number of bonds available for scission is proportional to W. Since the polymer unzips completely, the molecular weight of all remaining polymer chains is the same as the initial molecular weight.
Considering end-chain initiation, the rate of mass loss is given by

dW
dt C Dp Ý (2n) Ý kie

where n is the number of polymer chains, and, hence, 2n is the number of chain ends, and kie is the rate constant for end-chain initiation. The number of polymer chains is simply the mass of the sample divided by the molecular weight of each chain, or

n C W Dp Ý MWm

where MWm is the molecular weight of the monomer. Using this expression yields

dW

dt C 2 Ý kie Ý W
| MWm

Comparing this with the random initiation expression, one can see that, for random initiation, the rate is dependent on the original degree of polymerization; whereas for end-chain initiation the rate is independent of the degree of polymerization or, equivalently, the original molecular weight of the polymer. In both cases, however, the rate is first order in the mass of the sample. This derivation has been for a monodisperse polymer; i.e., all chains have been considered to be the same length initially.
Returning to the random-chain initiation expression, it is clear that longer chains are decomposed preferentially. If the initial sample had a range of molecular weights, the longer chains would disappear more quickly than shorter chains, and the molecular weight distribution would change with time, unlike in the monodisperse case. It can be shown that in this case the reaction order is no longer unity, but is between one and two, depending on the breadth of the distribution.³⁰ Thus,

dW
dt T Wn

with

1 A nA 2

for random-chain initiation and complete unzipping of a polydisperse system.
This simple comparison illustrates some of the ways in which the details of the polymerization process, which control variables like the molecular weight distribution, can alter the decomposition process. For a particular polymer sample, no single initiation reaction need be dominant, in general. The activation energies for the different initiation steps may be quite different, leading to large variations in the relative rates with temperature. For instance, in PMMA, the dominant initiation step at low temperatures (around 570 K) is end-chain initiation. At higher temperatures (around 770 K), the random-chain initiation step dominates. In a single nonisothermal TGA experiment, this temperature range can easily be traversed, and overall interpretation of the results in terms of a single mechanism would be unsatisfactory and misleading. Nonetheless, simple overall kinetic expressions are likely to be dominant in engineering for some time. The pitfalls with this approach simply serve to reinforce the need to determine the kinetic parameters in an experiment that is as similar to the end use as is practical. This is one of the major reasons why the use of TGA results has been brought into question. As stated before, the heating rates often are far less than those generally found in fire situations. The low heating rates in TGA experiments tend to emphasize lower-temperature kinetics, which may be much less important at the heating rates characteristic of most fire situations.
One interesting study worth presenting here is a theoretical analysis of thermal decomposition that presents a technique for calculating the temperature at the beginning and end of thermal decomposition, based on structural data from the polymer and on scission at the weakest bond, with considerable degree of success, particularly for successive members of a polymeric family.³¹ A subsequent analysis has also been published that is much simpler, but it has not been validated against experimental data.³²

General Physical Changes
During Decomposition

The physical changes that occur on heating a material are both important in their own right and also impact the course of chemical decomposition significantly. The nature of the physical changes and their impact on decomposition vary widely with material type. This section addresses the general physical changes that occur for thermoplastic (glass transition, melting) and thermosetting (charring, water desorption) materials.

Melting and Glass Transition

On heating a thermoplastic material, the principal physical change is the transformation from a glass or solid to the fluid state. (See Figure 1-7.2.) If this transformation

1–122 | Fundamentals

occurs at temperatures well below the decomposition temperature, it becomes more likely that the material will drip and/or flow. While such behavior is a complication, in terms of fire safety it can either improve or degrade the performance of the material. In some configurations, flowing of the material can remove it from the source of heat and thus avoid ignition or further fire growth. In other situations, the flow of material may be toward the heat source, leading to a worsened fire situation. Many standard fire tests that allow materials to flow away from the heat source have been shown to be unsuitable for assessing the hazards of flowing or dripping materials. Care must be taken in the evaluation of standard test results in this regard. However, many thermoplastics do not show marked tendencies to flow during heating and combustion. Whereas polyethylene melts and flows readily, highquality cast poly(methyl methacrylate) shows only slight tendencies to flow under fire conditions.
When designing a material, there are several techniques that can be utilized to increase the temperature at which physical transformations occur. These strategies are generally aimed at increasing the stiffness of the polymer or increasing the interactions between polymer chains. It is clear that increasing the crystallinity of the polymer increases the interaction between polymer chains. In the highly ordered state associated with crystalline materials, it is less possible for polymer chains to move relative to one another, as additional forces must be overcome in the transformation to the unordered fluid state. Crystallinity is enhanced by symmetric regular polymer structure and highly polar side groups. Regular structure allows adjacent polymer chains to pack in a regular and tight fashion. As such, isotactic polymers are more likely to crystallize than atactic polymers, and random copolymers do not tend to crystallize. Polar side groups enhance the intermolecular forces. Regular polar polymers, such as polyesters and polyamides, crystallize readily. Even atactic polymers with OH and CN side groups will crystallize due to polarity. The melting temperature of a polymer is also increased with increasing molecular weight up to a molecular weight of about 10,000 to 20,000 g/mol.
Melting temperatures can also be increased by increasing the stiffness of the polymer chain. Aromatic polyamides melt at much higher temperatures than their aliphatic analogs due to stiffness effects. Aromatics are particularly useful for chain stiffening, as they provide stiffness without bulk which would hinder crystallinity. At the opposite extreme, the increased flexibility of the oxygen atom links in polyethers is responsible for a lowering of the melting temperature of polyethers relative to polymethylene. Chain stiffening must be accompanied by suitable thermal stability and oxidation resistance in order to achieve increased service temperatures. Many aromatic polymers have melting temperatures in excess of their decomposition temperatures, making these materials thermosetting.
Cross-linking also increases the melting temperature and, like chain stiffening, can render a material infusible. Cross-links created in fabrication or during heating are also important in thermoplastics. The glass transition temperature can be increased in amorphous polymers by the inclusion of cross-links during fabrication. Random-chain scissions can quickly render a material unusable by affecting its physical properties unless cross-linking occurs. Such cross-linking in thermoplastics on heating may be regarded as a form of repolymerization. The temperature above which depolymerization reactions are faster than polymerization reactions is known as ceiling temperature. Clearly, above this temperature catastrophic decomposition will occur.

Charring

While char formation is a chemical process, the significance of char formation is largely due to its physical properties. Clearly, if material is left in the solid phase as char, less flammable gas is given off during decomposition. More importantly, the remaining char can be a low-density material and is a barrier between the source of heat and the virgin polymer material. As such, the flow of heat to the virgin material is reduced as the char layer thickens, and the rate of decomposition is reduced, depending on the properties of the char.³ If the heat source is the combustion energy of the burning volatiles, not only will the fraction of the incident heat flux flowing into the material be reduced, but the incident heat flux as a whole will be reduced as well. Unfortunately, char formation is not always an advantageous process. The solid-phase combustion of char can cause sustained smoldering combustion. Thus, by enhancing the charring tendency of a material, flaming combustion rates may be reduced, but perhaps at the expense of creating a source of smoldering combustion that would not otherwise have existed.
Charring is enhanced by many of the same methods used to increase the melting temperature. Thermosetting materials are typically highly cross-linked and/or chainstiffened. However, charring is not restricted to thermosetting materials. Cross- linking may occur as a part of the decomposition process, as is the case in poly(vinyl chloride) and polyacrylonitrile.

Implications for Fire Performance

As explained earlier, one of the major reasons why thermal decomposition of polymers is studied is because of its importance in terms of fire performance. This issue has been studied extensively.
Early on, Van Krevelen³³,34 showed that, for many polymers, the limiting oxygen index (LOI, an early measure of flammability)³⁵ could be linearly related to char yield as measured by TGA under specified conditions. Then, since Van Krevelen showed how to compute char yield to a good approximation from structural parameters, LOI should be computable; and for pure polymers having substantial char yields, it is fairly computable. Somewhat later, comparisons were made between the minimum decomposition temperature (or, even better, the temperature for 1 percent thermal decomposition) and the LOI.²,22 The conclusion was that, although in general low flammability resulted from high minimum thermal decomposition
Thermal Decomposition of Polymers | 1–123

temperatures, no easy comparison could be found between the two. There were some notable cases of polymers with both low thermal stability and low flammability. This type of approach has since fallen into disrepute, particularly in view of the lack of confidence remaining today in the LOI technique.³⁶ Table 1-7.4 shows some thermal decomposition temperatures and limiting oxygen indices²² as well as heat release rate values, the latter as measured in the cone calorimeter.³⁷,38 It is clear from the data in Table 1-7.4 that thermal decomposition is not a stand-alone means of predicting fire performance. Promising work in this regard is being made by Lyon,³⁹ who appears to be able to preliminarily predict some heat release information from thermoanalytical data.
However, mechanisms of action of fire retardants and potential effectiveness of fire retardants can be well predicted from thermal decomposition activity (for example, see Figures 1-7.4 and 1-7.5).²²,23 It is often necessary to have some additional understanding of the chemical reactions involved. In Figure 1-7.5, for example, the systems containing ABS, decabromobiphenyl, and either antimony oxide (c) or ferric oxide (g) have very similar TGA/DTG curves, with continuous weight loss. This indicates that the Sb system is effective but the iron one is not, because antimony bromide can volatilize while iron bromide does not. On the other hand, the system containing zinc oxide (f) is inefficient because the zinc bromide volatilizes too early, i.e., before the polymer starts breaking down. Some authors have used thermal decomposition techniques via the study of the resulting products to understand the mechanism of fire retardance (e.g., Grassie⁴⁰), or together with a variety of other techniques (e.g., Camino et al.⁴¹,42).
Whatever the detailed degree of predictability of fire performance data from thermal decomposition data, its importance should not be underestimated: polymers cannot burn if they do not break down.

Behavior of Individual Polymers

The discussion, thus far, has been general, focusing on the essential aspects of thermal decomposition without the complications that inevitably arise in the treatment of a particular polymer. This approach may also tend to make the concepts abstract. Through the treatment of individual polymers by polymer class, this section provides an opportunity to apply the general concepts to real materials. In general, the section is restricted to polymers of commercial importance. More complete and detailed surveys of polymers and their thermal decomposition can be found in the literature.²,30,43–52

Polyolefins

Of the polyolefins, low-density polyethylene (LDPE), high-density polyethylene (HDPE), and polypropylene (PP) are of the greatest commercial importance because of their production volume. Upon thermal decomposition, very little monomer formation is observed for any of these polymers; they form a large number of different small molecules (up to 70), mostly hydrocarbons. Thermal stability of polyolefins is strongly affected by branching, with linear polyethylene most stable and polymers with branching less stable. The order of stability is illustrated as follows:

H H | H CH3 H R | H R
|| | || | || | || —C—C>C—C>C—C>C—C —
HH | HH | H R | XZ

where R is any hydrocarbon group larger than a methyl group.

Polyethylene (PE): In an inert atmosphere, polyethylene begins to cross-link at 475 K and to decompose (reductions in molecular weight) at 565 K though extensive weight loss is not observed below 645 K. Piloted ignition of polyethylene due to radiative heating has been observed at a surface temperature of 640 K. The products of decomposition include a wide range of alkanes and alkenes. Branching of polyethylene causes enhanced intramolecular hydrogen transfer and results in lower thermal stability. The low-temperature molecular weight changes without volatilization are principally due to the scission of weak links, such as oxygen, incorporated into the main chain as impurities. Initiation reactions at higher temperatures involve scission of tertiary carbon bonds or ordinary carbon–carbon bonds in the beta position to tertiary carbons. The major products of decomposition are

1–124 | Fundamentals

Polymer

Polyacetal
Poly(methyl methacrylate)
Polypropylene
Polyethylene (LDPE)
Polyethylene (HDPE)
Polystyrene
ABS copolymer
Polybutadiene
Polyisoprene
Cotton
Poly(vinyl acohol)
Wool
Nylon-6
Silicone oil
Poly(vinylidene fluoride)
Poly(vinyl chloride)
Polytetrafluoroethylene

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
T1%b
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
LOIc
(-)

15.7
17.3
17.4
17.4
17.4
17.8
18.0
18.3
18.5
19.9
22.5
25.2
25.6
32
43.7
47
95

Pk RHRd
(kW/m²)

360
670
1500
800e
1400
1100
950e

450e

310e
1300
140e
30e
180
13

Table 1-7.4 Thermal Stability and Flammability of Polymers

aTd: Minimum thermal decomposition temperature from TGA (10-mg sample, 10-K/min heating rate, nitrogen atmosphere)²²
bT1%: Temperature for 1% thermal decomposition, conditions as above²²
c LOI: Limiting oxygen index²²
d Pk RHR: Peak rate of heat release in the cone calorimeter, at 40-kW/m² incident flux, at a thickness of 6 mm,³⁵ all under the same conditions.
ePk RHR: Peak rate of heat release in the cone calorimeter, at 40-kW/m² incident flux, from sources othre than those in footnote d.

propane, propene, ethane, ethene, butene, hexene-1, and butene-1. Propene is generated by intramolecular transfer to the second carbon and by scission of the bond beta to terminal =CH2 groups.
The intramolecular transfer route is most important, with molecular coiling effects contributing to its significance. A broad range of activation energies has been reported, depending on the percent conversion, the initial molecular weight, and whether the remaining mass or its molecular weight were monitored. Decomposition is strongly enhanced by the presence of oxygen, with significant effects detectable at 423 K in air.

Polypropylene (PP): In polypropylene, every other carbon atom in the main chain is a tertiary carbon, which is thus prone to attack. This lowers the stability of polypropylene as compared to polyethylene. As with polyethylene, chain scission and chain transfer reactions are important during decomposition. By far, secondary radicals (i.e., radical sites on the secondary carbon) are more important than primary radicals. This is shown by the major products formed, i.e., pentane (24 percent), 2 methyl-1-pentene (15 percent), and 2–4 dimethyl-1-heptene (19 percent). These are more easily formed from intramolecular hydrogen transfer involving secondary radicals. Reductions in molecular weight are first observed at 500 to 520 K and volatilization becomes significant above 575 K. Piloted ignition of polypropylene due to radiative heating has been observed at a surface temperature of 610 K. Oxygen drastically affects both the mechanism and rate of decomposition. The decomposition temperature is reduced by about 200 K, and the products of oxidative decomposition include mainly ketones. Unless the polymer samples are very thin (less than 0.25–0.30 mm or 0.010–0.012 in. thick), oxidative pyrolysis can be limited by diffusion of oxygen into the material. At temperatures below the melting point, polypropylene is more resistant to oxidative pyrolysis as oxygen diffusion into the material is inhibited by the higher density and crystallinity of polypropylene. Most authors have assumed that the oxidation mechanism is based on hydrocarbon oxidation, but recent work suggests that it may actually be due to the decomposition of peracids resulting from the oxidation of primary decomposition products.¹²

Polyacrylics

Poly(methyl methacrylate) (PMMA): PMMA is a favorite material for use in fire research since it decomposes almost solely to monomer, and burns at a very steady rate. Methyl groups effectively block intramolecular H transfer as discussed in the General Chemical Mechanisms section, leading to a high monomer yield. The method of polymerization can markedly affect the temperatures at which decomposition begins. Free-radical polymerized PMMA decomposes around 545 K, with initiation occurring at double bonds at chain ends. A second peak between 625 and 675 K in dynamic TGA thermograms is the result of a second initiation reaction. At these temperatures, initiation is by both end-chain and random-chain initiation processes. An ionically produced

PMMA decomposes at about 625 K because the end-chain initiation step does not occur due to the lack of double bonds at the chain end when PMMA is polymerized by this method. This may explain the range of observed piloted ignition temperatures (550 to 600 K). Decomposition of PMMA is first order with an activation energy of 120 to 200 kJ/mol, depending on the end group. The rate of decomposition is also dependent on the tacticity of the polymer and on its molecular weight. These effects can also have a profound effect on the flame spread rate.
It is interesting to note that a chemically cross-linked copolymer of PMMA was found to decompose by forming an extensive char, rather than undergoing end-chain scission which resulted in a polymer with greater thermal stability.⁵³

Poly(methyl acrylate) (PMA): Poly(methyl acrylate) decomposes by random-chain scission rather than end-chain scission, with almost no monomer formation. This results because of the lack of a methyl group blocking intramolecular hydrogen transfer as occurs in PMMA. Initiation is followed by intra- and intermolecular hydrogen transfer.

Polyacrylonitrile (PAN): PAN begins to decompose exothermically between 525 K and 625 K with the evolution of small amounts of ammonia and hydrogen cyanide. These products accompany cyclization reactions involving the creation of linkages between nitrogen and carbon on adjacent side groups. (See Figure 1-7.8.) The gaseous products are not the result of the cyclization itself, but arise from the splitting off of side or end groups not involved in the cyclization. The ammonia is derived principally from terminal imine groups (NH) while HCN results from side groups that do not participate in the polymerization-like cyclization reactions. When the polymer is not isotactic, the cyclization process is terminated when hydrogen is abstracted by the nitrogen atom. The cyclization process is reinitiated as shown in Figure 1-7.9.

Thermal Decomposition of Polymers | 1–125

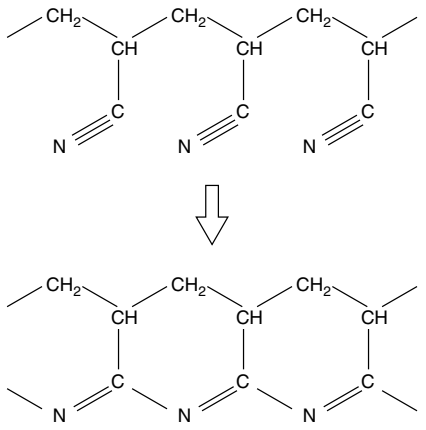
[picture p126: figure]

Figure 1-7.8. PAN cyclization.

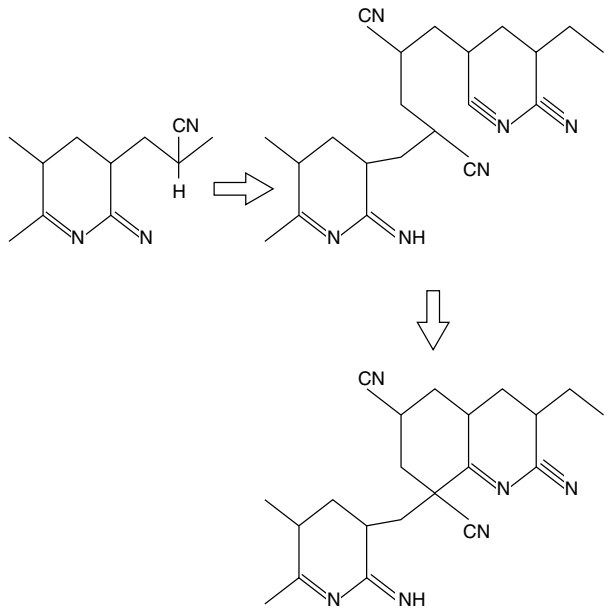
[picture p127: figure]

This leaves CN groups not involved in the cyclization which are ultimately removed and appear among the products as HCN. Typically, there are between 0 and 5 chain polymerization steps between each hydrogen abstraction. At temperatures of 625 to 975 K, hydrogen is evolved as the cyclic structures carbonize. At higher temperatures, nitrogen is evolved as the char becomes nearly pure carbon. In fact, with adequate control of the process, this method can be used to produce carbon fibers. Oxygen stabilizes PAN, probably by reacting with initiation sites for the nitrile polymerization. The products of oxidative decomposition are highly conjugated and contain ketonic groups.

Halogenated Polymers

Poly(vinyl chloride) (PVC): The most common halogenated polymer is PVC; it is one of the three most widely used polymers in the world, with polyethylene and polypropylene. Between 500 and 550 K, hydrogen chloride gas is evolved nearly quantitatively, by a chain-stripping mechanism. It is very important to point out, however, that the temperature at which hydrogen chloride starts being evolved in any measurable way is heavily dependent on the stabilization package used. Thus, commercial PVC “compounds” have been shown, in recent work, not to evolve hydrogen chloride until temperatures are in excess of 520 K and to have a dehydrochlorination stage starting at 600 K.⁵⁴ Between 700 and 750 K, hydrogen is evolved during carbonization, following cyclization of the species evolved. At higher temperatures, cross-linking between chains results in a fully carbonized residue. The rate of dehydrochlorination depends on the molecular weight, crystallinity, presence of oxygen, hydrogen chloride gas, and stabilizers. The presence of oxygen accelerates the dehydrochlorination process, produces main- chain scissions, and reduces cross-linking. At temperatures above 700 K, the char (resulting from dehydrochlorination and further dehydrogenation) is oxidized, leaving no residue. Lower molecular weight increases the rate of dehydrochlorination. Dehydrochlorination stabilizers include zinc, cadmium, lead, calcium, and barium soaps and organotin derivatives. The stability of model compounds indicates that weak links are important in decomposition. The thermal decomposition of this polymer has been one of the most widely studied ones. It has been the matter of considerable controversy, particularly in terms of explaining the evolution of aromatics in the second decomposition stage. The most recent evidence seems to point to a simultaneous cross-linking and intramolecular decomposition of the polyene segments resulting from dehydrochlorination, via polyene free radicals.⁵⁴ Earlier evidence suggested a Diels-Alder cyclization process (which can only be intramolecular if the double bond ends up in a “cis” orientation).⁵⁵ Evidence for this was given by the fact that smoke formation (inevitable consequence of the emission of aromatic hydrocarbons) was decreased by introducing cross-linking additives into the polymer.⁵⁶ Thus, it has now become clear that formation of any aromatic hydrocarbon occurs intramolecularly. The chemical mechanism for the initiation of dehydrochlorination was also reviewed a few years ago.⁵⁷ More recently, a series of papers was published investigating the kinetics of chain stripping, based on PVC.⁵⁸

Chlorinated poly(vinyl chloride) (CPVC): One interesting derivative of PVC is chlorinated PVC (CPVC), resulting from post-polymerization chlorination of PVC. It decomposes at a much higher temperature than PVC, but by the same chain-stripping mechanism. The resulting solid is a polyacetylene, which gives off much less smoke than PVC and is also more difficult to burn.⁵⁹

Poly(tetrafluoroethylene) (PTFE): PTFE is a very stable polymer due to the strength of C–F bonds and shielding by the very electronegative fluorine atoms. Decomposition starts occurring between 750 and 800 K. The principal product of decomposition is the monomer, CF4, with small amounts of hydrogen fluoride and hexafluoropropene. Decomposition is initiated by random-chain scission, followed by depolymerization. Termination is by disproportionation. It is possible that the actual product of decomposition is CF2, which immediately forms in the gas phase. The stability of the polymer can be further enhanced by promoting chain transfer reactions that can effectively limit the zip length. Under conditions of oxidative pyrolysis, no monomer is formed. Oxygen reacts with the polymeric radical, releasing carbon monoxide, carbon dioxide, and other products.
Other fluorinated polymers are less stable than PTFE and are generally no more stable than their unfluorinated analogs. However, the fluorinated polymers are more stable in an oxidizing atmosphere. Hydrofluorinated polymers produce hydrogen fluoride directly by chain-stripping reactions, but the source of hydrogen fluoride by perfluorinated polymers, such as PTFE, is less clear. It is
1–126 | Fundamentals

Figure 1-7.9. Reinitiation of PAN side-chain cyclization.

related to the reaction of the decomposition products (including tetrafluoroethylene) with atmospheric humidity.

Other Vinyl Polymers

Several other vinyl polymers decompose by mechanisms similar to that of PVC: all those that have a single substituent other than a hydrogen atom on the basic repeating unit. These include poly(vinyl acetate), poly(vinyl alcohol), and poly(vinyl bromide), and result in gas evolution of acetic acid, water, and hydrogen bromide, respectively. While the chain-stripping reactions of each of these polymers occur at different temperatures, all of them aromatize by hydrogen evolution at roughly 720 K.

Styrenics: Polystyrene (PS). Polystyrene shows no appreciable weight loss below 575 K, though there is a decrease in molecular weight due to scission of “weak” links. Above this temperature, the products are primarily monomer with decreasing amounts of dimer, trimer, and tetramer. There is an initial sharp decrease in molecular weight followed by slower rates of molecular weight decrease. The mechanism is thought to be dominated by end-chain initiation, depolymerization, intramolecular hydrogen transfer, and bimolecular termination. The changes in molecular weight are principally due to intermolecular transfer reactions while volatilization is dominated by intramolecular transfer reactions. Depropagation is prevalent despite the lack of steric hindrance due to the stabilizing effect of the electron delocalization associated with the aromatic side group. The addition of an alpha methyl group to form poly(a-methylstyrene) provides additional steric hindrance such that only monomer is produced during decomposition while the thermal stability of the polymer is lessened. Free-radical polymerized polystyrene is less stable than an ionic polystyrene with the rate of decomposition dependent on the end group. Other styrenics tend to be copolymers of polsytyrene with acrylonitrile (SAN), acrylonitrile and butadiene (ABS), or methyl methacrylate and butadiene (MBS), and their decomposition mechanisms are hybrids between those of the individual polymers.

Synthetic Carbon–Oxygen Chain Polymers

Poly(ethylene terephthalate) (PET): PET decomposition is initiated by scission of an alkyl–oxygen bond. The decomposition kinetics suggest a random-chain scission. Principal gaseous products observed are acetaldehyde, water, carbon monoxide, carbon dioxide, and compounds with acid and anhydride end groups. The decomposition is accelerated by the presence of oxygen. Recent evidence indicates that both PET and PBT [poly(butylene terephthalate)] decompose via the formation of cyclic or openchain oligomers, with olefinic or carboxylic end groups.⁶⁰

Polycarbonates (PC): Polycarbonates yield substantial amounts of char if products of decomposition can be removed (the normal situation). If volatile products are not removed, no cross-linking is observed due to competition between condensation and hydrolysis reactions. The decomposition is initiated by scission of the weak O–CO2 bond, and the volatile products include 35 percent carbon dioxide. Other major products include bisphenol A and phenol. The decomposition mechanism seems to be a mixture of random-chain scission and cross-linking, initiated intramolecularly.⁶¹ Decomposition begins at 650 to 735 K, depending on the exact structure of the polycarbonate in question.
Blends of polycarbonate and styrenics (such as ABS) make up a set of engineered thermoplastics. Their properties are intermediate between those of the forming individual polymers, both in terms of physical properties (and processability) and in terms of their modes of thermal breakdown.

Phenolic resins: Phenolic resin decomposition begins at 575 K and is initiated by the scission of the methylene– benzene ring bond. At 633 K, the major products are C3 compounds. In continued heating (725 K and higher), char (carbonization), carbon oxides, and water are formed. Above 770 K, a range of aromatic, condensable products are evolved. Above 1075 K, ring breaking yields methane and carbon oxides. In TGA experiments at 3.3°C/min, the char yield is 50 to 60 percent. The weight loss at 700 K is 10 percent. All decomposition is oxidative in nature (oxygen provided by the polymer itself).

Polyoxymethylene (POM): Polyoxymethylene decomposition yields formaldehyde almost quantitatively. The decomposition results from end-chain initiation followed by depolymerization. The presence of oxygen in the chain prevents intramolecular hydrogen transfer quite effectively. With hydroxyl end groups, decomposition may begin at temperatures as low as 360 K while with ester end groups decomposition may be delayed to 525 K. Piloted ignition due to radiative heating has been observed at a surface temperature of 550 K. Acetylation of the chain end group also improves stability. Upon blocking the chain ends, decomposition is by random-chain initiation, followed by depolymerization with the zip length less than the degree of polymerization. Some chain transfer occurs. Amorphous polyoxymethylene decomposes faster than crystalline polyoxymethylene, presumably due to the lack of stabilizing intermolecular forces associated with the crystalline state (below the melting temperature). Incorporating oxyethylene in polyoxymethylene improves stability, presumably due to H transfer reactions that stop unzipping. Oxidative pyrolysis begins at 430 K and leads to formaldehyde, carbon monoxide, carbon dioxide, hydrogen, and water vapor.

Epoxy resins: Epoxy resins are less stable than phenolic resins, polycarbonate, polyphenylene sulphide, and polytetrafluoroethelyne. The decomposition mechanism is complex and varied and usually yields mainly phenolic compounds. A review of epoxy resin decomposition can be found in Lee.⁴³

Polyamide Polymers

Nylons: The principal gaseous products of decomposition of nylons are carbon dioxide and water. Nylon 6

Thermal Decomposition of Polymers | 1–127

produces small amounts of various simple hydrocarbons while Nylon 6–10 produces notable amounts of hexadienes and hexene. As a class, nylons do not notably decompose below 615 K. Nylon 6–6 melts between 529 and 532 K, and decomposition begins at 615 K in air and 695 K in nitrogen. At temperatures in the range 625 to 650 K, random-chain scissions lead to oligomers. The C–N bonds are the weakest in the chain, but the CO–CH2 bond is also quite weak, and both are involved in decomposition. At low temperatures, most of the decomposition products are nonvolatile, though above 660 K main chain scissions lead to monomer and some dimer and trimer production. Nylon 6–6 is less stable than nylon 6–10, due to the ring closure tendency of the adipic acid component. At 675 K, if products are removed, gelation and discoloration begin.
Aromatic polyamides have good thermal stability, as exemplified by Nomex, which is generally stable in air to 725 K. The major gaseous products of decomposition at low temperatures are water and carbon oxides. At higher temperatures, carbon monoxide, benzene, hydrogen cyanide (HCN), toluene, and benzonitrile are produced. Above 825 K, hydrogen and ammonia are formed. The remaining residue is highly cross-linked.

Wool: On decomposition of wool, a natural polyamide, approximately 30 percent is left as a residue. The first step in decomposition is the loss of water. Around 435 K, some cross-linking of amino acids occurs. Between 485 and 565 K, the disulphide bond in the amino acid cystine is cleaved with carbon disulphide and carbon dioxide being evolved. Pyrolysis at higher temperatures (873 to 1198 K) yields large amounts of hydrogen cyanide, benzene, toluene, and carbon oxides.

Polyurethanes As a class, polyurethanes do not break down below 475 K, and air tends to slow decomposition. The production of hydrogen cyanide and carbon monoxide increases with the pyrolysis temperature. Other toxic products formed include nitrogen oxides, nitriles, and tolylene diisocyanate (TDI) (and other isocyanates). A major breakdown mechanism in urethanes is the scission of the polyol–isocyanate bond formed during polymerization. The isocyanate vaporizes and recondenses as a smoke, and liquid polyol remains to further decompose.

Polydienes and Rubbers

Polyisoprene: Synthetic rubber or polyisoprene decomposes by random-chain scission with intramolecular hydrogen transfer. This, of course, gives small yields of monomer. Other polydienes appear to decompose similarly though the thermal stability can be considerably different. The average size of fragments collected from isoprene decomposition are 8 to 10 monomer units long. This supports the theory that random-chain scission and intermolecular transfer reactions are dominant in the decomposition mechanism. In nitrogen, decomposition begins at 475 K. At temperatures above 675 K, increases in monomer yield are attributable to secondary reaction of volatile products to form monomer. Between 475 and 575 K, low molecular weight material is formed, and the residual material is progressively more insoluble and intractable. Preheating at between 475 and 575 K lowers the monomer yield at higher temperatures. Decomposition at less than 575 K results in a viscous liquid and, ultimately, a dry solid. The monomer is prone to dimerize to dipentene as it cools. There seems to be little significant difference in the decomposition of natural rubber and synthetic polyisoprene.

Polybutadiene: Polybutadiene is more thermally stable than polyisoprene due to the lack of branching. Decomposition at 600 K can lead to monomer yields of up to 60 percent, with lower conversions at higher temperatures. Some cyclization occurs in the products. Decomposition in air at 525 K leads to a dark impermeable crust, which excludes further air. Continued heating hardens the elastomer.

Polychloroprene: Polychloroprene decomposes in a manner similar to PVC, with initial evolution of hydrogen chloride at around 615 K and subsequent breakdown of the residual polyene. The sequences of the polyene are typically around three (trienes), much shorter than PVC. Polychloroprene melts at around 50°C.

Cellulosics

The decomposition of cellulose involves at least four processes in addition to simple desorption of physically bound water. The first is the cross-linking of cellulose chains, with the evolution of water (dehydration). The second concurrent reaction is the unzipping of the cellulose chain. Laevoglucosan is formed from the monomer unit. (See Figure 1-7.10.) The third reaction is the decomposition of the dehydrated product (dehydrocellulose) to yield char and volatile products. Finally, the laevoglucosan can further decompose to yield smaller volatile products, including tars and, eventually, carbon monoxide. Some laevoglucosan may also repolymerize.
Below 550 K, the dehydration reaction and the unzipping reaction proceed at comparable rates, and the basic skeletal structure of the cellulose is retained. At higher temperatures, unzipping is faster, and the original structure of the cellulose begins to disappear. The cross-linked dehydrated cellulose and the repolymerized laevoglucosan begin to yield polynuclear aromatic structures, and graphite carbon structures form at around 770 K. It is well known that the char yield is quite dependent on the rate of heating of the sample. At very high rates of heating, no char is formed. On the other hand, preheating the sample at 520 K will lead to 30 percent char yields. This is due both to the importance of the low-temperature dehydration reactions for ultimate char formation and the increased opportunity for repolymerization of laevoglucosan that accompanies slower heating rates.
Wood is made up of 50 percent cellulose, 25 percent hemicellulose, and 25 percent lignin. The yields of gaseous products and kinetic data indicate that the decomposition may be regarded as the superposition of the individual constituent’s decomposition mechanisms. On heating, the hemicellulose decomposes first (475 to 535
1–128 | Fundamentals

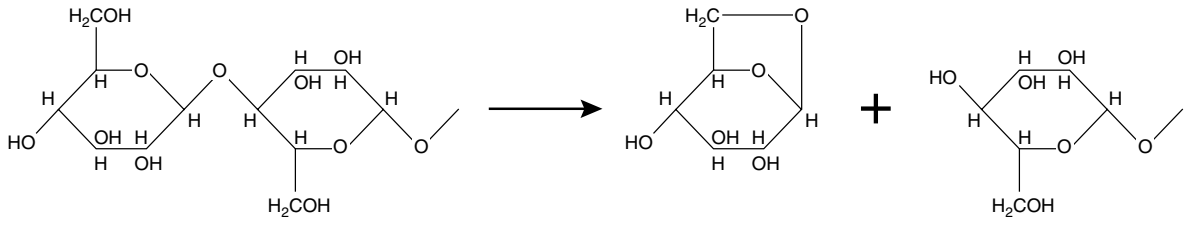
[picture p128: figure]
H2COH

K), followed by cellulose (525 to 625 K), and lignin (555 to 775 K). The decomposition of lignin contributes significantly to the overall char yield. Piloted ignition of woods due to radiative heating has been observed at a surface temperature of 620 to 650 K.

Polysulfides and Polysulphones

Polysulfides are generally stable to 675 K. Poly(1, 4 phenylene sulfide) decomposes at 775 K. Below this temperature, the principal volatile product is hydrogen sulfide. Above 775 K, hydrogen, evolved in the course of cross-linking, is the major volatile product. In air, the gaseous products include carbon oxides and sulfur dioxide. The decomposition of polysulphones is analogous to polycarbonates. Below 575 K, decomposition is by heteroatom bridge cleavage, and above 575 K, sulfur dioxide is evolved from the polymer backbone.

Thermally Stable Polymers

The development of thermally stable polymers is an area of extensive ongoing interest. Relative to many other materials, polymers have fairly low use temperatures, which can reduce the utility of the product. This probable improvement in fire properties is, often, counterbalanced by a decrease in processability and in favorable physical properties. Of course, materials that are stable at high temperatures are likely to be better performers as far as fire properties are concerned. The high- temperature physical properties of polymers can be improved by increasing interactions between polymer chains or by chain-stiffening. Chain interactions can be enhanced by several means. As noted previously, crystalline materials are more stable than their amorphous counterparts as a result of chain interactions. Of course, if a material melts before volatilization occurs, this difference will not affect chemical decomposition. Isotactic polymers are more likely to be crystalline due to increased regularity of structure. Polar side groups can also increase the interaction of polymer chains. The melting point of some crystalline polymers is shown in Table 1-7.1.
The softening temperature can also be increased by chain-stiffening. This is accomplished by the use of aromatic or heterocyclic structures in the polymer backbone. Some aromatic polymers are shown in Figure 1-7.11. Poly(p-phenylene) is quite thermally stable but is brittle, insoluble, and infusible. Thermal decomposition begins at 870 to 920 K; and up to 1170 K, only 20 to 30 percent of the original weight is lost. Introduction of the following groups:

–O–, –CO–, –NH–, –CH2–, –O–CO–, –O–CO–O–

into the chain can improve workability though at the cost of some loss of oxidative resistance. Poly(p-xylene) melts at 675 K and has good mechanical properties though it is insoluble and cannot be thermoprocessed. Substitution of halogen, acetyl, alkyl, or ester groups on aromatic rings can help the solubility of these polymers at the expense of some stability. Several relatively thermostable polymers can be formed by condensation of bisphenol A with a second reagent. Some of these are shown in Figure 1–7.12. The stability of such polymers can be improved if aliphatic groups are not included in the backbone, as the –C(CH3)2– groups are weak links.
Other thermostable polymers include ladder polymers and extensively cross-linked polymers. Cyclized PAN is an example of a ladder polymer where two chains are periodically interlinked. Other polymers, such as rigid polyurethanes, are sufficiently cross-linked so that it becomes impossible to speak of a molecular weight or
Thermal Decomposition of Polymers | 1–129

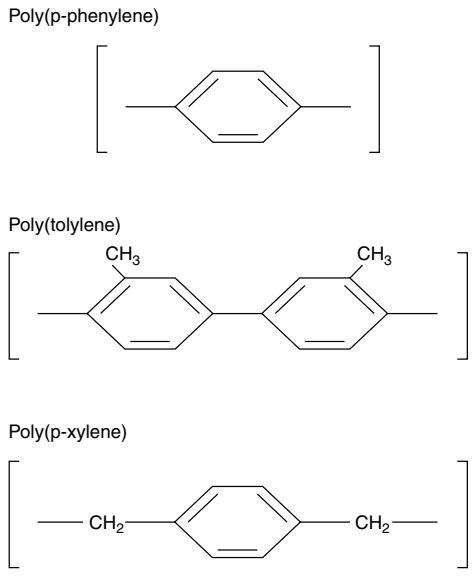
[picture p129: figure]
Poly(p-phenylene); Poly(tolylene); Poly(p-xylene)

Figure 1-7.11. Thermostable aromatic polymers.

Figure 1-7.10. Formation of laevoglucosan from cellulose.

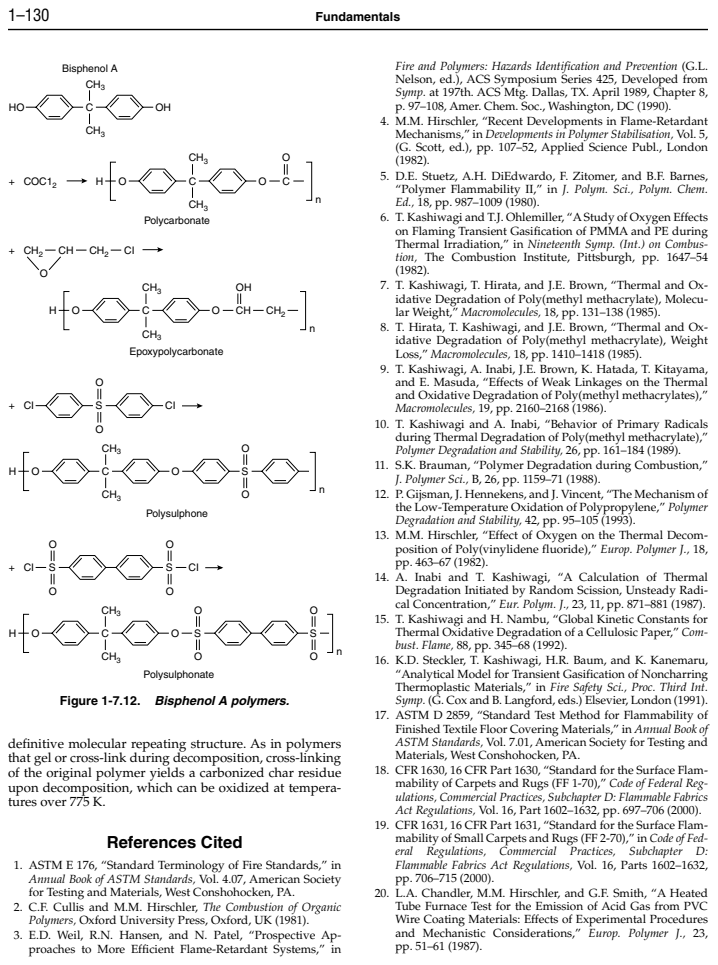
[picture p130: page 21]
References Cited; Fundamentals; Bisphenol A; Polycarbonate; + COC12; Epoxypolycarbonate; Polysulphone; Polysulphonate

Fire and Polymers: Hazards Identification and Prevention (G.L.
Nelson, ed.), ACS Symposium Series 425, Developed from
Symp. at 197th. ACS Mtg. Dallas, TX. April 1989, Chapter 8,
p. 97–108, Amer. Chem. Soc., Washington, DC (1990).
4. M.M. Hirschler, “Recent Developments in Flame-Retardant
Mechanisms,” in Developments in Polymer Stabilisation, Vol. 5,
(G. Scott, ed.), pp. 107–52, Applied Science Publ., London
5. D.E. Stuetz, A.H. DiEdwardo, F. Zitomer, and B.F. Barnes,
“Polymer Flammability II,” in J. Polym. Sci., Polym. Chem.
6. T. Kashiwagi and T.J. Ohlemiller, “A Study of Oxygen Effects
on Flaming Transient Gasification of PMMA and PE during
Thermal Irradiation,” in Nineteenth Symp. (Int.) on Combus-
tion, The Combustion Institute, Pittsburgh, pp. 1647–54
7. T. Kashiwagi, T. Hirata, and J.E. Brown, “Thermal and Ox-
idative Degradation of Poly(methyl methacrylate), Molecu-
lar Weight,” Macromolecules, 18, pp. 131–138 (1985).
8. T. Hirata, T. Kashiwagi, and J.E. Brown, “Thermal and Ox-
idative Degradation of Poly(methyl methacrylate), Weight
Loss,” Macromolecules, 18, pp. 1410–1418 (1985).
9. T. Kashiwagi, A. Inabi, J.E. Brown, K. Hatada, T. Kitayama,
and E. Masuda, “Effects of Weak Linkages on the Thermal
and Oxidative Degradation of Poly(methyl methacrylates),”
Macromolecules, 19, pp. 2160–2168 (1986).
10. T. Kashiwagi and A. Inabi, “Behavior of Primary Radicals
during Thermal Degradation of Poly(methyl methacrylate),”
Polymer Degradation and Stability, 26, pp. 161–184 (1989).
11. S.K. Brauman, “Polymer Degradation during Combustion,”

J. Polymer Sci., B, 26, pp. 1159–71 (1988).
12. P. Gijsman, J. Hennekens, and J. Vincent, “The Mechanism of
the Low-Temperature Oxidation of Polypropylene,” Polymer
Degradation and Stability, 42, pp. 95–105 (1993).
13. M.M. Hirschler, “Effect of Oxygen on the Thermal Decom-
position of Poly(vinylidene fluoride),” Europ. Polymer J., 18,
14. A. Inabi and T. Kashiwagi, “A Calculation of Thermal
Degradation Initiated by Random Scission, Unsteady Radi-
cal Concentration,” Eur. Polym. J., 23, 11, pp. 871–881 (1987).
15. T. Kashiwagi and H. Nambu, “Global Kinetic Constants for
Thermal Oxidative Degradation of a Cellulosic Paper,” Com-
bust. Flame, 88, pp. 345–68 (1992).
16. K.D. Steckler, T. Kashiwagi, H.R. Baum, and K. Kanemaru,
“Analytical Model for Transient Gasification of Noncharring
Thermoplastic Materials,” in Fire Safety Sci., Proc. Third Int.
Symp. (G. Cox and B. Langford, eds.) Elsevier, London (1991).
17. ASTM D 2859, “Standard Test Method for Flammability of
Finished Textile Floor Covering Materials,” in Annual Book of
ASTM Standards, Vol. 7.01, American Society for Testing and
Materials, West Conshohocken, PA.
18. CFR 1630, 16 CFR Part 1630, “Standard for the Surface Flam-
mability of Carpets and Rugs (FF 1-70),” Code of Federal Reg-
ulations, Commercial Practices, Subchapter D: Flammable Fabrics
Act Regulations, Vol. 16, Part 1602–1632, pp. 697–706 (2000).
19. CFR 1631, 16 CFR Part 1631, “Standard for the Surface Flam-
mability of Small Carpets and Rugs (FF 2-70),” in Code of Fed-
eral Regulations, Commercial Practices, Subchapter D:
Flammable Fabrics Act Regulations, Vol. 16, Parts 1602–1632,
20. L.A. Chandler, M.M. Hirschler, and G.F. Smith, “A Heated
Tube Furnace Test for the Emission of Acid Gas from PVC
Wire Coating Materials: Effects of Experimental Procedures
and Mechanistic Considerations,” Europ. Polymer J., 23,

Figure 1-7.12. Bisphenol A polymers.

definitive molecular repeating structure. As in polymers
that gel or cross-link during decomposition, cross-linking
of the original polymer yields a carbonized char residue
upon decomposition, which can be oxidized at tempera-
tures over 775 K.

1. ASTM E 176, “Standard Terminology of Fire Standards,” in
Annual Book of ASTM Standards, Vol. 4.07, American Society
for Testing and Materials, West Conshohocken, PA.
2. C.F. Cullis and M.M. Hirschler, The Combustion of Organic
Polymers, Oxford University Press, Oxford, UK (1981).
3. E.D. Weil, R.N. Hansen, and N. Patel, “Prospective Ap-
proaches to More Efficient Flame-Retardant Systems,” in

21. M.M. Hirschler, “Thermal Decomposition (STA and DSC) of Poly(vinyl chloride) Compounds under a Variety of Atmospheres and Heating Rates,” Europ. Polymer J., 22, pp. 153–60 (1986).
22. C.F. Cullis and M.M. Hirschler, “The Significance of Thermoanalytical Measurements in the Assessment of Polymer Flammability,” Polymer, 24, pp. 834–40 (1983).
23. M.M. Hirschler, “Thermal Analysis and Flammability of Polymers: Effect of Halogen-Metal Additive Systems,” Europ. Polymer J., 19, pp. 121–9 (1983).
24. I.C. McNeill, “The Application of Thermal Volatilization Analysis to Studies of Polymer Degradation,” in Developments in Polymer Degradation, Vol. 1 (N. Grassie, ed.), p. 43, Applied Science, London (1977).
25. C.F. Cullis, M.M. Hirschler, R.P. Townsend, and V. Visanuvimol, “The Pyrolysis of Cellulose under Conditions of Rapid Heating,” Combust. Flame, 49, pp. 235–48 (1983).
26. C.F. Cullis, M.M. Hirschler, R.P. Townsend, and V. Visanuvimol, “The Combustion of Cellulose under Conditions of Rapid Heating,” Combust. Flame, 49, pp. 249–54 (1983).
27. C.F. Cullis, D. Goring, and M.M. Hirschler, “Combustion of Cigarette Paper under Conditions Similar to Those during Smoking,” Chichester, UK (1984). Cellucon ‘84 (Macro Group U.K.), Wrexham (Wales), Chapter 35, pp. 401–10, Ellis Horwood, Chichester, UK (1984).
28. P.J. Baldry, C.F. Cullis, D. Goring, and M.M. Hirschler, “The Pyrolysis and Combustion of Cigarette Constituents,” in Proc. Int. Conf. on “Physical and Chemical Processes Occurring in a Burning Cigarette,” R.J. Reynolds Tobacco Co., Winston-Salem, NC, pp. 280–301 (1987).
29. P.J. Baldry, C.F. Cullis, D. Goring, and M.M. Hirschler, “The Combustion of Cigarette Paper,” Fire and Materials, 12, pp. 25–33 (1988).
30. L. Reich and S.S. Stivala, Elements of Polymer Degradation, McGraw-Hill, New York (1971).
31. A.A. Miroshnichenko, M.S. Platitsa, and T.P. Nikolayeva, “Technique for Calculating the Temperature at the Beginning and End of Polymer Thermal Degradation from Structural Data,” in Polymer Science (USSR) 30, 12, pp. 2707–16 (1988).
32. O.F. Shlenskii and N.N. Lyasnikova, “Predicting the Temperature of Thermal Decomposition of Linear Polymers,” Intern. Polymer Sci. Technol., 16, 3, pp. T55–T56 (1989).
33. D.W. Van Krevelen, “Thermal Decomposition” and “Product Properties, Environmental Behavior and Failure,” in Properties of Polymers, 3rd Edition, Elsevier, Amsterdam, pp. 641–653 and 725–743 (1990).
34. D.W. Van Krevelen, “Some Basic Aspects of Flame Resistance of Polymeric Materials,” Polymer, 16, pp. 615–620 (1975).
35. ASTM D 2863, “Standard Method for Measuring the Minimum Oxygen Concentration to Support Candle-like Combustion of Plastics (Oxygen Index),” Annual Book of ASTM Standards, Vol. 8.02, American Society for Testing and Materials, West Conshohocken, PA.
36. E.D. Weil, M.M. Hirschler, N.G. Patel, M.M. Said, and S. Shakir, “Oxygen Index: Correlation to Other Tests,” Fire Materials, 16, pp. 159–67 (1992).
37. ASTM E 1354, “Standard Test Method for Heat and Visible Smoke Release Rates for Materials and Products Using an Oxygen Consumption Calorimeter,” in Annual Book of ASTM Standards, Volume 4.07, American Society for Testing and Materials, West Conshohocken, PA.
38. M.M. Hirschler, “Heat Release from Plastic Materials,” Chapter 12a in Heat Release in Fires (V. Babrauskas and S.J. Grayson, eds.), Elsevier, London (1992).
39. R.E. Lyon, “Fire-Safe Aircraft Materials” in Fire and Materials, Proceeding 3rd Int. Conference and Exhibition, Crystal City, VA, Interscience Communications, pp. 167–177 (1994).
40. N. Grassie, “Polymer Degradation and Fire Hazard,” Polymer Degradation and Stability, 30, pp. 3–12 (1990).
41. G. Camino and L. Costa, “Performance and Mechanisms of Fire Retardants in Polymers—A Review,” Polymer Degradation and Stability, 20, pp. 271–294 (1988).
42. G. Bertelli, L. Costa, S. Fenza, F.E. Marchetti, G. Camino, and
R. Locatelli, “Thermal Behaviour of Bromine-Metal Fire Retardant Systems,” Polymer Degradation and Stability, 20, pp. 295–314 (1988).
43. L.H. Lee, J. Polymer Sci., 3, p. 859 (1965).
44. R.T. Conley, ed., Thermal Stability of Polymers, Marcel Dekker, New York (1970).
45. W.J. Roff and J.R. Scott, Fibres, Films, Plastics, and Rubbers, Butterworths, London (1971).
46. F.A. Williams, in Heat Transfer in Fires, Scripta, Washington, DC (1974).
47. C. David, in Comprehensive Chemical Kinetics, Elsevier, Amsterdam (1975).
48. S.L. Madorsky, Thermal Degradation of Polymers, reprinted by Robert E. Kreiger, New York (1975).
49. D.W. Van Krevelen, Properties of Polymers, Elsevier, Amsterdam (1976).
50. T. Kelen, Polymer Degradation, Van Nostrand Reinhold, New York (1983).
51. W.L. Hawkins, Polymer Degradation and Stabilization, Springer Verlag, Berlin (1984).
52. N. Grassie and G. Scott, Polymer Degradation and Stabilisation, Cambridge University Press, Cambridge, UK (1985).
53. S.M. Lomakin, J.E. Brown, R.S. Breese, and M.R. Nyden, “An Investigation of the Thermal Stability and Char-Forming Tendency of Cross-Linked Poly(methyl methacrylate),” Polymer Degradation Stability, 41, pp. 229–43 (1993).
54. G. Montaudo and C. Puglisi, “Evolution of Aromatics in the Thermal Degradation of Poly(vinyl chloride): A Mechanistic Study,” Polymer Degradation Stability, 33, pp. 229–62 (1991).
55. W.H. Starnes, Jr., and D. Edelson, Macromolecules, 12, p. 797 (1979).
56. D. Edelson, R.M. Lum, W.D. Reents, Jr., W.H. Starnes, Jr., and L.D. Westcott, Jr., “New Insights into the Flame Retardance Chemistry of Poly(vinyl chloride),” in Proc. Nineteenth (Int.) Symp. on Combustion, The Combustion Institute, Pittsburgh, pp. 807–814 (1982).
57. K.S. Minsker, S.V. Klesov, V.M. Yanborisov, A.A. Berlin, and G.E. Zaikov, “The Reason for the Low Stability of Poly(vinyl chloride)—A Review,” Polymer Degradation Stability, 16, pp. 99–133 (1986).
58. P. Simon et al., “Kinetics of Polymer Degradation Involving the Splitting off of Small Molecules, Parts 1–7,” Polymer Degradation Stability, 29, pp. 155; 253; 263 (1990); pp. 35, 45; 157; 249 (1992); pp. 36, 85 (1992).
59. L.A. Chandler and M.M. Hirschler, “Further Chlorination of Poly(vinyl chloride): Effects on Flammability and Smoke Production Tendency,” Europ. Polymer J., 23, pp. 677–83 (1987).
60. G. Montaudo, C. Puglisi, and F. Samperi, “Primary Thermal Degradation Mechanisms of PET and PBT,” Polymer Degradation Stability, 42, pp. 13–28 (1993).
61. G. Montaudo, C. Puglisi, R. Rapisardi, and F. Samperi, “Further Studies on the Thermal Decomposition Processes in Polycarbonates,” Polymer Degradation Stability, 31, pp. 229–46 (1991).
Thermal Decomposition of Polymers | 1–131
