joshuartaylor/TheRecreator3D/Recreator3D Build Files/Recreator3D - MK3 - Lite and Pro Files/Modifications/Colorizer/NOTES.txt

Order 2 Sets of the following

16 Pieces Mini Permanent Markers for Nurses Badge, 
8 Assorted Colors Mini Markers 

https://amzn.to/3uYV6rz #ad
