joshuartaylor/TheRecreator3D/Operation Manual, Guides, and Info/INFO - CNC Kitchen - Hook.png

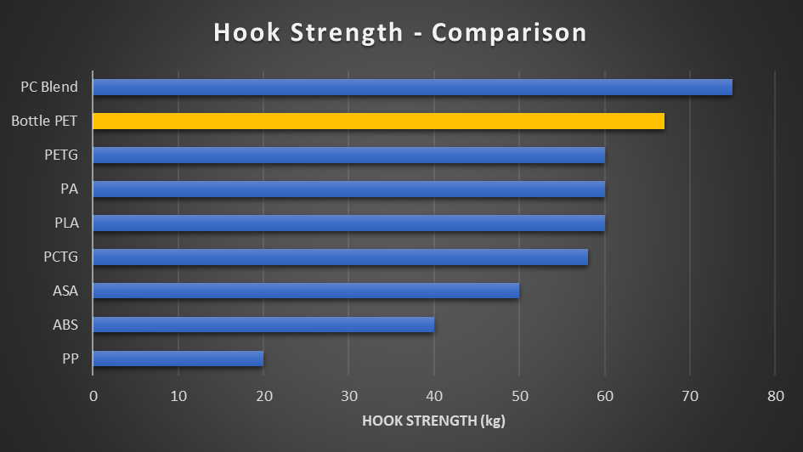
Operation Manual, Guides, and Info/INFO - CNC Kitchen - Hook.png
