joshuartaylor/TheRecreator3D/Operation Manual, Guides, and Info/INFO - CNC Kitchen - Impact.png

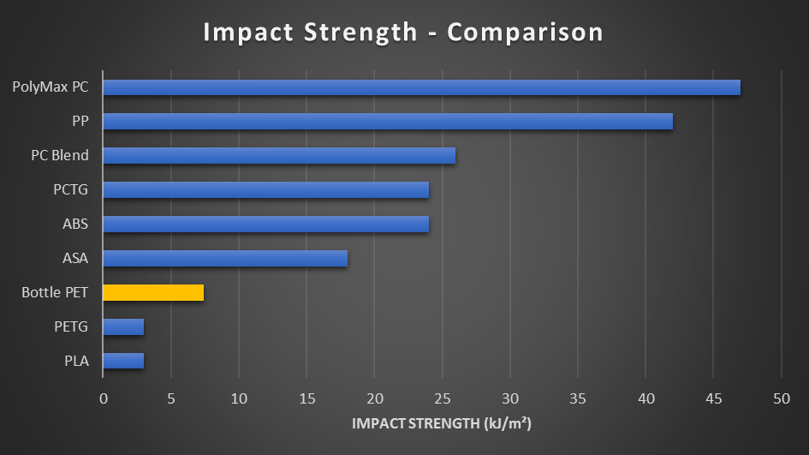
Operation Manual, Guides, and Info/INFO - CNC Kitchen - Impact.png
