joshuartaylor/TheRecreator3D/Operation Manual, Guides, and Info/INFO - CNC Kitchen - PET1 Close-Up.jpg

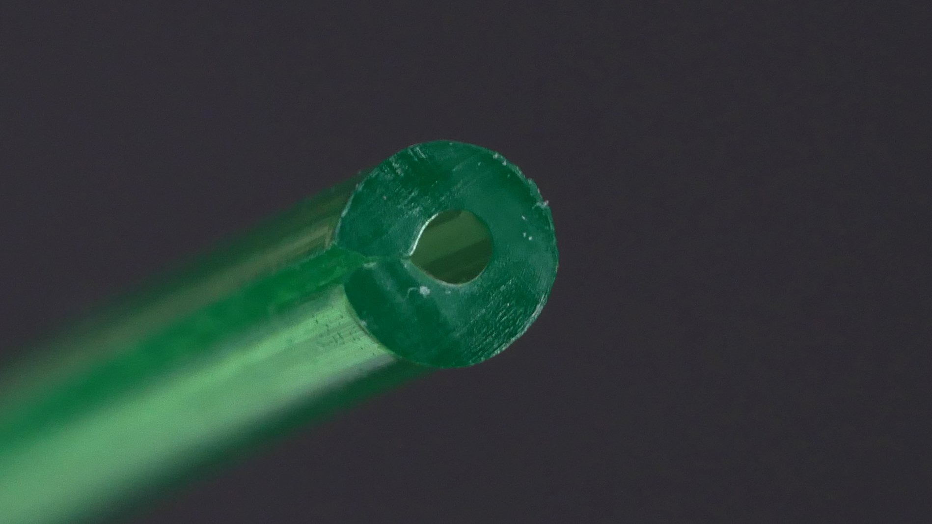
Operation Manual, Guides, and Info/INFO - CNC Kitchen - PET1 Close-Up.jpg
