joshuartaylor/TheRecreator3D/Print Examples/198168142_505904084164499_4210720091275597367_n.jpg

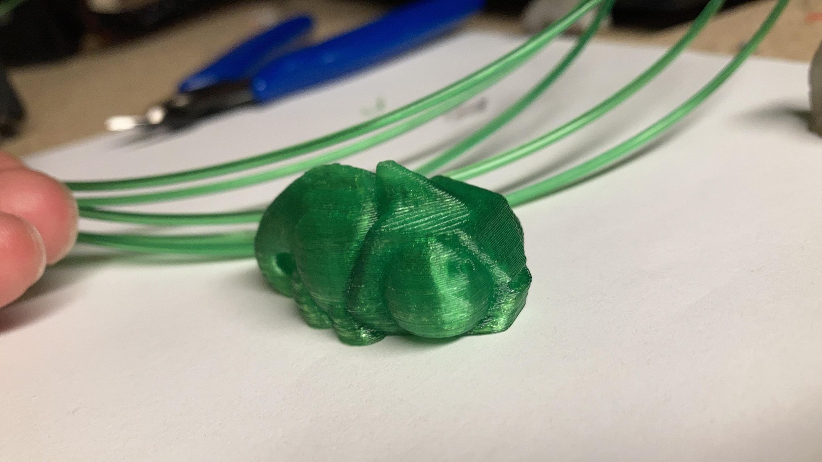
Print Examples/198168142_505904084164499_4210720091275597367_n.jpg
