joshuartaylor/TheRecreator3D/Print Examples/203123684_1598282627041252_3410335056933935683_n.jpg

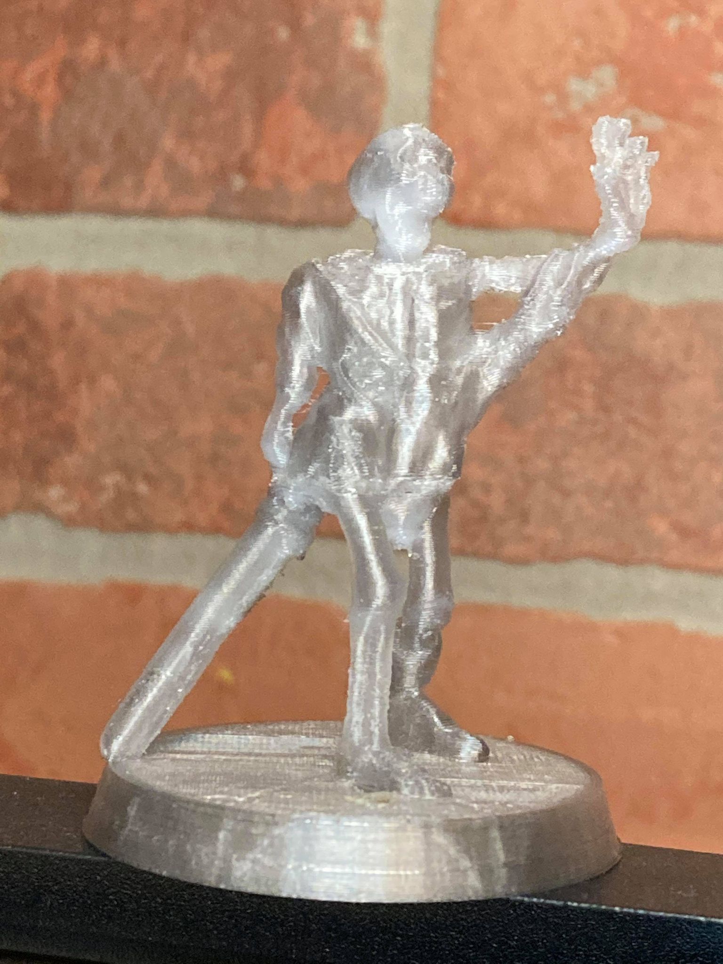
Print Examples/203123684_1598282627041252_3410335056933935683_n.jpg
