joshuartaylor/TheRecreator3D/Print Examples/203613904_10226461705308201_8478772641466851917_n.jpg

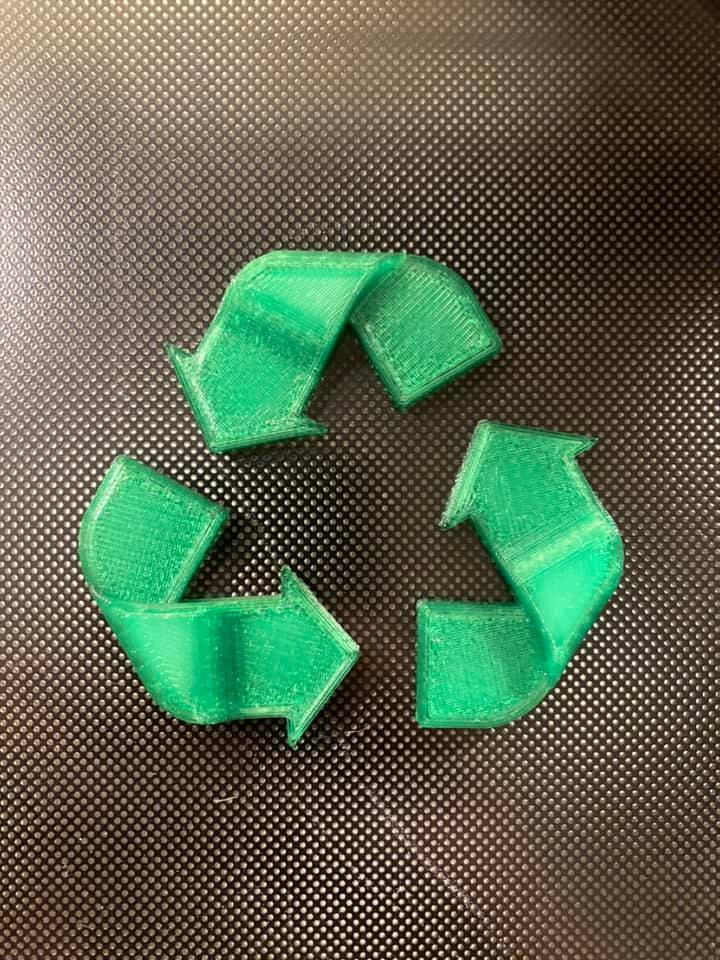
Print Examples/203613904_10226461705308201_8478772641466851917_n.jpg
