joshuartaylor/TheRecreator3D/Print Examples/206467332_10226486084957677_5568983026057247678_n.jpg

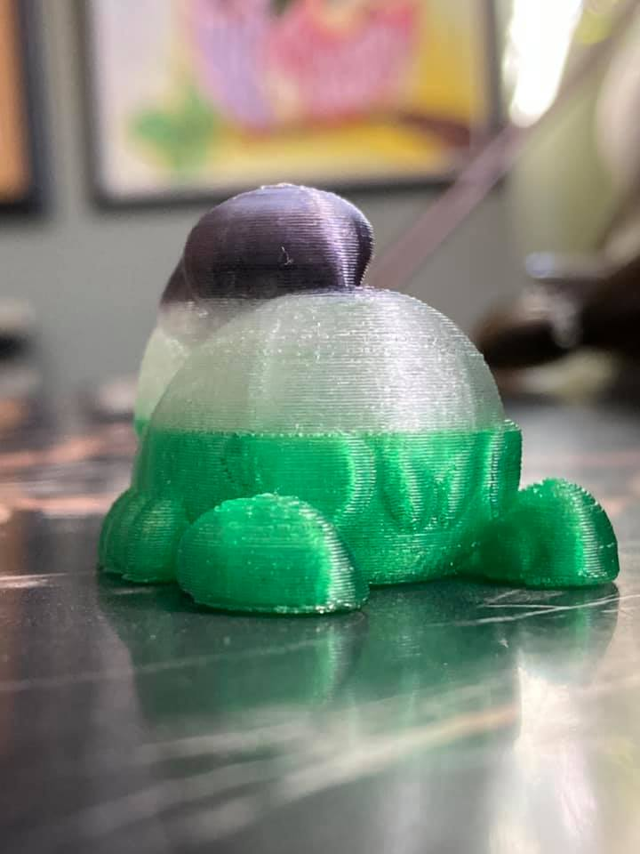
Print Examples/206467332_10226486084957677_5568983026057247678_n.jpg
