joshuartaylor/TheRecreator3D/Print Examples/214222772_10226585749889238_7112928637811003417_n.jpg

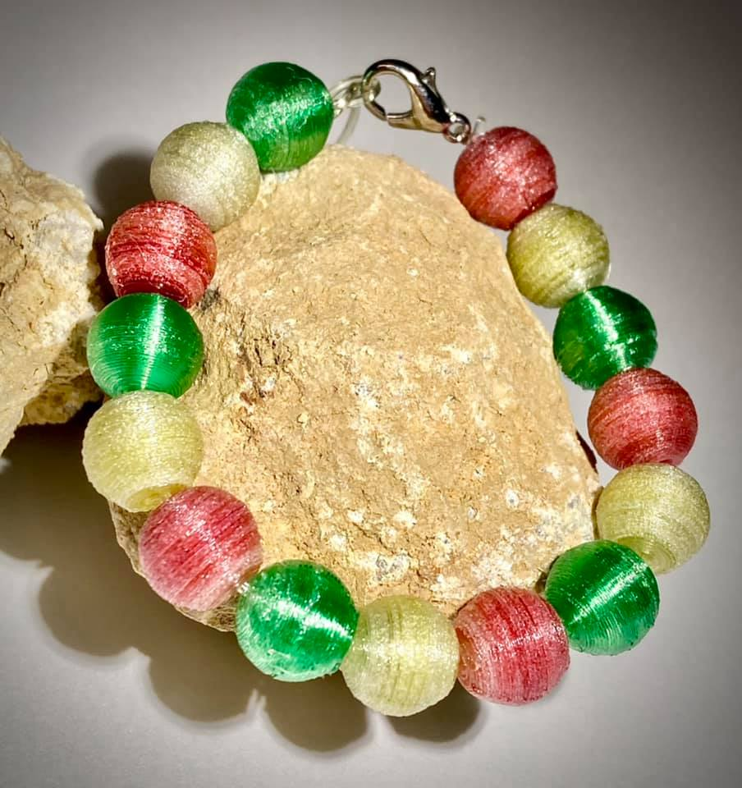
Print Examples/214222772_10226585749889238_7112928637811003417_n.jpg
