joshuartaylor/TheRecreator3D/Print Examples/214885261_491843628787578_3378561823195950535_n.png

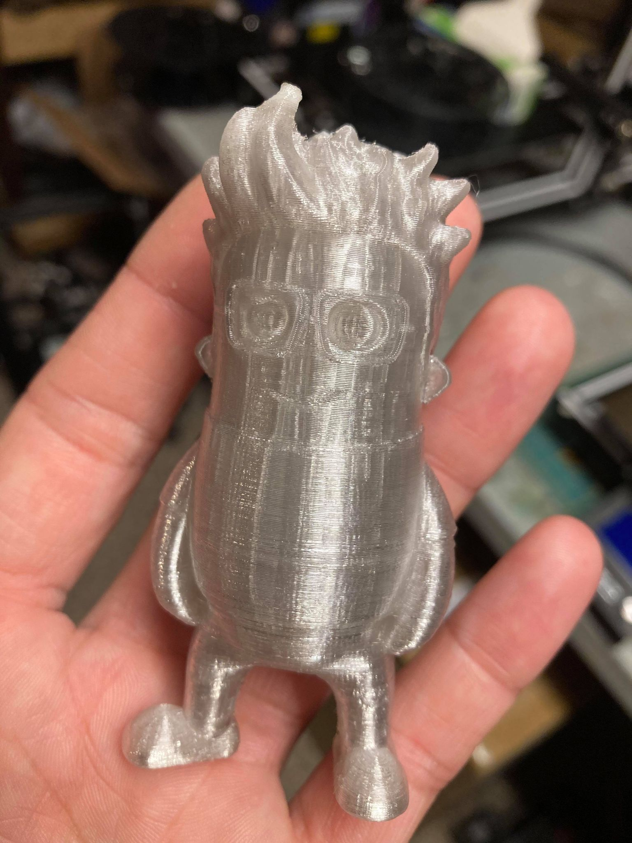
Print Examples/214885261_491843628787578_3378561823195950535_n.png
