joshuartaylor/TheRecreator3D/Print Examples/217662616_10226648263732045_8029452833189872746_n.jpg

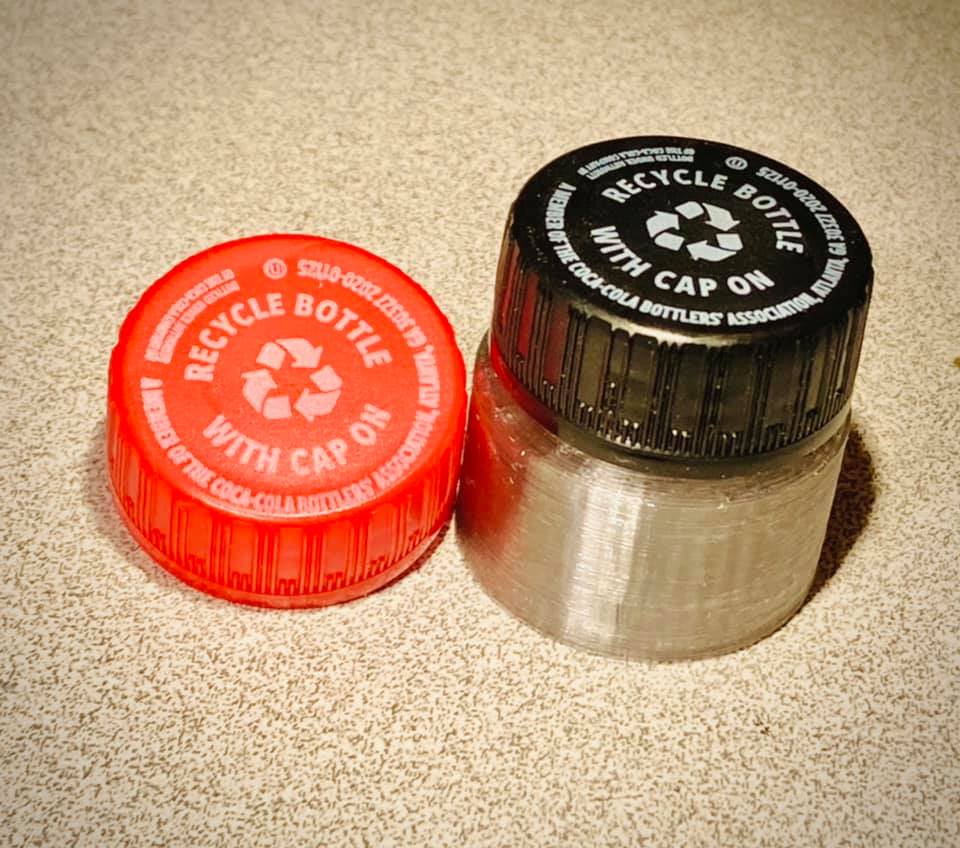
Print Examples/217662616_10226648263732045_8029452833189872746_n.jpg
