joshuartaylor/TheRecreator3D/Print Examples/225679685_10226715622215965_2184227141048911206_n.jpg

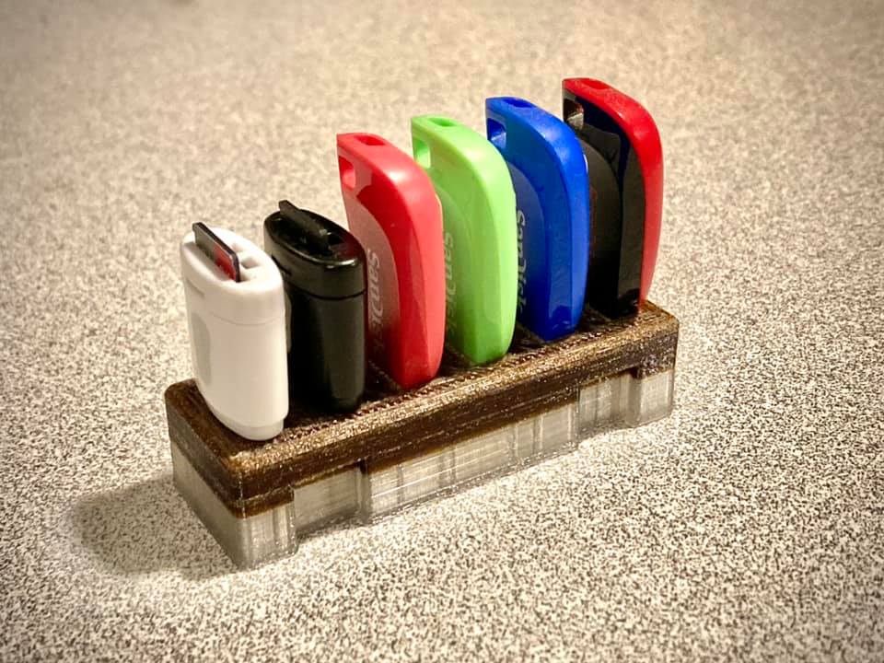
Print Examples/225679685_10226715622215965_2184227141048911206_n.jpg
