joshuartaylor/TheRecreator3D/Print Examples/232505984_10226767239386362_4913174793870732810_n.jpg

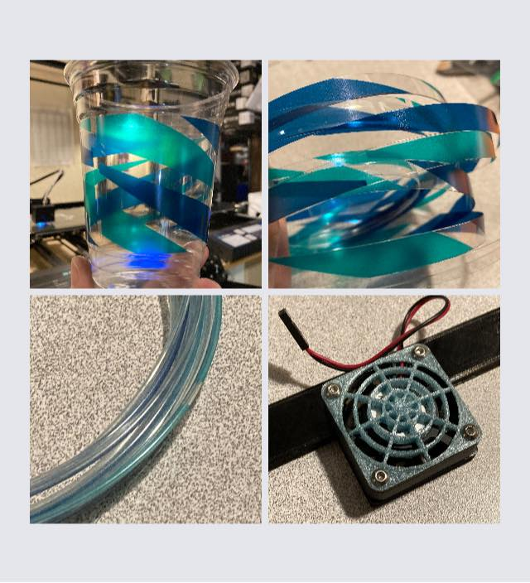
Print Examples/232505984_10226767239386362_4913174793870732810_n.jpg
