joshuartaylor/TheRecreator3D/Print Examples/240935696_10226927602195332_3528407033935992265_n.jpg

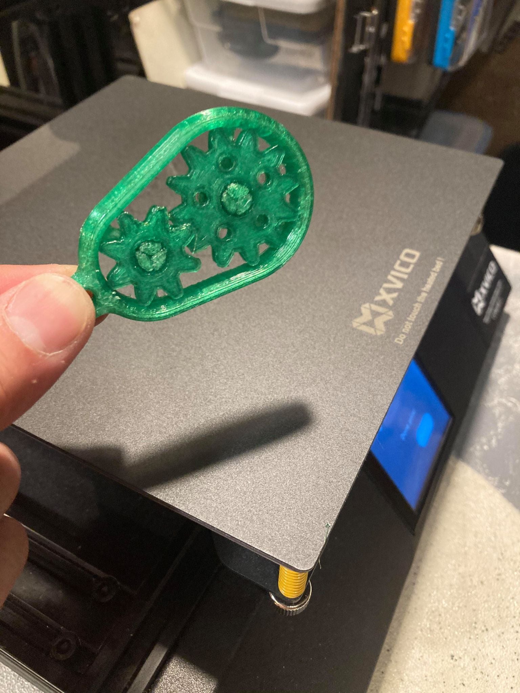
Print Examples/240935696_10226927602195332_3528407033935992265_n.jpg
