joshuartaylor/TheRecreator3D/Print Examples/241407789_10226955746418920_6820689831028400263_n.jpg

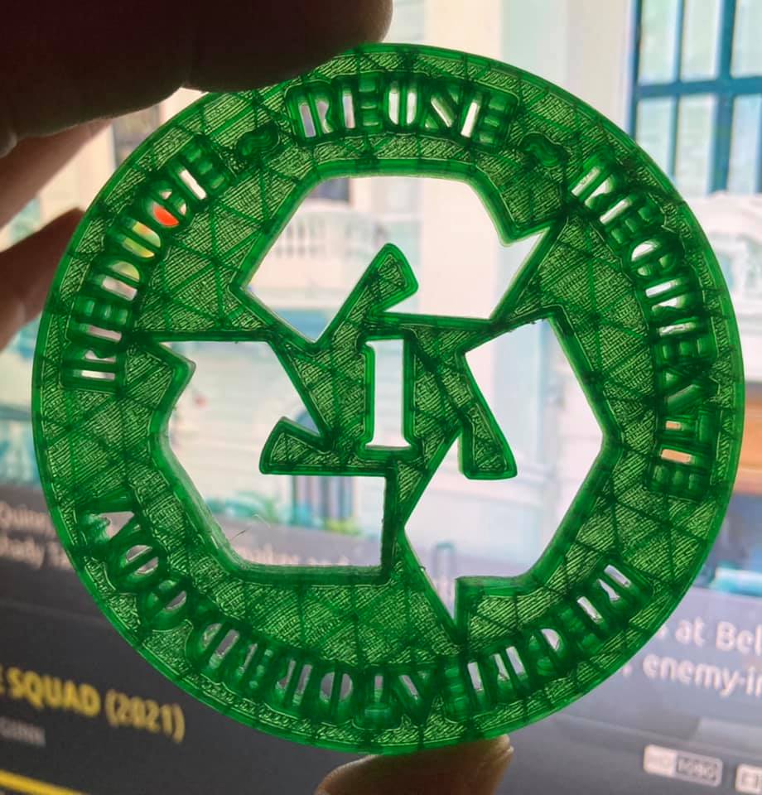
Print Examples/241407789_10226955746418920_6820689831028400263_n.jpg
