joshuartaylor/TheRecreator3D/Print Examples/241538882_10226987476292147_1368373112538948766_n.jpg

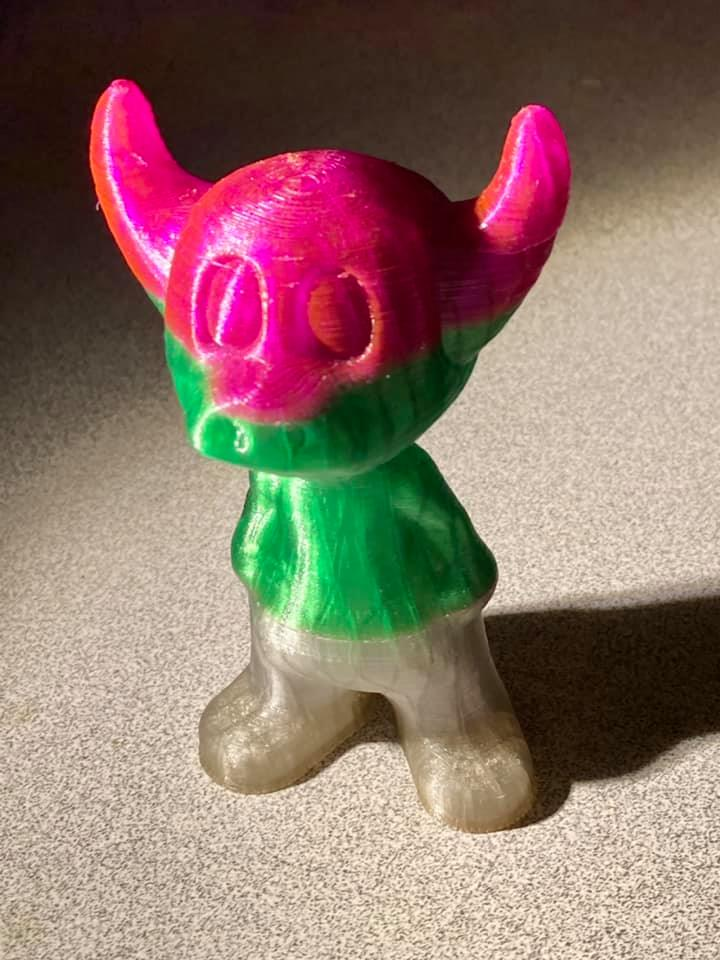
Print Examples/241538882_10226987476292147_1368373112538948766_n.jpg
