joshuartaylor/TheRecreator3D/Print Examples/259515618_10227495680716940_5108927712266496240_n.jpg

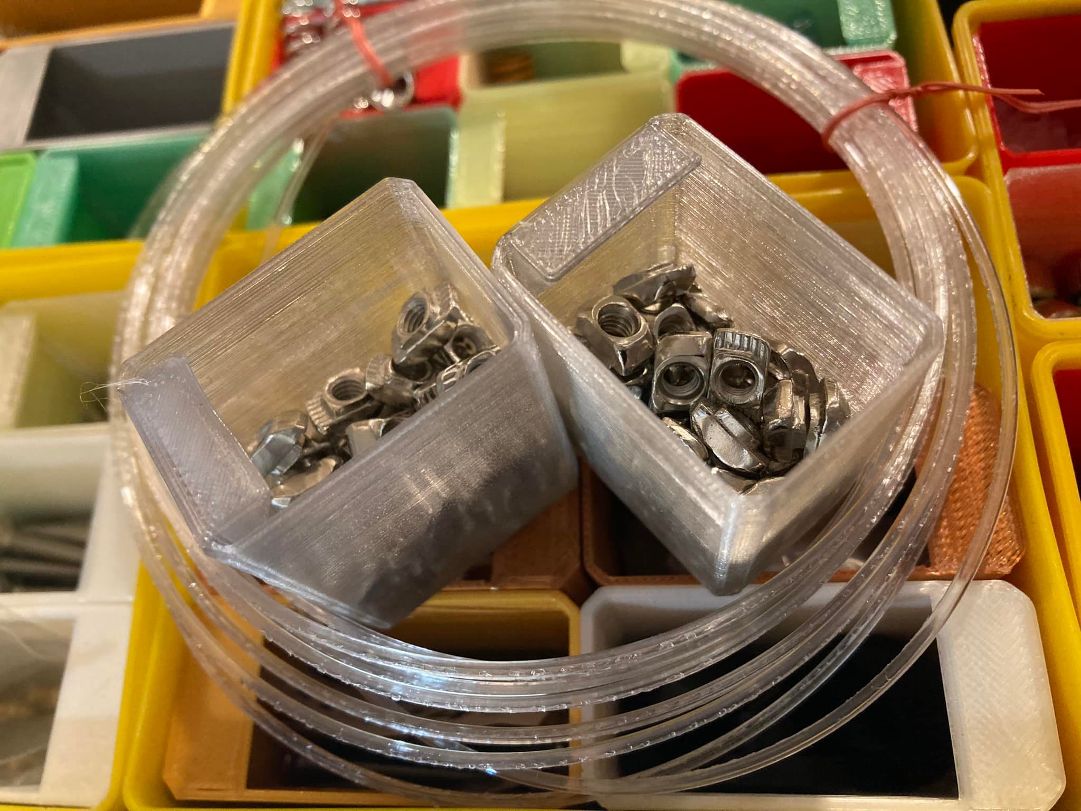
Print Examples/259515618_10227495680716940_5108927712266496240_n.jpg
