joshuartaylor/TheRecreator3D/Print Examples/264905311_10227558388404593_5753321201018407001_n.jpg

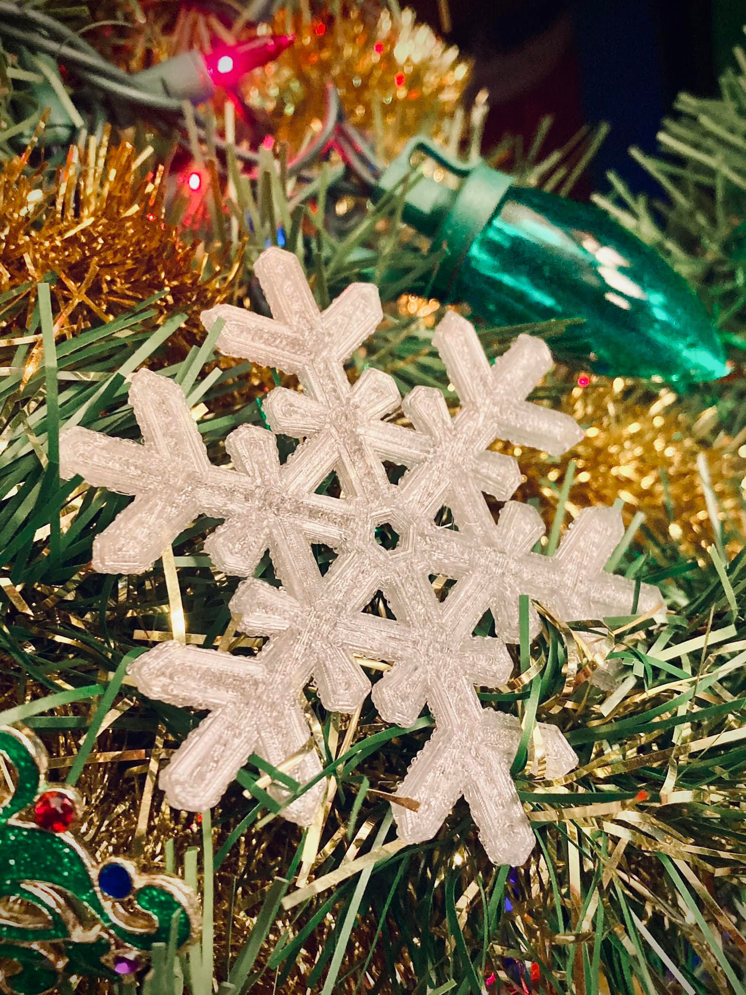
Print Examples/264905311_10227558388404593_5753321201018407001_n.jpg
