joshuartaylor/TheRecreator3D/Print Examples/267519313_10227608364813972_6725411468984750324_n.jpg

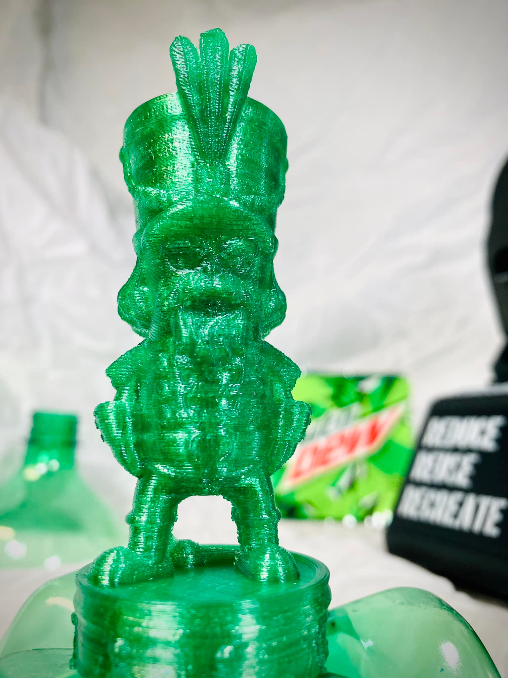
Print Examples/267519313_10227608364813972_6725411468984750324_n.jpg
