joshuartaylor/TheRecreator3D/Print Examples/268976045_10227629474181693_4246662645494979562_n.jpg

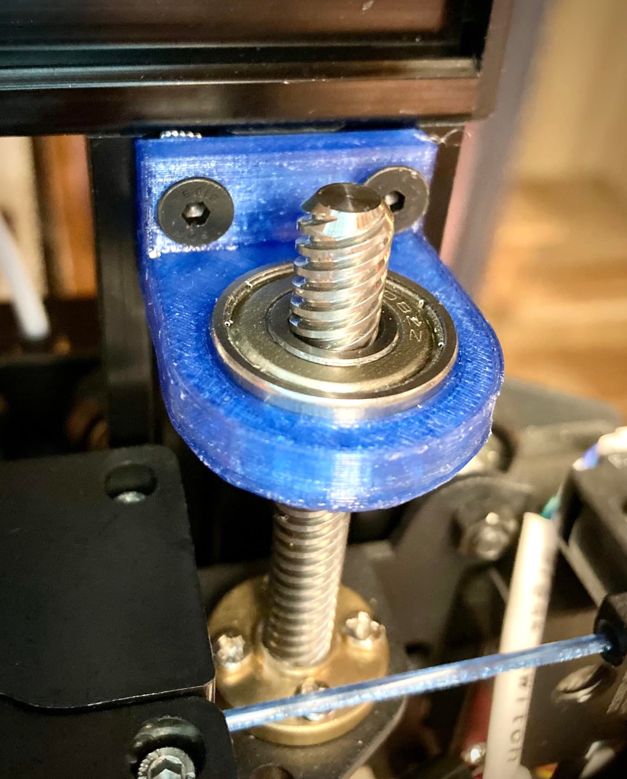
Print Examples/268976045_10227629474181693_4246662645494979562_n.jpg
