joshuartaylor/TheRecreator3D/Print Examples/272962686_10227916931767953_3582923029646015358_n.jpg

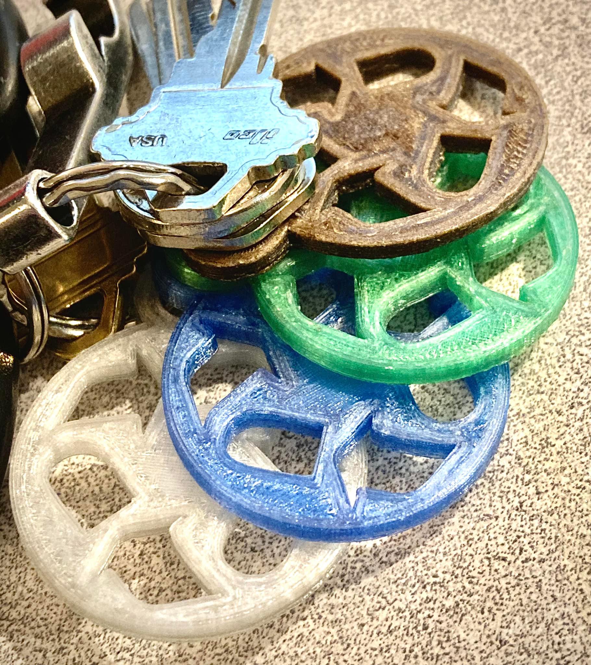
Print Examples/272962686_10227916931767953_3582923029646015358_n.jpg
