joshuartaylor/TheRecreator3D/Print Examples/273216605_10227936485216777_551045739343290642_n.jpg

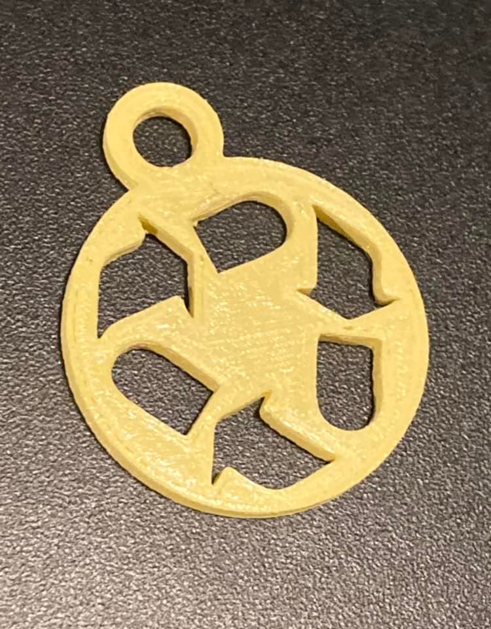
Print Examples/273216605_10227936485216777_551045739343290642_n.jpg
