joshuartaylor/TheRecreator3D/Print Examples/273449655_10227961898252087_7944809284598595394_n.jpg

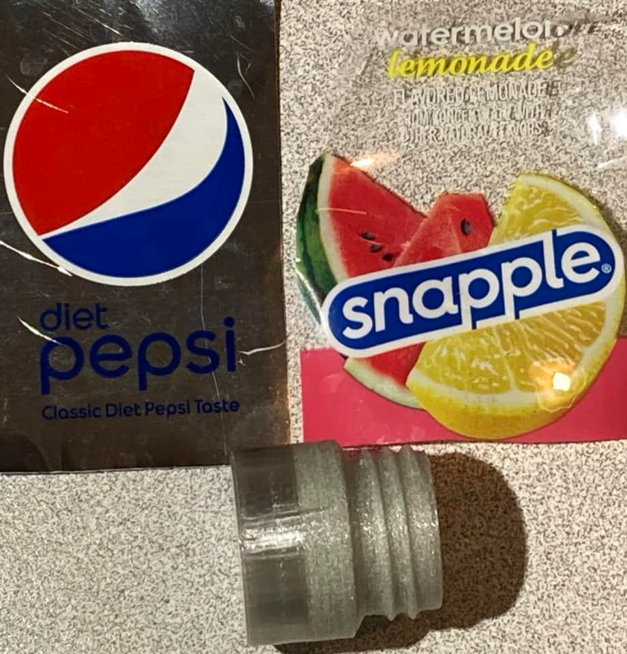
Print Examples/273449655_10227961898252087_7944809284598595394_n.jpg
