joshuartaylor/TheRecreator3D/Print Examples/273621783_10227991040260619_8134718185396074211_n.jpg

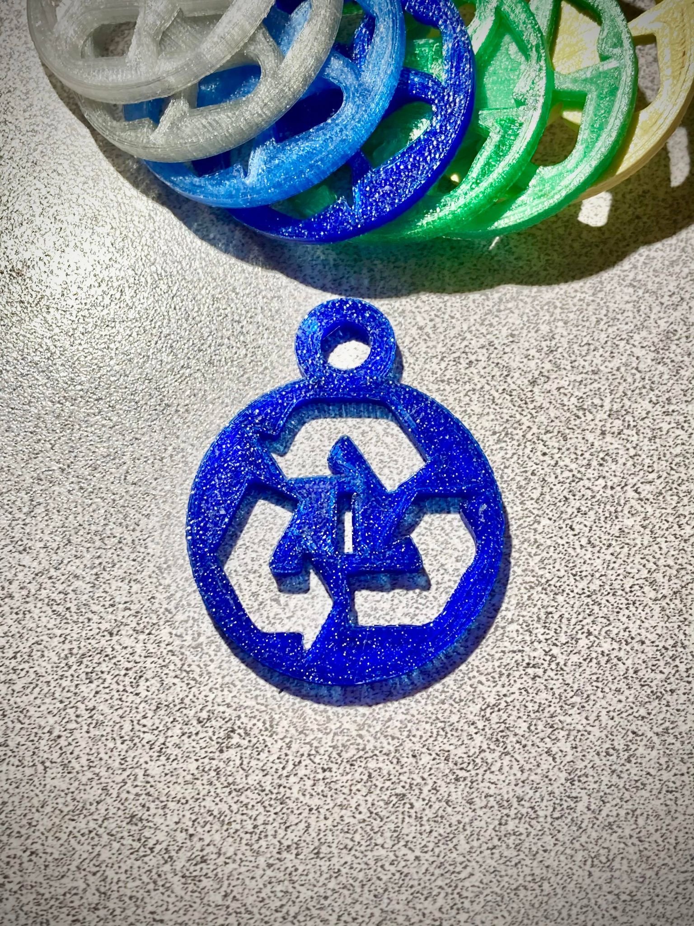
Print Examples/273621783_10227991040260619_8134718185396074211_n.jpg
