joshuartaylor/TheRecreator3D/Print Examples/274855149_10228092305392184_307158305559613205_n.jpg

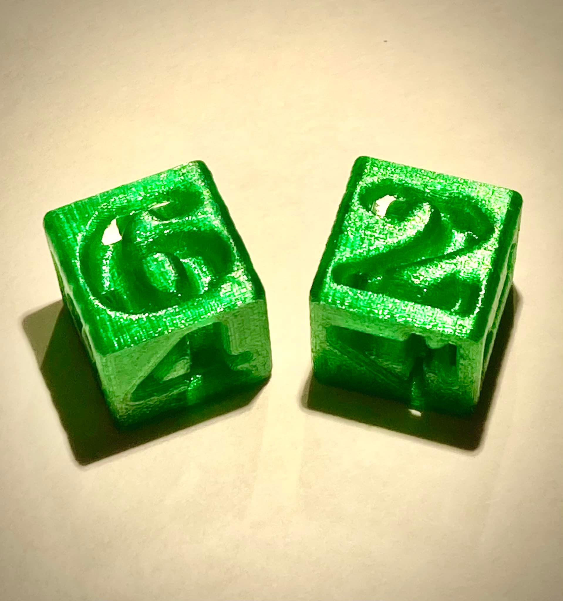
Print Examples/274855149_10228092305392184_307158305559613205_n.jpg
